befinitiv/cmd-z5-pager/hw/PXL_20261023_195703346.MP.jpg

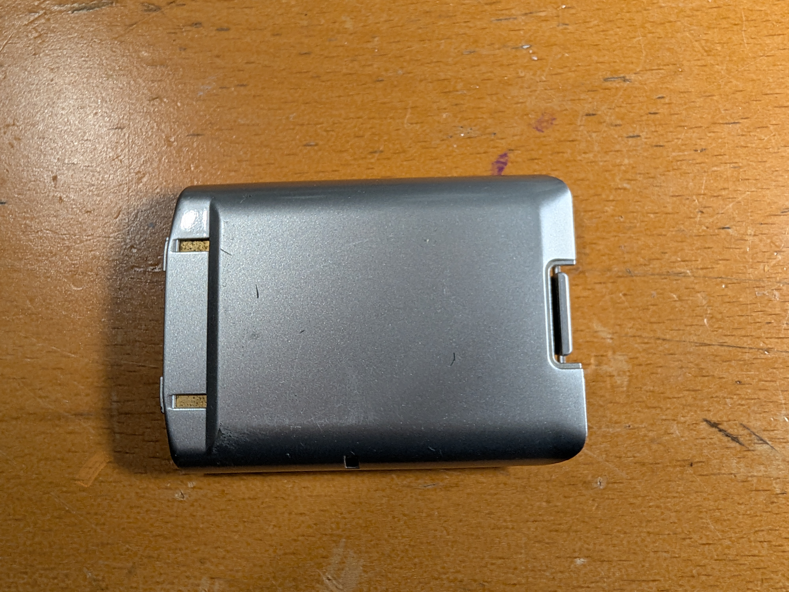
hw/PXL_20261023_195703346.MP.jpg
