befinitiv/cmd-z5-pager/board/kicad/reference/PXL_20261004_193141674.jpg

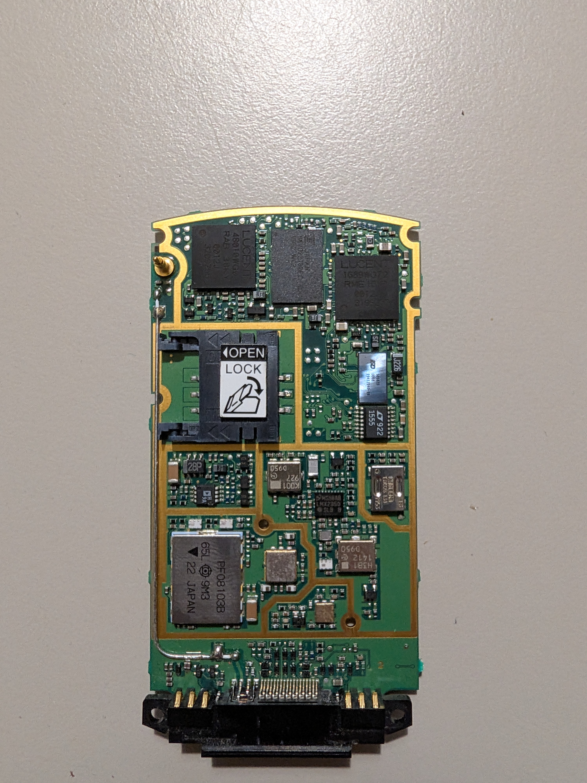
board/kicad/reference/PXL_20261004_193141674.jpg
