befinitiv/cmd-z5-pager/sw/README.md

This document proposes the software architecture for the CMD-Z5 replacement board described in `../board/README.md`. The firmware turns the phone into a standalone Meshtastic and LoRaWAN (TTN) messenger with its own UI and predictive text input. The same code also builds for the PC, where an emulator window stands in for the phone hardware.

Status: phases 1 to 3 are implemented (board definition, emulator, graphics, UI toolkit, menus, hardware test; predictive text with language models for German and English; Meshtastic messaging, tested in the emulator); MeshCore as the other protocol. See [Build and run](#build-and-run) and [Development plan](#development-plan).

# Decisions

| Topic | Decision | Reason |
|---|---|---|
| OS / SDK | Zephyr through the nRF Connect SDK (NCS) | Ready-made drivers for nRF52840, SX1262, nPM1300 (regulators, charger, fuel gauge), LIS2DH12, QDEC, u-blox M10 (GNSS), keypad matrix and USB. Also gives a LoRaWAN stack, BLE, LittleFS/settings, MCUboot and the `native_sim` PC target |
| Meshtastic | Own implementation of the over-the-air protocol, no fork of the Meshtastic firmware | The Meshtastic firmware fills most of the 1 MB flash and has no LoRaWAN. We need only the radio protocol, not the full feature set |
| Phone app (BLE PhoneAPI) | Not in the first version | The architecture leaves room for it (see [Later extensions](#later-extensions)) |
| Predictive text languages | German and English, switchable at runtime | |
| Language model storage | Internal flash, in its own partition | An external SPI NOR flash may come with board rev 2. The model reader only sees a flash area, so the model can move there without code changes |
| PC build | Zephyr `native_sim` with an SDL2 "front panel" | The same kernel, threads, timers, zbus, settings and file system run on the PC. Only the lowest driver layer is swapped |

Assumptions to confirm:

* **Region:** EU868 for both Meshtastic (`EU_868`) and LoRaWAN (TTN EU1).
* **LoRaWAN use case:** periodic uplinks of position and battery, user-triggered text uplinks, and downlinks shown as messages in the inbox.
* **Meshtastic version:** the firmware targets a pinned protobuf release (2.5 or newer, with PKI direct messages).

# Overview

```
┌──────────────────────────────────────────────────────────────────────────┐
│ App / UI   screens: home, inbox, chat, compose, nodes, map/GPS,          │
│            LoRaWAN, settings  ─  screen stack, widgets, status bar       │
├───────────────┬──────────────────────┬───────────────────────────────────┤
│ libtextinput  │ libgfx (2bpp FB,     │ Services (Zephyr threads,         │
│ multitap, T9, │ fonts, icons)        │ connected through zbus)           │
│ n-gram LM,    │                      │  mesh · lorawan · radio arbiter   │
│ user model    │                      │  gps · power · notify · msgstore  │
├───────────────┴──────────────────────┴───────────────────────────────────┤
│ libmeshtastic: protobuf (nanopb), crypto, router, nodedb, port modules   │
├──────────────────────────────────────────────────────────────────────────┤
│ Zephyr device APIs:  input · led · pwm · lora · lorawan · regulator ·    │
│ gnss · charger · fuel gauge · sensor; own: lcd, lcd_bus, audio_out       │
├────────────────────────────────┬─────────────────────────────────────────┤
│ cmdz5 board (nRF52840)         │ native_sim + emulator (SDL2)            │
│ bit-banged LCD bus, gpio-kbd-  │ LCD controller model, PC keyboard and   │
│ matrix, QDEC, PWM audio,       │ mouse wheel, green backlight, 2 audio   │
│ SX1262, nPM1300, LIS2DH12, M10 │ sinks, vibration, radio/GPS/PMIC stubs  │
└────────────────────────────────┴─────────────────────────────────────────┘
```

Rules that keep both builds identical above the driver layer:

1. Application code uses only Zephyr device APIs (`input`, `led`, `lora`, `gnss`, `regulator`, …) and three small custom APIs (`lcd`, `lcd_bus`, `audio_out`). It never touches nRF registers or SDL.
2. The board devicetree and the `native_sim` overlay declare the same node labels (`lcd`, `backlight`, `vibration`, `speaker`, `earpiece`, later `lora0`, `gnss`, `pmic`, …), so `DEVICE_DT_GET(DT_NODELABEL(lcd))` works on both.
3. `libtextinput`, `libgfx` and most of `libmeshtastic` are plain C with no Zephyr dependency. They also build as host unit tests and as a Python extension for the language model tools.

# Directory structure

Entries marked *(later)* do not exist yet.

```
sw/
├── CMakeLists.txt  Kconfig  prj.conf
├── sysbuild.conf  sysbuild/        # board build: MCUboot (single slot, USB serial recovery) + application
├── boards/
│   ├── befi/cmdz5/                  # board definition (HWMv2): dts, pinctrl, defconfig, flash partitions
│   ├── cmdz5_nrf52840.conf          # board-only Kconfig (I2C, PWM, regulators, charger)
│   └── native_sim_native_64.overlay # emulator: same node labels, emulated devices
├── dts/bindings/                    # sony,cmdz5-lcd, cmdz5,lcd-bus-gpio, cmdz5,audio-pwm, cmdz5,sx1262, cmdz5,gps-m10, emulator nodes
├── include/
│   ├── cmdz5/drivers/               # lcd.h, lcd_bus.h, audio_out.h, mesh_radio.h (custom device APIs)
│   └── dt-bindings/cmdz5/keys.h     # key codes without a Zephyr equivalent (CALL, Memo, *, #, lid)
├── drivers/
│   ├── display/cmdz5_lcd.c          # controller driver (init sequence, row writes, contrast, power)
│   ├── display/lcd_bus_gpio.c       # 8080 bus bit-bang, one masked port write per byte on P0.19–P0.26
│   ├── audio/audio_pwm.c            # PCM on PWM1/PWM2 with EasyDMA (8-bit DAC, 62.5 kHz carrier)
│   ├── radio/sx1262_mesh.c          # SX1262 as mesh radio: free sync word, continuous RX, CAD before TX
│   └── gnss/gps_m10.c               # u-blox M10 over NMEA; device PM switches the boost and the UART
├── emul/                            # native_sim only
│   ├── frontpanel.c                 # Zephyr side: input device, state, render thread
│   ├── frontpanel_bottom.c          # host side: SDL2 window, drawing, keyboard/mouse, audio
│   ├── lcd_bus_emul.c               # implements lcd_bus, feeds lcd_ctrl_model
│   ├── lcd_ctrl_model.c             # model of the display controller: registers 03/04/0B → 96×72 2bpp FB
│   ├── led_emul.c  audio_emul.c     # backlight/vibration; speaker/earpiece PCM mixed into SDL audio
│   ├── script.c                     # --script: scripted keys, wheel, lid and screenshots
│   ├── radio_emul.c                 # mesh radio over UDP multicast between emulator instances
│   ├── gps_sim.c                    # feeds Zephyr's GNSS emulator: --gps, --gps-move, --gps-ttff
│   └── battery_emul.c               # simulated battery: current from the emulated outputs, USB from the front panel
├── lib/
│   ├── gfx/                         # 2bpp framebuffer, primitives, fonts, icons, dirty-row tracking
│   ├── ui/                          # screen stack, events, menu, slider, text view
│   ├── textinput/                   # model reader, prediction engine, user model, editor
│   ├── meshtastic/                  # packet codec, crypto (AES, CCM, SHA-256, X25519), channels, router, nodedb
│   ├── meshcore/                    # MeshCore: packets, adverts, Ed25519/SHA-512, client (DMs, ACKs, routes, channels)
│   └── synth/                       # software synthesiser: voices, waveforms, envelopes, melody sequencer
├── src/
│   ├── main.c                       # UI thread and event loop
│   ├── input.c                      # Zephyr input events → UI events, long press
│   ├── hw.c                         # display, backlight, vibration, tones and melodies (lib/synth)
│   ├── power.c                      # backlight and display timeouts, lid, power key
│   ├── battery.c                    # battery sampling (1 s), current averages; backends battery_npm13xx.c / emul
│   ├── i18n.c                       # menu language (English, German)
│   ├── textin.c                     # models, engines and user models per language
│   ├── clock.c  config.c  statusbar.c
│   ├── mesh/                        # mesh service (router thread, identity, nodes), MeshCore mode (meshcore.c), message store
│   ├── services/                    # (later) radio_arbiter, lorawan_svc, gps_svc, notify_svc
│   └── screens/                     # home, menu, settings, hardware test, power off, compose, conversations, chat, nodes; (later) inbox, chat, compose, nodes
├── lm/                              # language models de.lm, en.lm (+ sources and licences)
├── modules/lm_image/                # Zephyr module: model pack for the lm partition, merged.hex
├── cmake/git_version.cmake          # git hash and git describe → app_generated/git_version.h, every build
├── tools/
│   ├── fontconv/                    # BDF → C font headers (X11 misc-misc fonts, public domain)
│   ├── qr/                          # QR code bitmap of the project address for the About screen
│   ├── lmbuild/                     # corpus → n-grams → prune/quantise → .lm; evaluation
│   ├── usb/                         # update.sh (firmware update over USB), udev rule
│   ├── game/                        # level map generator for the jump and run game (1-1, 1-2)
│   └── lcd_replay/                  # (later) replays ../display .dsl captures through lcd_ctrl_model
└── tests/                           # emul/ (smoke.txt, run_mesh.sh, run_meshcore.sh), textinput/, meshtastic/, meshcore/, synth/ and gauge/ (host tests: run.sh)
```

# Hardware abstraction

| Function | Zephyr API / driver (target) | Emulator |
|---|---|---|
| Display 96×72, 2 bpp | `lcd` API → `cmdz5_lcd` → `lcd_bus` (GPIO bit-bang), supply from nPM1300 LDSW1 | `lcd_bus_emul` → `lcd_ctrl_model` → SDL texture, scaled 5× |
| Keypad 4×5 matrix | `input` subsystem, `gpio-kbd-matrix` (supports idle wake through GPIO SENSE) | PC keys and clickable keys on the front panel → `input_report_key()` |
| Rotary wheel | `gpio-qdec` → `INPUT_REL_WHEEL` (GPIO interrupts while idle, so no QDEC current) | mouse wheel, Up/Down keys → `INPUT_REL_WHEEL` |
| Wheel push, bend up/down | keypad matrix row 4 | Space or middle click, Left/Right or PgUp/PgDn (and screen buttons) |
| Lid, power key | `gpio-keys` → `CMDZ5_KEY_LID` (Zephyr has no switch events), `INPUT_KEY_POWER` | `L` key toggles lid (keypad drawn dimmed while closed), `Esc` is the power key |
| Green LEDs (keypad and board) | `led` API on PWM (P0.08), so brightness and fade work | window and keypad area tinted green with the LED brightness |
| Loudspeaker | `audio_out` → PCM through PWM1 EasyDMA on P0.27 (low-side FET) | SDL audio (8-bit like the board), SPK indicator lit |
| Earpiece | `audio_out` → PCM through PWM2 EasyDMA on P0.06 → RC (1 kΩ/10 nF, 16 kHz) → PAM8302 (enabled by LDSW2) | SDL audio, quieter, EAR indicator lit |
| Vibration | `led` API on PWM (P0.07) | display shakes, VIB indicator lit |
| LoRa SX1262 | `mesh_radio` → `sx1262_mesh` (`cmdz5,sx1262`; Zephyr's `lora` API cannot set the Meshtastic sync word 0x2b), power via nPM1300 BUCK1, TCXO on DIO3, RF switch on DIO2 and P0.09 | UDP multicast between emulator instances (`radio_emul`) |
| GPS M10N | `gnss` API → `gps_m10` (`cmdz5,gps-m10`; Zephyr's NMEA parser, factory settings: NMEA at 38400 baud on UART0), 5 V boost EN on P1.03 switched with the UART by device PM | Zephyr's `zephyr,gnss-emul`, switched by device PM and fed by `emul/gps_sim.c` |
| PMIC nPM1300 | `regulator`, `charger` sensor (voltage, current, die temperature, charge and VBUS state); fuel gauge in `src/gauge.c` | simulated battery (`battery_emul.c`): current from the emulated outputs, USB power from the front panel |
| Accelerometer | `sensor` API (`st,lis2dh`), motion trigger | key `A` sends a motion event |
| Microphone | not used in the first version | – |

Three custom APIs are added because Zephyr has nothing suitable (Zephyr's `display` API has no 2 bpp gray format):

* **`lcd`:** `write_rows(fb, first, count)`, `set_contrast()`, `set_power()`. The framebuffer is in the controller's native format, so rows go out without conversion. The application only sends rows that changed.
* **`lcd_bus`:** `write(a0, buf, len)`, `reset()`, `enable()`. The controller driver (`cmdz5_lcd`) sits above it and is shared by target and emulator. The emulator therefore runs the real init sequence and row-addressing code against a model of the controller, which logs a warning for anything the reverse-engineered documentation does not cover. A bug in the driver shows up on the PC before the board exists. `tools/lcd_replay` (later) will feed the logic analyzer captures through the same model.
* **`audio_out`:** a PCM stream per output (`speaker`, `earpiece`): `rate()`, `start(fill, user)`, `stop()`. The output pulls blocks of signed 16-bit samples from `fill()` in its own thread and switches itself off (PWM, amplifier) after a few silent blocks. `src/hw.c` keeps `hw_tone()` and `hw_melody()` and renders them with `lib/synth`; an RTTTL sequencer for ringtones and notifications follows in `notify_svc`. Meshtastic uses RTTTL for its external notification module.

## Sound

**Synthesiser (`lib/synth`):** 4 voices with a band-limited pulse wave (PolyBLEP, any duty cycle), triangle, sine (table) and Game Boy-style noise, attack/decay/sustain/release envelopes, and a melody sequencer with sample-accurate timing on voice 0. Single notes use the other voices, so a key click or a game effect mixes with a running melody instead of cutting it off. Timbres in `src/hw.c`: beeps are short square waves; the loudspeaker plays melodies as a plucked 25 % pulse wave, the earpiece everything as a softer triangle wave. Host tests: `tests/synth/run.sh` (also writes `build-tests/synth_demo.wav`).

**PWM as a DAC (`drivers/audio/audio_pwm.c`):** PWM1 (loudspeaker) and PWM2 (earpiece) count from 16 MHz to 256: an 8-bit duty cycle at a 62.5 kHz carrier, above hearing. Each sample is held for 4 carrier periods, so the sample rate is 15625 Hz. Two EasyDMA sequences of 256 samples (16 ms) play in a loop; at the end of one, an interrupt wakes the audio thread, which renders the next block into it while the other plays. The PWM nodes are disabled for Zephyr's PWM driver; the audio driver uses nrfx and their pinctrl states.

* **Loudspeaker:** a low-side FET switches it between VSYS and ground, so it only sees duty cycles ≥ 0, and a constant mid-level would drive a large DC current through it. Its offset therefore follows the signal peak (`dc-coupled`): the duty cycle swings between 0 and twice the peak, and silence is 0.
* **Earpiece:** the PAM8302 input is AC-coupled (100 nF), so it gets a mid-level offset that ramps up and down in about 8 ms to avoid pops. The 1 kΩ/10 nF RC (16 kHz) in front of it removes most of the carrier.

The HFCLK runs while sound plays; the outputs are switched off about 50 ms after the last sound. The emulator mixes both streams into SDL audio, reduced to 8 bits. Untested on the board: the loudness compared with the earlier square-wave tones, how cleanly the FET-driven loudspeaker plays the PCM, and carrier residue in the earpiece amplifier.

## Emulator details

`native_sim` builds the firmware as a Linux executable. SDL calls must run on the host side of the native simulator, so the front panel is split into a Zephyr-side part (`frontpanel.c`) and a host-side part (`frontpanel_bottom.c`, built against SDL2). This is the same split that Zephyr's own `display_sdl` uses. The SDL event loop is Zephyr's (`boards/native/common/sdl`); the front panel hooks in with `SDL_AddEventWatch`.

Front panel layout: the display at the top (scaled 5×, with the gray levels mixed into the panel colour, which turns green with the backlight), the keypad below it as clickable buttons whose labels glow green with the keypad LEDs, and on the right the wheel, LED/VIB/SPK/EAR/USB indicators, lid switch and power key. Key mapping:

| PC | Phone |
|---|---|
| `0`–`9` (main row or numpad) | digit keys |
| `+` or numpad `*` / `#`, `\` or numpad `/` | `*` / `#` |
| `Enter` | CALL |
| `Backspace` | C |
| `M` | Memo |
| mouse wheel, `Up` / `Down`, click on the wheel | wheel rotate |
| `Space`, middle click | wheel push |
| `Left` / `PgUp` | wheel bend up (back) |
| `Right` / `PgDn` | wheel bend down |
| `L` | toggle the lid |
| `U`, click on the USB indicator | plug or unplug USB power (charges the simulated battery) |
| `Esc` | power key: short = home screen, hold 1.5 s and release = switch off (C major arpeggio, top to bottom); while off, hold 1 s = switch on (restarts the emulator) |
| `F12` | save the display as `cmdz5-screen-NNN.bmp` |

The lid covers only the keypad; the display stays visible. Closing it returns to the home screen and switches the backlight off. Keypad keys are ignored while it is closed, the side controls (wheel, push, bend, power) still work.

Settings are stored in `flash.bin` in the working directory (Zephyr's flash simulator).

After a restart (switching on again) the emulator starts with the same arguments, so a `--script` runs again.

`--script=<file>` runs front panel commands (`wait`, `key`, `press`, `release`, `wheel`, `lid`, `usb`, `shot`, `quit`, see `emul/script.c`) for UI tests and screenshots. With `SDL_VIDEODRIVER=offscreen SDL_AUDIODRIVER=dummy` it runs without a window and sound, e.g. in CI. `tests/emul/smoke.txt` walks through all current screens.

**Emulated radio** (`emul/radio_emul.c`): packets travel as UDP multicast on the loopback interface, so emulator instances on the same machine form a mesh. Each packet carries the radio settings (frequency, bandwidth, spreading factor, sync word); only instances with the same settings receive it. The channel is shared like a real one: a packet goes out when its transmission starts and is delivered at the end of its time on air, so the channel is busy in between. A sender listens before it talks (free channel, then a random backoff of 0–7 slots of 4 symbols, as channel activity detection does on the board). Packets that overlap at a receiver are lost, and the radio cannot receive while it transmits. Options: `--node-num=<hex>`, `--radio-port=<n>` (default 4403), `--radio-off`, `--no-clock` (start without the PC's time, like the board: the time then comes from GPS or the mesh). Run each instance in its own directory, because the settings (and so the node identity) are stored in `flash.bin` in the working directory:

```
mkdir -p /tmp/a /tmp/b
(cd /tmp/a && ~/repos/cmd-z5/sw/build-sim/zephyr/zephyr.exe --node-num=aaaa0001) &
(cd /tmp/b && ~/repos/cmd-z5/sw/build-sim/zephyr/zephyr.exe --node-num=bbbb0002) &
```

**Emulated GPS** (`emul/gps_sim.c`): Zephyr's GNSS emulator (`CONFIG_GNSS_EMUL_MANUAL_UPDATE`), switched on and off through device power management like the real receiver. While it is on, it searches for `--gps-ttff=<s>` seconds (default 8, plus a random 0–3 s, with a few satellites showing up) and then reports the position from `--gps=<lat>,<lon>[,<alt>]`, moving with `--gps-move=<m/s>,<heading>`. Without `--gps` it never gets a fix. Example: two instances 11 km apart, B walking north-east:

```
(cd /tmp/a && ~/repos/cmd-z5/sw/build-sim/zephyr/zephyr.exe --node-num=aaaa0001 --gps=52.52,13.405,34) &
(cd /tmp/b && ~/repos/cmd-z5/sw/build-sim/zephyr/zephyr.exe --node-num=bbbb0002 --gps=52.60,13.50 --gps-move=1.4,45) &
```

# Concurrency and services

All services are Zephyr threads or work-queue items and communicate only through **zbus** channels. The UI never blocks on the radio, and every service can be tested on its own.

| Channel | Producer → consumer | Content |
|---|---|---|
| `input_evt` | input subsystem → UI | key, wheel, lid, power |
| `msg_rx` | mesh_svc, lorawan_svc → msgstore, notify, UI | received text and data |
| `msg_tx` | UI → mesh_svc / lorawan_svc | outgoing message with a tracking ID |
| `msg_status` | mesh_svc → UI | queued, sent, acked, failed |
| `node_update` | mesh_svc → nodestore, UI | NodeInfo, position, SNR, last heard |
| `gps_fix` | gps_svc → mesh_svc, lorawan_svc, UI | position, time |
| `power_state` | power_svc → all | active, dim, screen off, deep sleep; battery level, charging |
| `radio_state` | radio_arbiter → UI | current owner, duty-cycle budget |
| `notify_req` | any → notify_svc | pattern for LEDs, vibration and sound |

## Radio arbiter (Meshtastic and LoRaWAN on one SX1262)

The SX1262 can only listen on one frequency and sync word at a time. Meshtastic needs continuous RX (sync word 0x2B, 869.525 MHz for `EU_868`). LoRaWAN class A only needs the radio for TX and the RX1/RX2 windows (sync word 0x34, 868.1–868.5 MHz, RX2 at 869.525 MHz SF9).

* **Default owner:** Meshtastic, with the radio in continuous RX.
* **LoRaWAN lease:** before an uplink, `lorawan_svc` asks the arbiter for a lease. The arbiter waits until no Meshtastic packet is being received or sent, stops RX, hands the radio to the Zephyr LoRaWAN stack for TX + RX1 + RX2 (about 3 s), then restores the Meshtastic configuration. Meshtastic packets sent during the lease are lost, but the mesh's rebroadcasts and retries usually cover that.
* **Duty cycle:** the arbiter keeps one airtime budget per EU868 sub-band for both protocols (1 % for 868.0–868.6 MHz, 10 % for 869.4–869.65 MHz).
* **Risk:** the Zephyr LoRaWAN subsystem (LoRaMac-node) assumes it owns the radio. Prototype switching between raw `lora` RX and `lorawan_send()` early, on real hardware. If it fails, the fallback is a time-sliced mode with LoRaWAN uplinks only at fixed intervals and the LoRaMac stack paused in between.

## Meshtastic (`lib/meshtastic`, `src/mesh`)

Implemented in phase 3: the over-the-air protocol of current Meshtastic firmware (2.6/2.7). The protocol details were taken from the Meshtastic sources (header layout, nonces, channel hash, frequency slot, presets, flooding rules); no Meshtastic code or generated protobuf code is used, so their GPL licence does not apply to this firmware.

| Module | Content |
|---|---|
| `packet` | 16-byte header (to, from, id, flags with hop limit, want-ack and hop start, channel hash, next hop, relay node); a hand-written protobuf codec for Data, User (NodeInfo), Position and Routing |
| `crypto` | AES-128/256, CTR, CCM, SHA-256, X25519 in plain C. Channel messages: AES-CTR with the channel key, nonce = packet id (64-bit LE) + sender. Direct messages ("PKI"): AES-256-CCM with SHA-256 of the X25519 secret, 8-byte tag + 4-byte extra nonce. Current Meshtastic firmware refuses to send direct messages to nodes without a public key, so PKI is needed to receive DMs |
| `channel` | key expansion (one-byte PSK index → default key), channel hash (XOR of name and key), frequency slot (djb2 of the channel name), presets LongFast … ShortTurbo, regions EU_868, US, EU_433, slot time, time on air |
| `router` | managed flooding: duplicate history, rebroadcast with hop_limit − 1 after an SNR-weighted delay (distant nodes first), cancelled when another node relays first; ACKs for `want_ack`, 3 retries, implicit ACK for broadcasts (hearing a relay), re-ACK of retries, NAK handling; PKI for direct text messages when the key is known, else the channel key |
| `nodedb` | 48 nodes: user info and public key, position, last heard, SNR, RSSI, hops; least recently heard replaced |

The mesh service (`src/mesh/mesh.c`) runs the router in its own thread:

* **Identity:** node number from the chip's device id (emulator: random or `--node-num`), X25519 key pair from the entropy source, default names "CMD-Z5 xxxx" / "xxxx"; all kept in the settings.
* **NodeInfo:** broadcast 5–15 s after the start and every 3 hours; answered when requested; a node that sends something without being known gets our NodeInfo with a request for its own (rate-limited), so keys are exchanged quickly.
* **Messages** (`msgstore.c`): the primary channel and one conversation per node, the newest 40 messages, delivery status queued → sent → delivered / no relay / failed. They are stored in LittleFS (`msglog.c`, `/lfs/msgs.log`): new messages, status changes and read marks are appended as small records and replayed at startup; above 24 KB the log is rewritten with the current messages only. Messages that were still queued when the device stopped are shown as failed.
* **Nodes** with user info and position are stored in the settings and survive a restart (a received position is stored again only after the node moved 100 m, the time last heard at most once a day). The table holds 48 nodes; when it is full, a node without user info is replaced first, else the one heard longest ago, and the replaced node is deleted from the settings too. Nodes with a direct-message conversation are never replaced, so their public keys stay. Direct messages to a node whose key is unknown wait up to 30 s for it: the node is asked for its NodeInfo (current Meshtastic firmware refuses DMs without PKI).
* **Position** (`POSITION_APP`): our position from the GPS service (`src/gps.c`) is broadcast after the first fix, every 15 min, when the sharing setting changes, and after moving 100 m but at most every 30 s (the Meshtastic defaults for `position_broadcast_secs` and smart broadcast). Settings → Position → Share: off, approximate (Meshtastic `precision_bits` 13: rounded to the middle of a cell of about 6 km, "within 2.9 km") or exact (with altitude and satellites). The location source is "internal" for GPS fixes and "manual" for a fixed position. A position request addressed to us (`want_response`) is answered, at most every 10 min per node. Node details show distance and compass direction to a node ("~" when it shares only an approximate position) and the age of its position.
* **Time** (`src/clock.c`): the clock is kept in UTC and ranked by source: none < mesh < GPS (< the PC's time in the emulator). The time field of received Position packets sets it while there is no better time, as stock firmware does ("time from net"): only times after 2026-01-01, not via MQTT, at most 3 hops; the mesh may correct its own time after an hour, and a GPS fix always overrides it. Local time follows Settings → Time zone (UTC, WET, CET (default), EET, US Eastern/Central/Mountain/Pacific) with the EU and US daylight saving rules; the zone is stored under `clock/zone`. The time of received Telemetry packets is used in the same way.
* **Telemetry** (`TELEMETRY_APP`): received device metrics (battery level and voltage, channel utilisation, airtime, uptime) and environment metrics (temperature, humidity, air pressure) are kept per node in RAM, merged because they arrive in separate packets, and shown in the node details. Other variants (power, air quality, ...) are skipped.
* **Relaying:** other nodes' packets are rebroadcast once (managed flooding, see the router). Settings → Mesh → Relay packets switches this off (stored under `mesh/relay`, default on), like Meshtastic's CLIENT_MUTE role: the device still receives and sends its own packets. Diagnostics shows the number of rebroadcasts sent since the start (queued ones that were cancelled because another node relayed first are not counted).
* **New messages:** sound, vibration and the display wakes up. The home screen shows a preview; on other screens a pop-up (`ui_toast()`) shows the sender and the start of the text for 8 s, unless that conversation is open. Push opens the conversation; any other key only closes the pop-up.

Tested on the host (`tests/meshtastic/run.sh`): crypto against FIPS-197 and RFC 7748 vectors and against vectors generated with Python `cryptography`; the LongFast channel hash (8) and the US LongFast frequency (906.875 MHz) as seen on real meshes; router scenarios in a simulated network (two-hop flooding, implicit ACK, encrypted DM over two hops with ACK, fallback to the channel key, retries until failed, lost ACK, relay cancelled in a triangle, foreign channel relayed but not delivered). In the emulator, `tests/emul/run_mesh.sh` lets two instances exchange a channel message, an encrypted direct message and their positions. A test against a stock Meshtastic node needs the board (phase 5).

Not yet: secondary channels, position requests from the UI, sending telemetry, traceroute, next-hop routing (packets are flooded), duty-cycle accounting, the PhoneAPI.

## MeshCore (`lib/meshcore`, `src/mesh/meshcore.c`)

The other protocol: Settings → Mesh → Protocol switches between Meshtastic and MeshCore (stored under `mesh/proto`; the device restarts). The two do not run at the same time. Each protocol has its own identity, nodes, channels and messages (MeshCore's under `mc/` in the settings and in `/lfs/mcmsgs.log`); the name is shared. The device is a MeshCore companion: it sends and receives, but never repeats. The protocol details follow the MeshCore sources (companion 1.18: `Mesh.cpp`, `BaseChatMesh.cpp`, the companion firmware); no MeshCore code is used.

| Part | Contents |
|---|---|
| `packet` | Header (route type, payload type, version), transport codes, path (1–3-byte hashes), payload; packet hash (SHA-256 of type and payload) for duplicates; region scopes: transport code = HMAC-SHA256 with SHA-256 of `#region`; channel keys: Public, hashtag channels (SHA-256 of `#name`) |
| `advert` | Public key, time, Ed25519 signature, type (companion, repeater, room server, sensor), position (1e-6 degrees) and name in 32 bytes |
| `crypto` | SHA-512 and Ed25519 (after TweetNaCl, keys in orlp/ed25519's format as MeshCore stores them), shared secret by X25519 with the Edwards key converted to Montgomery form; AES-128-ECB with a 2-byte HMAC-SHA256 ("encrypt then MAC"). AES, SHA-256 and X25519 come from `lib/meshtastic` |
| `mesh` | The client: duplicate table, transmit queue with delays, DMs with ACK (SHA-256 of time, flags, text and the sender's key), up to 3 attempts (the last by flood), paths learned from PATH packets (with the ACK in them) and returned, group messages ("name: text") and their repeat as delivery check, adverts (zero-hop or flood) |

The mesh service runs it in its own thread (`meshcore.c`):

* **Radio:** the MeshCore app's presets (Settings → Mesh → Preset): EU narrow (869.618 MHz, 62.5 kHz, SF8, CR 4/5, the default), EU long and medium (869.525 MHz, 250 kHz, SF11/SF10), US narrow (910.525 MHz, 62.5 kHz, SF7); sync word 0x12, preamble 32 symbols up to SF8 (else 16), 22 dBm.
* **Region** (Settings → Mesh → Region, e.g. `de-sh`): floods carry the region's transport code. Repeaters set up with regions forward only floods of regions they serve; without a region a flood may not get far.
* **Contacts** come from adverts (signature checked, older adverts of a node ignored) into the node database: number = the first 4 bytes of the public key, short name = the hash byte that stands for the node in paths, role = advert type. They are stored with their route (`mc/n/<num>`). Node details show the type and the route (flood, direct or the repeater hashes).
* **Adverts:** our own (name, position as set under Position → Share) is flooded 10–15 s after the start (once the clock is set, at most 2 min later), every 12 hours, and from Settings → Mesh → Send advert. Advert and message times rise even without a clock (from the last advert's time).
* **Messages:** DMs go along the known route, else by flood; "delivered" when the ACK comes. Channel messages: Public and up to three channels: hashtag channels (`#ping`: the key from the lower-case name, as in the app) or private ones with a passphrase; Settings → Mesh → Channels → Key shows the key in hex for the app. A channel message counts as delivered when a repeater is heard sending it on ("no relay" otherwise). The sender's name of channel messages is in the text; the chat shows it as the header. Texts are limited to 160 bytes (channels: minus the name).
* **Hops** in the chat header: messages by flood show the repeaters they passed ("2 hops"); messages along a route do not tell, so the header shows the length of our route back to the sender instead ("route 1 hop", "direct").
* **Time:** from messages and companions' adverts (at most 3 hops), as for Meshtastic.

Tested on the host (`tests/meshcore/run.sh`): SHA-512 (FIPS 180-4), Ed25519 (RFC 8032 and vectors from Python `cryptography`), shared secrets (Python, and MeshCore's own test key pair), AES decryption (FIPS-197), HMAC (RFC 4231); the Public channel hash (0x11), the `#ping` key and a `de-sh` transport code; advert round trip and forgery; a simulated A–repeater–B network: adverts, flooded DM with PATH/ACK and learned routes in both directions, direct DM, 160-byte limit, channel message and its repeat, retries with a broken route ending in a flood, failure, scoped and unscoped floods at a regional repeater, hashtag channels. In the emulator, `tests/emul/run_meshcore.sh` lets two instances (`--meshcore`) exchange adverts, a channel message and an acknowledged DM.

Not yet: logins to repeaters and room servers, CLI commands, telemetry requests, traces, a channel QR code for the app.

## LoRaWAN (`lorawan_svc`)

Uses the Zephyr LoRaWAN subsystem (OTAA, EU868, class A). DevEUI, JoinEUI and AppKey are entered in the settings or over the USB shell and stored with the settings subsystem. The DevNonce is kept persistently because LoRaWAN 1.0.4 requires it. Uplinks: Cayenne LPP for position and battery (so TTN decodes them without a custom formatter), and port 10 for UTF-8 text. Downlinks appear in the inbox as a "TTN" conversation.

## GPS (`src/gps.c`)

The GPS service switches the receiver (Zephyr GNSS device `gnss`) through device power management, takes its fixes from the GNSS data callback and passes new positions to the mesh. Modes (Settings → Position → GPS):

| Mode | Receiver | Position |
|---|---|---|
| off | off | none |
| fixed | off | the position entered under "Fixed position" (degrees, e.g. `52.52 13.405`, south and west negative) or taken from the last fix with "Use GPS fix" |
| 5 / 15 (default) / 30 / 60 min | on at the start and then every interval, until 3 fixes in a row with HDOP ≤ 5 or for at most 120 s | the last good fix |
| always | on | the latest fix |

While the GPS screen is open the receiver stays on. A fix sets the clock when it has no GPS time yet or is more than 2 s off. The GPS screen shows the state (searching with time and satellites, fix, off, fixed), the coordinates, altitude, HDOP and the age of the fix, or the speed when moving; push opens the position settings.

On the board the receiver is a TBS M10N (u-blox M10, firmware SPG 5.10, protocol 34.10; GPS, GLONASS, Galileo, BeiDou, SBAS, QZSS) on UART0 at its factory settings (NMEA at 38400 baud, one fix per second). `drivers/gnss/gps_m10.c` feeds GGA and RMC to Zephyr's NMEA 0183 parser; resuming the device switches on the 5 V boost (P1.03) and opens the UART, suspending closes the UART, puts its pins to their sleep state (so they cannot back-power the receiver) and switches the boost off. Zephyr's `gnss-nmea-generic` driver cannot be suspended, and its u-blox driver is for the M8. MCUboot leaves UART0 disabled. Tested indoors: switching on and off, NMEA arriving and parsed (no fix yet); a fix outdoors is still to be tested. Every fix from power-on is a cold start (~30 s) unless the TBS M10N keeps its almanac with a backup supply, which still needs checking.

## Power (`power_svc`)

| State | Display | Backlight | LoRa | GPS | Typical entry |
|---|---|---|---|---|---|
| Active | on | on | RX | per setting | key press, lid opened |
| Dim | on | off | RX | per setting | light timeout (default 10 s, can be "never"), lid closed (also returns to the home screen) |
| Screen off | off (LDSW1 off) | off | RX | per setting | screen timeout (default never) |
| Low power | off | off | off (BUCK1 off) | off | user choice, or low battery |
| Off (ship mode) | – | – | – | – | power key held 1.5 s and released; battery empty (below 3.3 V for 10 s without USB, `BATTERY_EMPTY_MV`: the cell is at 0 % there, its protection would only cut off at 2.75 V). Hold the power key about 1 s to switch on again (`ship-to-active-time-ms`). With USB connected the PMIC cannot stay in ship mode: the firmware restarts into an off state instead (`hw_boot_off()`, marked in GPREGRET2): display, mesh and GPS off, the battery charges; holding the power key 1.5 s switches on, unplugging USB enters ship mode |

`power_svc` enforces the rules from the board README: drive or float the signal lines of switched-off parts, rows on SENSE, columns low. Waking in low-power mode comes from keys, lid, power key, accelerometer or RTC (for scheduled LoRaWAN uplinks). Zephyr device runtime PM switches off the drivers; the nPM1300 regulators are switched through the `regulator` API. Charger setup (current, termination voltage, NTC disabled) happens early in boot, because the nPM1300 starts with charging disabled.

### Battery and current measurement (`src/battery.c`)

A thread samples the battery once a second. On the board the nPM1300 charger driver measures battery voltage, current and die temperature (the battery has no NTC, so the die temperature stands in for it), plus the charge and VBUS state. The fuel gauge (`src/gauge.c`) turns these into the state of charge and the times to empty and full; its state of charge is stored in the settings (`batt/g`) every 6 hours and before switching off. The emulator simulates the battery instead: a cell as the gauge assumes it, charged like on the board, whose current follows the emulated outputs with the estimates below (radio RX 4.5 mA, TX 110 mA, backlight 15 mA, vibration 80 mA, speaker 60 mA, earpiece 15 mA; the display is not counted), quantised like the nPM1300 ADC and fed through the same gauge.

The current resolution follows the discharge limit in the devicetree: full scale is 1.12 × the limit, 10 bits. With the 1 A limit one step is 1.1 mA, so single readings of the 4.5 mA receive current are coarse; the averages over a minute and an hour smooth this out. The 200 mA limit would give 0.22 mA steps, but the battery could then not supply transmit, loudspeaker, vibration and backlight at the same time. Currents in the µA range (low-power mode) are below the resolution and need an external meter such as the PPK2.

**Diagnostics** (main menu) shows charge, voltage, supply (battery, USB charging, charged, charger error), the latest current, the averages over the last minute and hour, the charge drawn since the start, the time to empty or to full, the temperature and the uptime. The status bar shows the charge and a lightning bolt while USB power is present.

**Cell and fuel gauge:** the cell is a 603450 LiPo (3.7 V, 4.2 V charge voltage, 1250 mAh nominal, 1100 mAh typical, protection circuit) with a JST PH 2.0 plug, connected to J8. It is charged at 400 mA (about 0.33 C) until the current falls to 10 % (40 mA). nRF Fuel Gauge would need a model made by profiling the cell with the nPM1300 EK and nPM PowerUP, so `src/gauge.c` is a simple gauge built on assumptions instead: 1100 mAh usable, about 200 mΩ internal resistance with the protection circuit and wires (to be measured: the voltage drop when the GPS adds 160 mA) and a typical LiPo open-circuit voltage curve. It counts the measured current, sets 100 % when the charger reports complete, and pulls the count towards the voltage estimate when the battery has been nearly at rest (< 30 mA) for 5 min: slowly (1 h) and only beyond 5 %, because the curve is flat in the middle, faster near empty. While the charger is in its constant-current phase it shows at most 95 %. The host test (`tests/gauge/run.sh`) runs it against a worse cell (950 mAh, 240 mΩ, a current offset) over a day with GPS bursts: it overestimates by at most 5 % and is at 0 % when the cell is empty. A discharge cycle on the board, logged to LittleFS, would replace the assumptions with measured values.

## Storage

| Data | Mechanism | Location |
|---|---|---|
| Settings, node identity and keys, known nodes, learned words | Zephyr settings on NVS | `storage` partition (32 KB) |
| Messages | LittleFS, append-only log | `lfs` partition (96 KB) |
| Language models | read-only pack, memory-mapped | `lm` partition (352 KB; later on external flash) |

# User interface

## Display and graphics (`lib/gfx`)

The framebuffer is 96 × 72 pixels at 2 bpp = 1728 bytes, in the native format of the display (24 bytes per row, MSB = leftmost pixel). `gfx` keeps a dirty bit per row, and `cmdz5_lcd` only sends changed rows (29 bytes each). Fonts: a proportional 5×7 font (about 18 characters per line) for text, a 3×5 font for the status bar, a large digit font for the clock, all with German characters. The 4 gray levels are used for anti-aliasing, selection bars and disabled items.

LVGL was considered and rejected: it costs 100+ KB of flash and does not fit this display.

## Layout

The status bar (battery, mesh/LoRaWAN state, GPS, unread messages, time; 7 px) is shown only on the home screen. All other screens use the whole display, so menus show 7 rows and the compose screen 7 lines of text.

```
┌────────────────────────────┐  compose screen
│T9 Abc DE             17/200│  y 0–6    input mode, language, length
│Ich gut bin Mate|           │  y 7–62   text (7 lines at 8 px), word being typed
│                            │           underlined, completion part in gray
│                            │
├────────────────────────────┤
│[gut] Hut gute guten        │  y 63–71  candidate bar (wheel selects, push accepts)
└────────────────────────────┘
```

## Toolkit (`lib/ui`)

A small retained-mode toolkit: a screen stack with `on_enter`, `on_event`, `render` and `on_exit`, and widgets for list/menu, text view with wheel scrolling, text field, candidate bar, number/hex entry, toggle and progress bar. Screens subscribe to zbus channels and redraw only when data changes.

## Key roles

| Key | Navigation | Text entry |
|---|---|---|
| Wheel rotate | move selection, scroll | move through the candidates (also into the next-word predictions); in cursor mode: move the cursor (up = back) |
| Wheel push | select / open | accept the selected candidate, with a space |
| Wheel bend up | back (long: home screen), same as C | back; the draft is kept |
| Wheel bend down | page down; on the home screen: the games menu (Z5 Jump, Hexenflug); in Messages: a menu for the selected conversation: silence it (no sound, vibration, pop-up or wake-up; marked with a crossed speaker; stored per protocol, up to 8) or delete its messages (asks first) | still open |
| CALL | send / confirm | send message (phase 3) |
| C | back (long: home screen) | delete a key or the character before the cursor (long: the word before it, and while held one more word every 350 ms); back when the text is empty |
| Memo | context menu | symbol and smiley picker |
| `2`–`9` | select menu entry | add a key to the word (long: the digit) |
| `#` | – | input mode: T9 → multitap → 123 (long: input language) |
| `*` | – | cursor mode on/off: the cursor blinks and the wheel moves it (typing or push ends it); long: case Abc / abc / ABC |
| `0` | – | accept the word and add a space (long: `0`) |
| `1` | – | punctuation `. , ? ! ' - : ; ( ) @ /`, press again for the next one; `. ! ?` replace the space after an accepted word, the others keep it (`hallo :)`) |

In text entry the keys act when released, so that a long press can do something else.

## Z5 Jump (`src/screens/game.c`)

A small jump and run in the style of the Game Boy platformers, opened from the games menu (the wheel bent down on the home screen). Levels of 8×8 tiles scroll to the right; each starts with a short "WORLD 1-x" screen, and after the last one the game continues with the first.

* **1-1, overground:** ground with pits, pipes, bricks, ? blocks with coins, M blocks with a grow item (absorbs one hit, breaks bricks), walkers (jump on them, or bump the block they stand on), staircases and a flag at the end. Holding the jump key jumps higher.
* **1-2, under water:** each jump key press is a swim stroke; the hero sinks slowly and cannot leave the water. Coral passages and walls, seaweed, rising bubbles. Fish swim straight ahead and jellies sink while the hero is below them, then push up towards the hero; neither can be stomped. The level ends in an exit pipe.

Score, coins (100 = extra life), lives, a timer, and the best score in the settings (`game/hi`). `START_LEVEL` in `game.c` selects the level the game starts with (for testing).

Keys: `4`/`7` left, `6`/`9` right, `2`/`5`/`8`/`0` or wheel push jump, `1`/`3` jump to the left/right, CALL pause, C or wheel bent up leaves. In the emulator, several keys can be held at once (e.g. `6` and `5`).

The game runs at 30 steps per second; while it is open, the main loop wakes every 33 ms instead of 200 ms (`app_set_frame_ms`). It pauses while the display is off and keeps the backlight on while playing. The level maps are generated by `tools/game/level.py` into `src/screens/game_level.h`. The frame rate and the STN response on the real display (smearing while scrolling) are untested.

## Menu language

The menus are in English or German (default German; Settings → Language, stored with the other settings). Strings stay English in the code and are translated when drawn: `tr("Settings")` in the application, and the UI library passes titles, menu labels and its own texts through the same hook (`ui_set_translator()`). The German table is in `src/i18n.c`; a missing entry falls back to English. Texts must stay short: a menu row holds about 18 characters.

## Screens

Home (clock, battery; with unread messages a preview: sender, count and the start of the newest text) · Inbox (channels, DMs, TTN; wheel bent down deletes a conversation after asking) · Chat (scrollback with delivery state: queued / sent / acked; received messages alternate the time with RSSI and SNR, or the hop count if relayed) · Compose · Nodes (list sorted by last heard, detail with distance and bearing from GPS, SNR, hops; start a DM or traceroute) · GPS (state, satellites, position, age; the receiver stays on while it is open) · LoRaWAN (join state, last uplink, send now) · Diagnostics (battery, current consumption) · Games (wheel bent down on the home screen: Z5 Jump, Hexenflug) · Settings (Factory reset: erases all settings and messages and restarts · Mesh: name, region, preset, channels and PSK · Position: GPS mode, sharing, fixed position · LoRaWAN: keys, interval · Display: contrast, backlight timeout · Sound: ringtone, vibration, earpiece/speaker · Input: languages, learn words on/off, reset dictionary · Language · Time zone · Power) · About (git commit and version, Zephyr version, build date; push shows a QR code with the project address https://github.com/befinitiv/cmd-z5-pager).

# Predictive text (`lib/textinput`)

Implemented in phase 2. `lib/textinput` is plain C without Zephyr or dynamic memory; the same code runs on the board, in the emulator, in the host tests and, through ctypes, in the Python evaluation.

## Input methods

* **Predictive (T9):** one key press per letter. The candidate bar shows the exact matches and completions (longer words) ranked by context; the word being typed shows the first candidate, with the not yet typed part of a completion in gray. German letters map to their base key (ä→2, ö→6, ü→8, ß→7).
* **Next-word prediction:** after a space the bar shows the likely next words. Turning the wheel selects one, push accepts it.
* **Multitap (abc):** classic letter cycling with a 1 s timeout, including ä ö ü ß on the German keys. Words spelled this way are learned and offered in predictive mode from then on.
* **Words not in the lexicon:** a key after which no word fits is ignored, with a short low tone; such words are typed in multitap (`#`) and learned, so predictive mode offers them next time. Switching to multitap for the rest of the word, compound splitting and a letter n-gram guess were tried and did not work out in use.
* **Numeric (123)**, **punctuation** on key 1 and a **symbol picker** (Memo) with accented letters and smileys. While a key 1 character is pending, the bar at the bottom lists all its choices with the current one highlighted, like the word suggestions; pressing 1 again or turning the wheel moves through them, push accepts.
* **Case:** Abc (capital at the start of a sentence), abc (as typed or as in the lexicon, so German nouns keep their capital), ABC.
* **Cursor:** `*` switches the wheel from the candidates to moving the cursor through the text (the cursor blinks). Text is inserted and deleted at the cursor; predictions use the words before it.

## Engine

For each key press `ti_predict()` collects candidates and ranks them:

1. **Lexicon lookup:** the key sequence gives an id range: exact matches first, then all completions.
2. **Context:** cost `-log2 P(w | w-2, w-1)` from the trigram model with backoff to bigrams and unigrams (absolute discounting with backoff weights). This is where the previous words come in: after "Mir geht es" the keys `488` give "gut", after "Ich trage einen" they give "Hut".
3. **Candidates for completions:** the successors of the context that fall into the key range, plus the 24 most frequent words of the range.
4. **User model:** counts of the words and word pairs the user typed (64 words, 128 pairs, about 3.6 KB per language, stored in the settings when the compose screen is left). Unknown words are stored with their spelling.
5. **Conversation cache:** the last 48 words of the conversation get a boost.
6. **Mixture:** `P = 0.82 P_lm + 0.08 P_user(w | w-1) + 0.05 P_user(w) + 0.05 P_cache(w)`. Completions get a penalty of 5 bits against exact matches (tuned so that the first shown word is almost as often right as with exact matches only).

## Model format and size

Built offline per language by `tools/lmbuild` (`build_models.sh` downloads the corpora and rebuilds both models; `build.py` and `evaluate.py` can also be run on their own):

1. Corpus: Tatoeba (short conversational sentences) and the Leipzig web corpus, see `lm/README.md` for sources and licences. Tatoeba's example names Tom, Mary and Maria appear in up to 23 % of its sentences and are downsampled.
2. Tokenise; numbers and unusable tokens break the context, commas are transparent. Sentence-initial words are truecased; case variants are separate words if each is common (German "Sie" and "sie").
3. Vocabulary: the 20 000 most frequent words (web junk and single letters other than "a"/"I" removed).
4. Count unigrams, bigrams and trigrams (numpy), estimate with absolute discounting, prune by count-weighted change of log probability until the byte budget is reached (30 % of the n-gram budget for trigrams).
5. Encode (format in `tools/lmbuild/lmformat.py`, reader in `lib/textinput/src/model.c`):
   * lexicon sorted by key sequence, front-coded in blocks of 32 words with canonical Huffman codes for the shared prefix length, the letters and the case: 24–26 bits per word;
   * unigrams as 6-bit costs;
   * bigram and trigram tables with Rice-coded id gaps, 4-bit quantised costs and backoff weights (Lloyd codebooks), anchors every 16 contexts; a trigram context is the index of its bigram: 20 and 25 bits per entry.

| Part (per language) | German | English |
|---|---|---|
| Lexicon (20 000 words) | 64 KB | 60 KB |
| Unigrams | 15 KB | 15 KB |
| Bigrams | 70 KB (28 483) | 73 KB (29 838) |
| Trigrams | 30 KB (9 763) | 31 KB (10 086) |
| **Total** | **176 KB** | **176 KB** |

## Evaluation

`evaluate.py` simulates typing 2 000 held-out sentences with the C engine. Keystrokes per character (KSPC; each word's space counts as a character and a key):

| Method | German | English |
|---|---|---|
| Multitap | 1.97 | 1.93 |
| Classic T9 (frequency only) | 1.02 | 1.01 |
| T9 with context | 1.01 | 1.01 |
| **Full: context + completions + next-word prediction** | **0.68** | **0.69** |
| First exact match correct, frequency only | 90.5 % | 94.8 % |
| First exact match correct, with context | 93.6 % | 97.0 % |
| Words picked before pressing a key | 21.7 % | 25.9 % |
| Words not in the lexicon (OOV) | 5.0 % | 1.1 % |

"Full" assumes the user picks a word from the first three candidates as soon as it appears there. Context removes about a third (German) to 40 % (English) of the wrong first guesses of classic T9. The user model cannot be measured this way (the held-out text is not one person's writing); it helps with names and the user's own phrases.

## Flash budget (1 MB internal)

| Partition / part | Size |
|---|---|
| MCUboot (single slot, USB serial recovery) | 64 KB (55 KB used) |
| Application: Zephyr, drivers, LoRaWAN, Meshtastic + crypto, UI, fonts, text engine | 380–450 KB |
| Settings + LittleFS | 128 KB |
| Language models, German + English | 352 KB (2 × 176 KB) |
| Reserve (BLE stack for the PhoneAPI needs about 120 KB) | rest |

On the board the models live in the `lm` partition as a pack (`tools/lmbuild/pack.py`: a small directory of language, offset and size, then the models), read in place from the memory-mapped flash; the application itself is 143 KB after phase 3. The two models fill the 352 KB partition up to 868 bytes. The emulator links the models into the program. The budget is tight. `lmbuild` takes the partition size as a target and prunes until the model fits. The `lm` partition can be updated separately from the application over USB (mcumgr). With an external SPI NOR flash in rev 2, the models move there and can be 5–10 times larger (bigger vocabulary, full trigrams, optionally a small neural re-ranker).

# Build and run

The firmware is a freestanding Zephyr application built against nRF Connect SDK **v3.4.1** (Zephyr 4.4.2) with Zephyr SDK **1.0.1**. One-time setup, in a workspace outside this repository:

```
sudo apt install libsdl2-dev                 # emulator only
mkdir -p ~/ncs && cd ~/ncs
python3 -m venv .venv && . .venv/bin/activate && pip install west
west init -m https://github.com/nrfconnect/sdk-nrf --mr v3.4.1 v3.4.1
cd v3.4.1 && west update --narrow -o=--depth=1
pip install -r zephyr/scripts/requirements-base.txt -r nrf/scripts/requirements-build.txt
# Zephyr SDK 1.0.1: minimal bundle plus the arm-zephyr-eabi toolchain, unpacked to
# ~/ncs/zephyr-sdk-1.0.1 (toolchain in gnu/), then: ./setup.sh -c
```

Each shell:

```
. ~/ncs/.venv/bin/activate
export ZEPHYR_BASE=~/ncs/v3.4.1/zephyr ZEPHYR_SDK_INSTALL_DIR=~/ncs/zephyr-sdk-1.0.1
```

Build, in `sw/`:

```
west build -b native_sim/native/64 --no-sysbuild -d build-sim .     # emulator
./build-sim/zephyr/zephyr.exe

west build -b cmdz5/nrf52840 --sysbuild -d build-board .           # board: MCUboot + application
tools/usb/update.sh                                                 # USB: application
west flash -d build-board                                           # SWD (J-Link): MCUboot, application + language models
```

The board build uses sysbuild (`sysbuild.conf`, `sysbuild/`): MCUboot and the application, signed for MCUboot. `west flash` writes MCUboot and `merged.hex`: the signed application and the language model pack for the `lm` partition (built by `modules/lm_image`, a small Zephyr module, because the flash runner is configured before the application's own CMake code runs). Without the models the device still works; text input then offers multitap and 123 only.

**Updates over USB.** Flash layout: MCUboot 0x00000–0x10000, one application slot 0x10000–0x88000 (480 KB), then `lm`, `storage` and `lfs`, which an update does not touch. With a single slot there is no rollback: the new application overwrites the old one, and MCUboot stays reachable if it does not start. Ways into MCUboot's USB serial recovery (`CMD-Z5 bootloader` on USB, SMP protocol):

* the 1200-baud touch: open the application's port at 1200 baud (`stty -F /dev/ttyACM0 1200`), as for Arduino and Meshtastic nRF52 boards; `src/update.c` sets the boot mode (GPREGRET1) and restarts,
* Settings → Firmware update on the device,
* the power key still held 10 s after switching on (MCUboot reads P1.06; the long delay keeps the ~1 s wake-up press from ship mode out of recovery, and MCUboot only waits while the key is held),
* no valid application in the slot.

`tools/usb/update.sh [image]` does the touch, uploads `build-board/sw/zephyr/zephyr.signed.bin` with `smpmgr` (`pipx install smpmgr`) and restarts, about 25 s in all; its `ENOTSUP` messages (a parameter query MCUboot does not answer) are harmless. MCUboot leaves recovery only with an SMP reset (`smpmgr --port … os reset`) or a power cycle. Images are signed with MCUboot's default development key (the build warns about it): MCUboot rejects images that are not signed, but anyone can sign with that key. On Linux, ModemManager probes new serial ports and can swallow the first boot messages; `tools/usb/99-cmdz5.rules` keeps it away.

On the board the log and console go to USB CDC ACM (`/dev/ttyACM0`, e.g. `picocom /dev/ttyACM0`; any baud rate), because the only UART belongs to the GPS. The port keeps up to 8 KB of output until the host opens it, so the boot messages are not lost; open the port only once (a separate `stty` drains them). SEGGER RTT stays a second log backend for the J-Link.

Fonts are generated with `tools/fontconv/gen_fonts.sh`; the generated headers are committed. The same holds for the About screen's QR code (`tools/qr/gen_qr.py`, needs the Python `qrcode` module). The git hash and version (`git describe --tags --always --dirty`, e.g. `R0-15-g783be4a`) are read on every build by `cmake/git_version.cmake`; the About screen marks a build with uncommitted changes with a `+` after the hash.

The language models are rebuilt with `tools/lmbuild/build_models.sh` (needs numpy; downloads about 170 MB of corpora once); the built `lm/*.lm` files are committed. Host tests of the text input library: `tests/textinput/run.sh`.

# Development plan

| Phase | Content | Needs hardware |
|---|---|---|
| 1 ✅ | Board definition, `native_sim` front panel (display model, keys, wheel, LEDs, audio), `gfx` + `ui`, home, menu, settings and hardware test screens | no |
| 2 ✅ | Multitap, `lmbuild` pipeline, T9 with n-gram ranking and next-word prediction, user model, evaluation, compose screen | no |
| 3 ✅ | Meshtastic codec, crypto with test vectors, router, nodedb, conversations/chat/nodes screens, mesh settings, UDP radio between emulators | no |
| 4 | Board bring-up: nPM1300 charger and rails, LCD bit-bang driver, keypad, QDEC, LEDs, vibration, PWM audio. Battery measurement, fuel gauge and diagnostics screen are written and run in the emulator | yes |
| 5 | SX1262 on the board, over-the-air test against a stock Meshtastic node | yes |
| 6 | LoRaWAN on TTN, radio arbiter, duty-cycle accounting | yes |
| 7 | GPS on the board (driver and power switching done; a fix outdoors still to be tested), power states, measuring the <20 µA low-power current | yes |

Phases 1–3 can run before the boards arrive.

# Later extensions

* **Meshtastic PhoneAPI** over BLE and USB serial (ToRadio/FromRadio), so the official app can configure the device.
* **External SPI NOR flash** (rev 2, CS on P0.04, shared bus with the SX1262): larger language models, more message history.
* **Neural re-ranker** for predictive text (small int8 GRU or transformer over the top-k n-gram candidates).
* **Microphone:** voice notes are not practical over LoRa, but the microphone could serve as a clap or noise detector.
* **Firmware update** over BLE (needs MCUboot dual slot and so the external flash; over USB it works already, see [Build and run](#build-and-run)).

# Open points

* Update the language models separately from the application (mcumgr image upload to the `lm` partition).

* The display controller is unknown, and its init sequence has not been tested on real hardware. The emulator models only the behaviour documented in `../display/DOCUMENTATION.md`.
* Meshtastic protocol changes between releases: the implementation follows firmware 2.7; check new releases (e.g. next-hop routing, signed packets).
* SX1262 on the board (`drivers/radio/sx1262_mesh.c`): sends on EU_868 LongFast (869.525 MHz, 22 dBm, the chip's maximum); reception from a stock Meshtastic node and the RF switch polarity (P0.09 high while receiving) are still to be tested over the air. BUCK1 stays on while the mesh runs (about 5 mA in RX); switching it off in low-power mode is still to do.
* The fuel gauge rests on assumptions about the cell (capacity, voltage curve, internal resistance); see [Battery and current measurement](#battery-and-current-measurement-srcbatteryc). Not yet checked over a full cycle on the board.
* Radio sharing between Meshtastic and the Zephyr LoRaWAN stack (see [Radio arbiter](#radio-arbiter-meshtastic-and-lorawan-on-one-sx1262)).
* Licences: no Meshtastic code is used (protocol re-implemented). The language models are CC BY derived works of their corpora (see `lm/README.md`).
