befinitiv/cmd-z5-pager/hw/202610232158.pdf

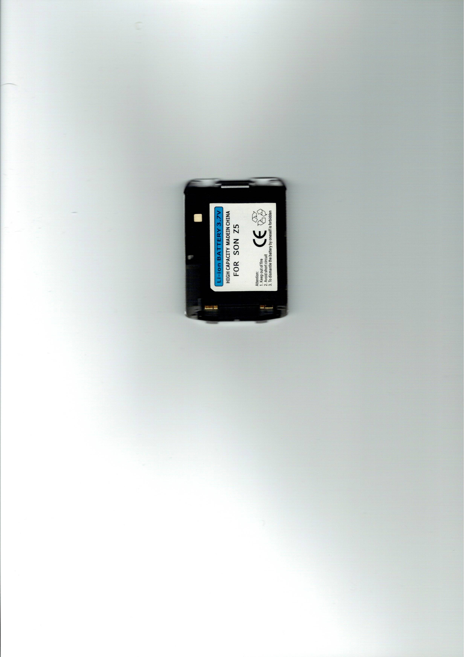
[picture p3: page 1]
