befinitiv/cmd-z5-pager/board/kicad/202610022107.pdf

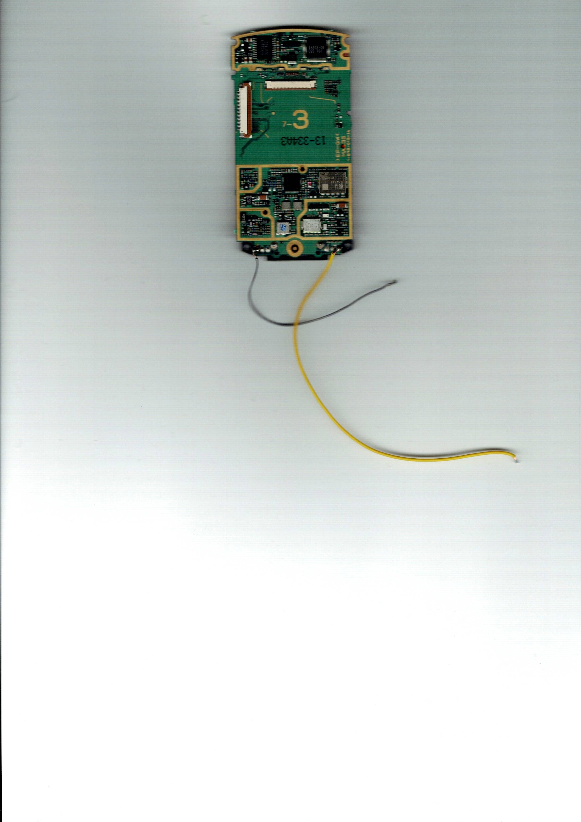
[picture p4: page 1]
