befinitiv/cmd-z5-pager/board/kicad/reference/original_board_back_aligned.png

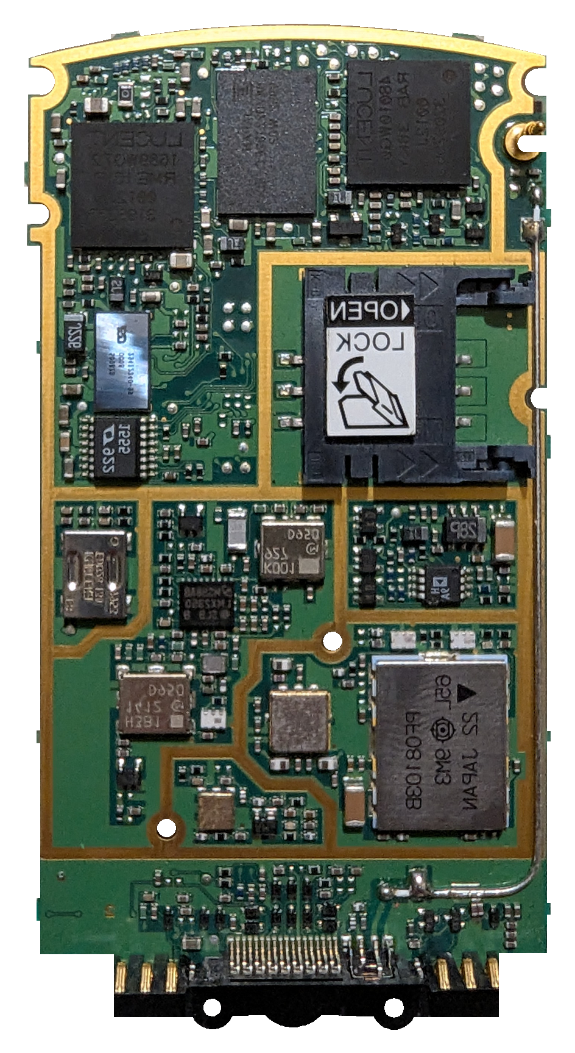
board/kicad/reference/original_board_back_aligned.png
