befinitiv/cmd-z5-pager/board/kicad/reference/original_board_scan_300dpi.png

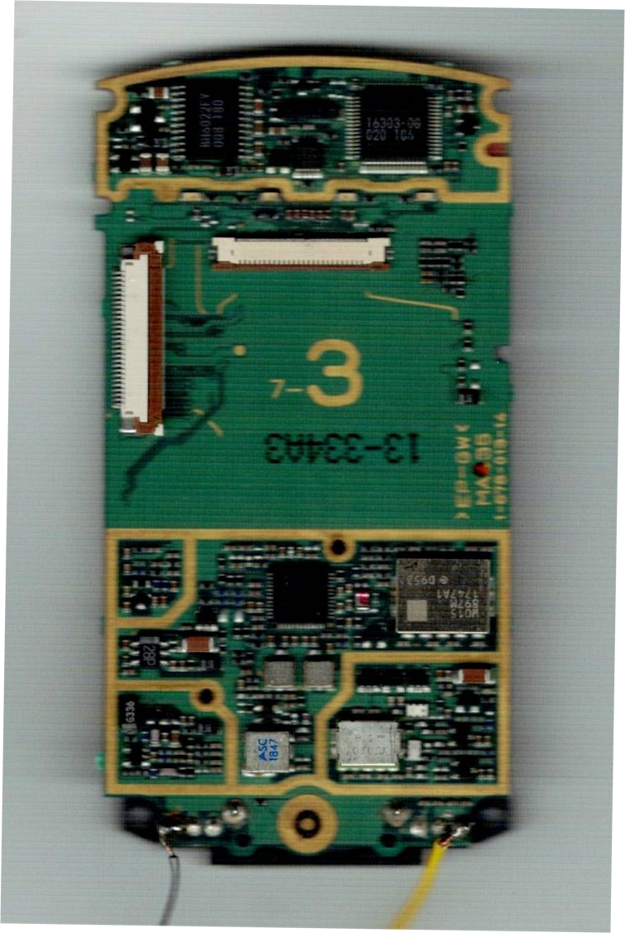
board/kicad/reference/original_board_scan_300dpi.png
