befinitiv/cmd-z5-pager/board/kicad/reference/PXL_20261003_192435034.jpg

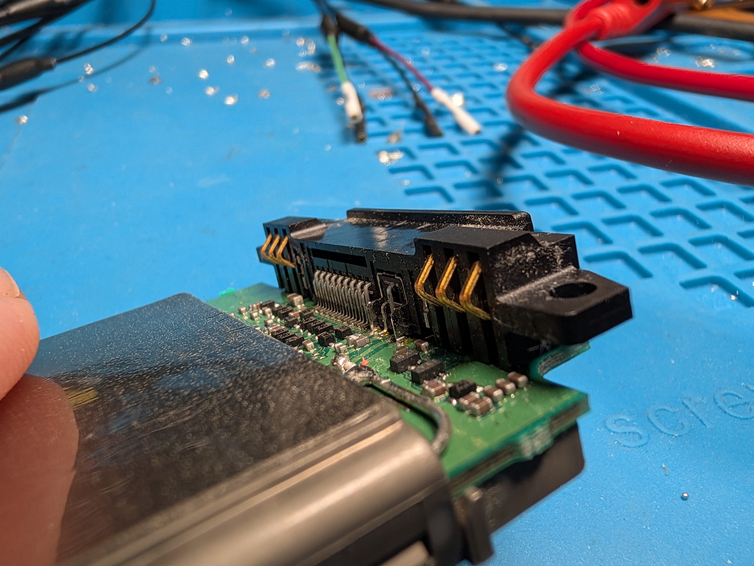
board/kicad/reference/PXL_20261003_192435034.jpg
