befinitiv/cmd-z5-pager/display/frames/002_001.122s.png

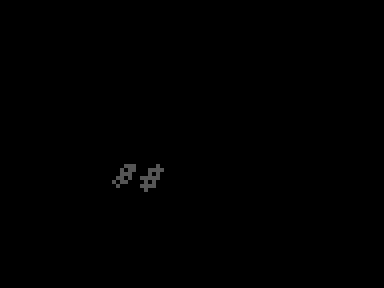
display/frames/002_001.122s.png
