befinitiv/cmd-z5-pager/display/frames/007_001.676s.png

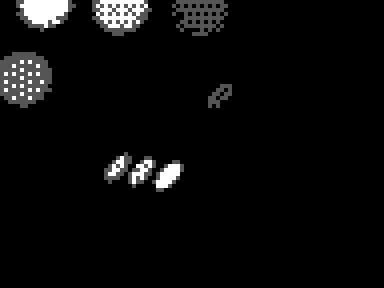
display/frames/007_001.676s.png
