befinitiv/cmd-z5-pager/display/frames/008_001.787s.png

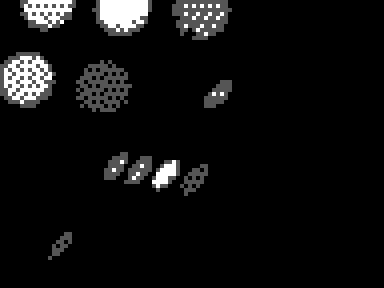
display/frames/008_001.787s.png
