befinitiv/cmd-z5-pager/display/frames/009_001.898s.png

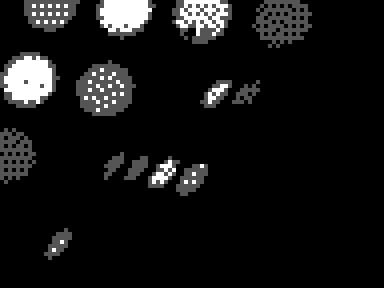
display/frames/009_001.898s.png
