befinitiv/cmd-z5-pager/display/frames/010_002.009s.png

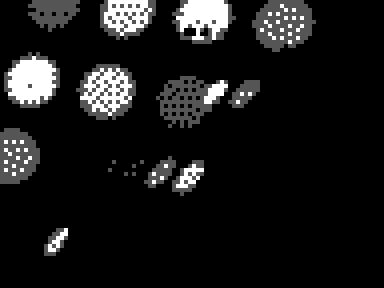
display/frames/010_002.009s.png
