befinitiv/cmd-z5-pager/display/frames/011_002.130s.png

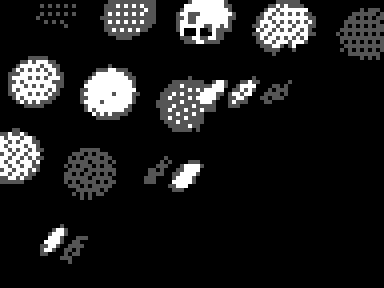
display/frames/011_002.130s.png
