befinitiv/cmd-z5-pager/display/frames/013_002.352s.png

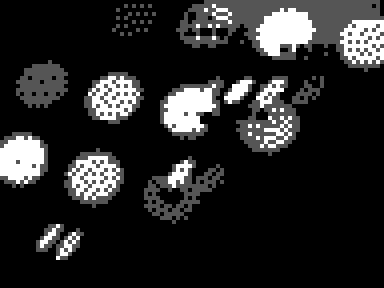
display/frames/013_002.352s.png
