befinitiv/cmd-z5-pager/display/frames/014_002.463s.png

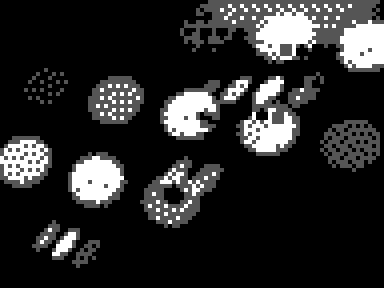
display/frames/014_002.463s.png
