befinitiv/cmd-z5-pager/display/frames/016_002.684s.png

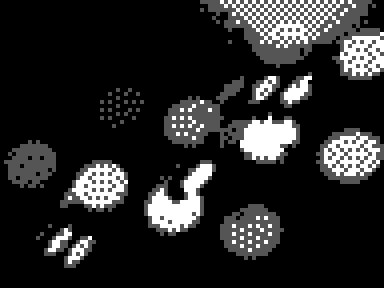
display/frames/016_002.684s.png
