befinitiv/cmd-z5-pager/display/frames/017_002.795s.png

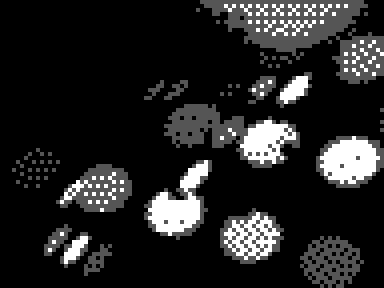
display/frames/017_002.795s.png
