befinitiv/cmd-z5-pager/display/frames/018_002.906s.png

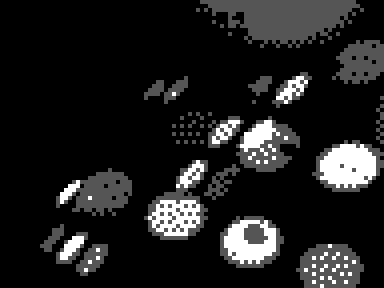
display/frames/018_002.906s.png
