befinitiv/cmd-z5-pager/display/frames/019_003.017s.png

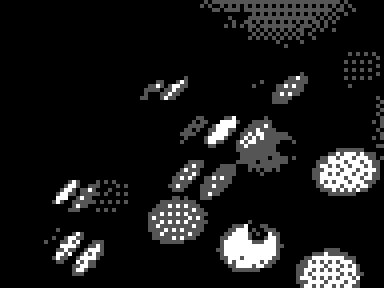
display/frames/019_003.017s.png
