befinitiv/cmd-z5-pager/display/frames/020_003.128s.png

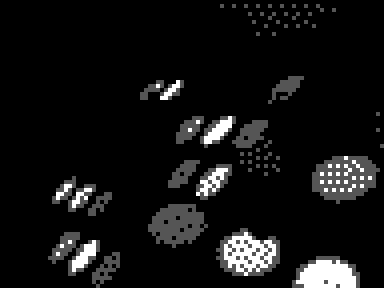
display/frames/020_003.128s.png
