befinitiv/cmd-z5-pager/display/frames/021_003.239s.png

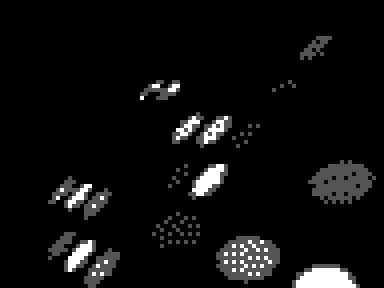
display/frames/021_003.239s.png
