befinitiv/cmd-z5-pager/display/frames/022_003.349s.png

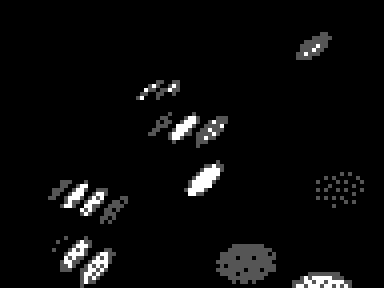
display/frames/022_003.349s.png
