befinitiv/cmd-z5-pager/display/frames/023_003.460s.png

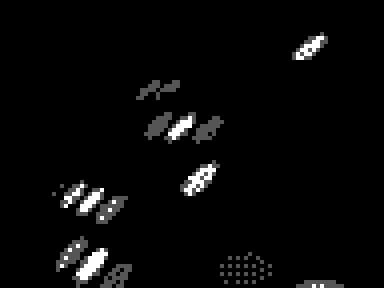
display/frames/023_003.460s.png
