befinitiv/cmd-z5-pager/display/frames/024_003.571s.png

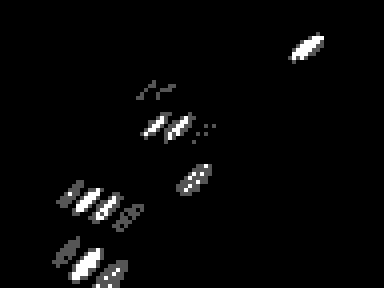
display/frames/024_003.571s.png
