befinitiv/cmd-z5-pager/display/frames/025_003.682s.png

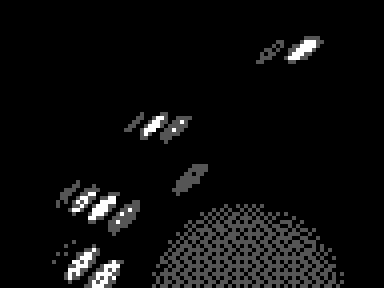
display/frames/025_003.682s.png
