befinitiv/cmd-z5-pager/display/frames/026_003.793s.png

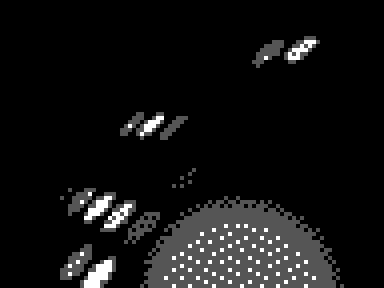
display/frames/026_003.793s.png
