befinitiv/cmd-z5-pager/display/frames/027_003.904s.png

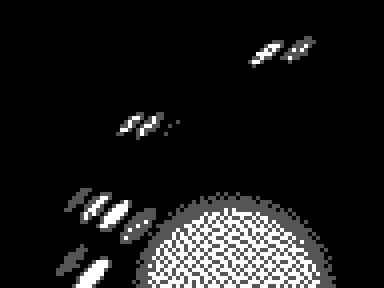
display/frames/027_003.904s.png
