befinitiv/cmd-z5-pager/display/frames/028_004.015s.png

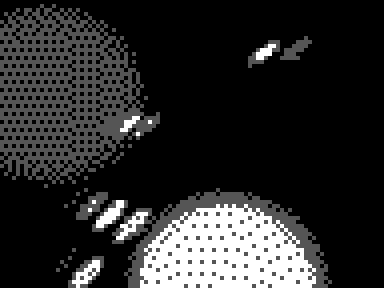
display/frames/028_004.015s.png
