befinitiv/cmd-z5-pager/display/frames/029_004.125s.png

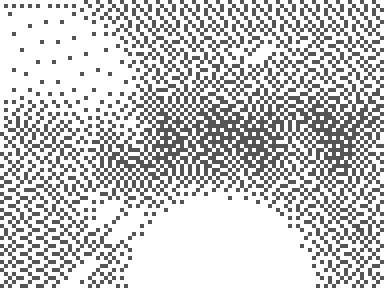
display/frames/029_004.125s.png
