befinitiv/cmd-z5-pager/display/frames/030_004.236s.png

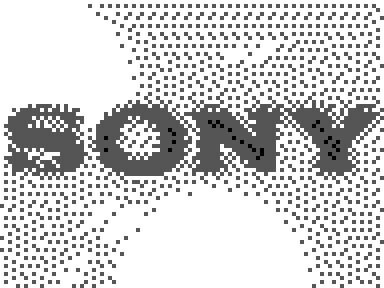
display/frames/030_004.236s.png
