befinitiv/cmd-z5-pager/display/frames/031_004.347s.png

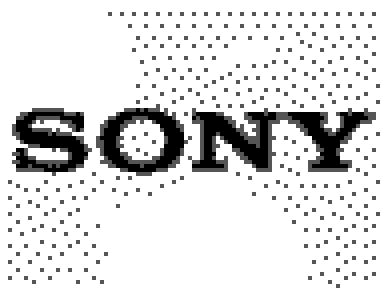
display/frames/031_004.347s.png
