befinitiv/cmd-z5-pager/display/frames/032_004.458s.png

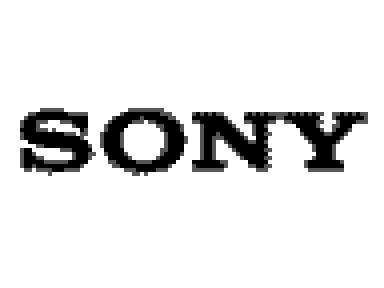
display/frames/032_004.458s.png
