befinitiv/cmd-z5-pager/display/frames/034_004.722s.png

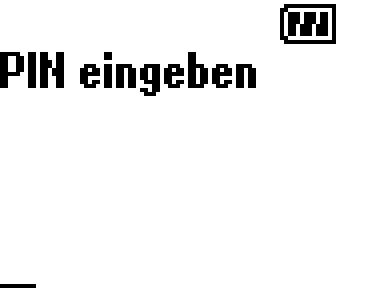
display/frames/034_004.722s.png
