befinitiv/cmd-z5-pager/hw/PXL_20261023_195638734.jpg

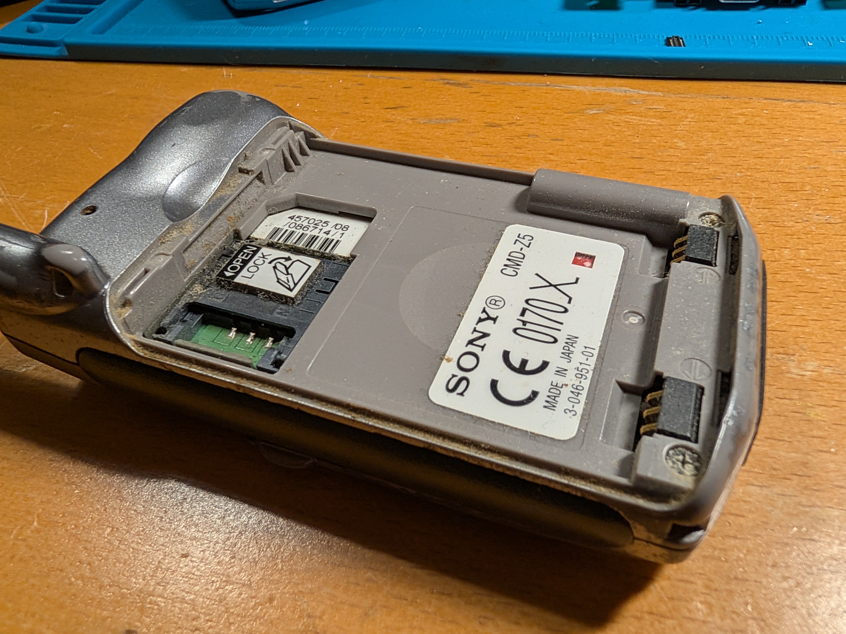
hw/PXL_20261023_195638734.jpg
