befinitiv/cmd-z5-pager/hw/PXL_20261023_195642746.jpg

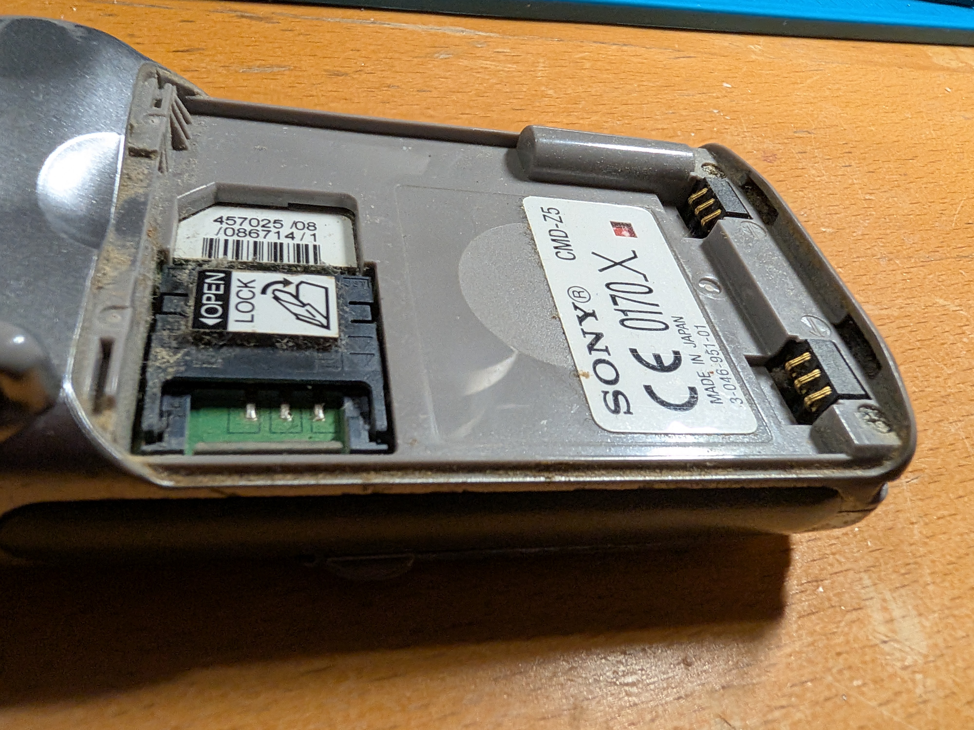
hw/PXL_20261023_195642746.jpg
