befinitiv/cmd-z5-pager/hw/PXL_20261023_195649916.jpg

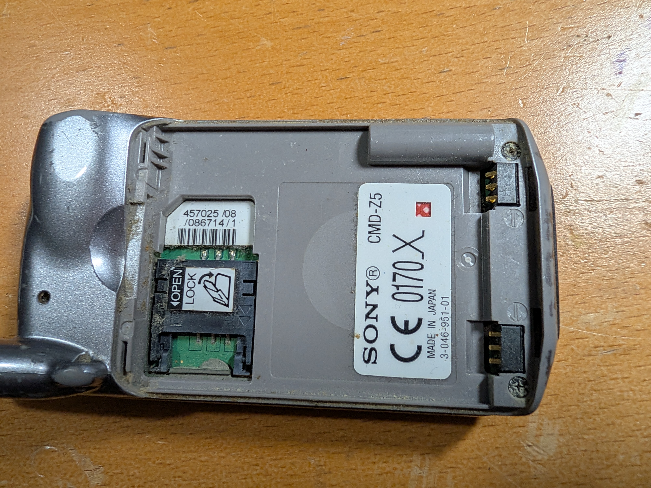
hw/PXL_20261023_195649916.jpg
