befinitiv/cmd-z5-pager/hw/PXL_20261023_195708236.jpg

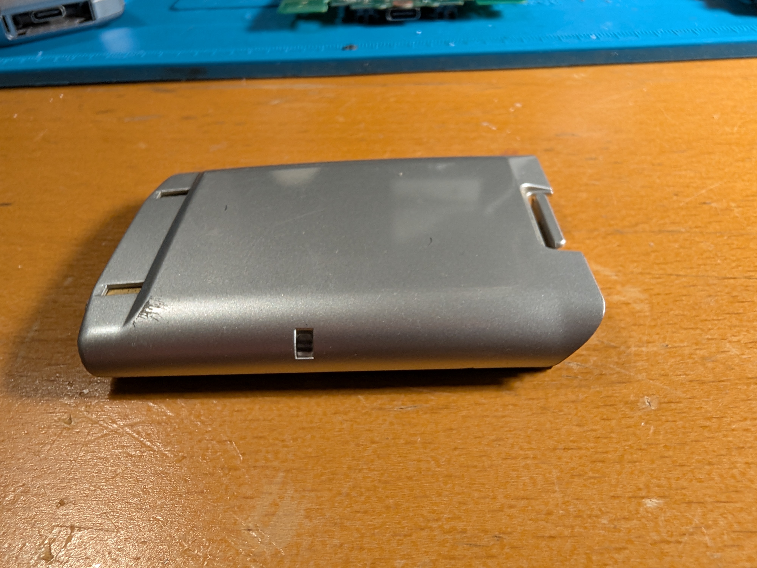
hw/PXL_20261023_195708236.jpg
