befinitiv/cmd-z5-pager/hw/PXL_20261023_195717240.jpg

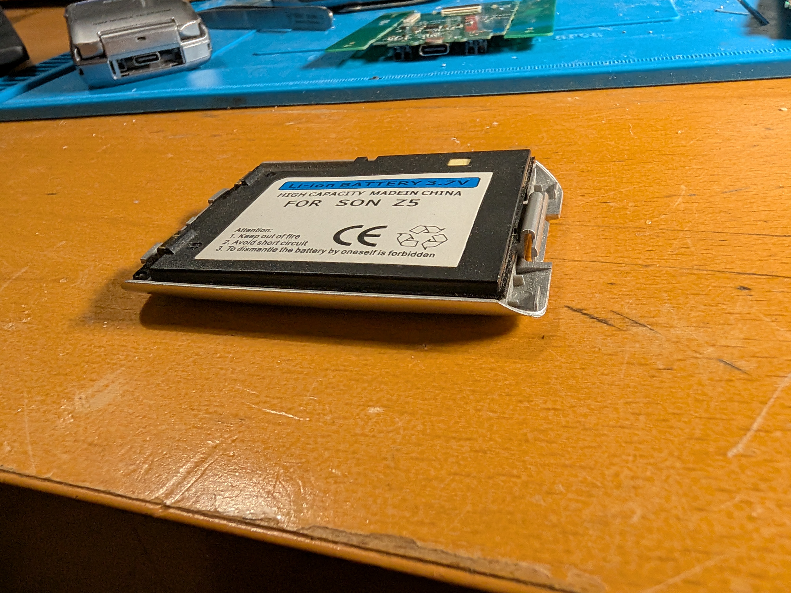
hw/PXL_20261023_195717240.jpg
