befinitiv/cmd-z5-pager/hw/PXL_20261023_195724053.jpg

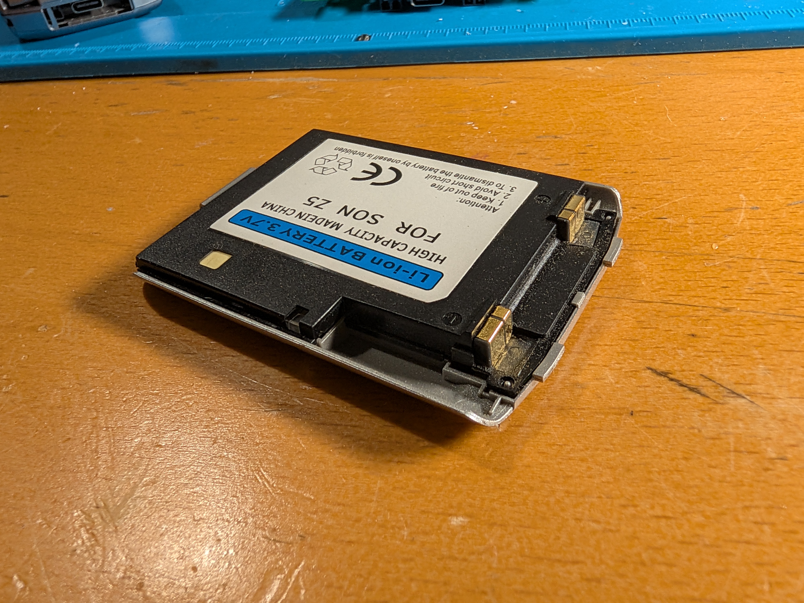
hw/PXL_20261023_195724053.jpg
