befinitiv/cmd-z5-pager/hw/PXL_20261023_210455343.jpg

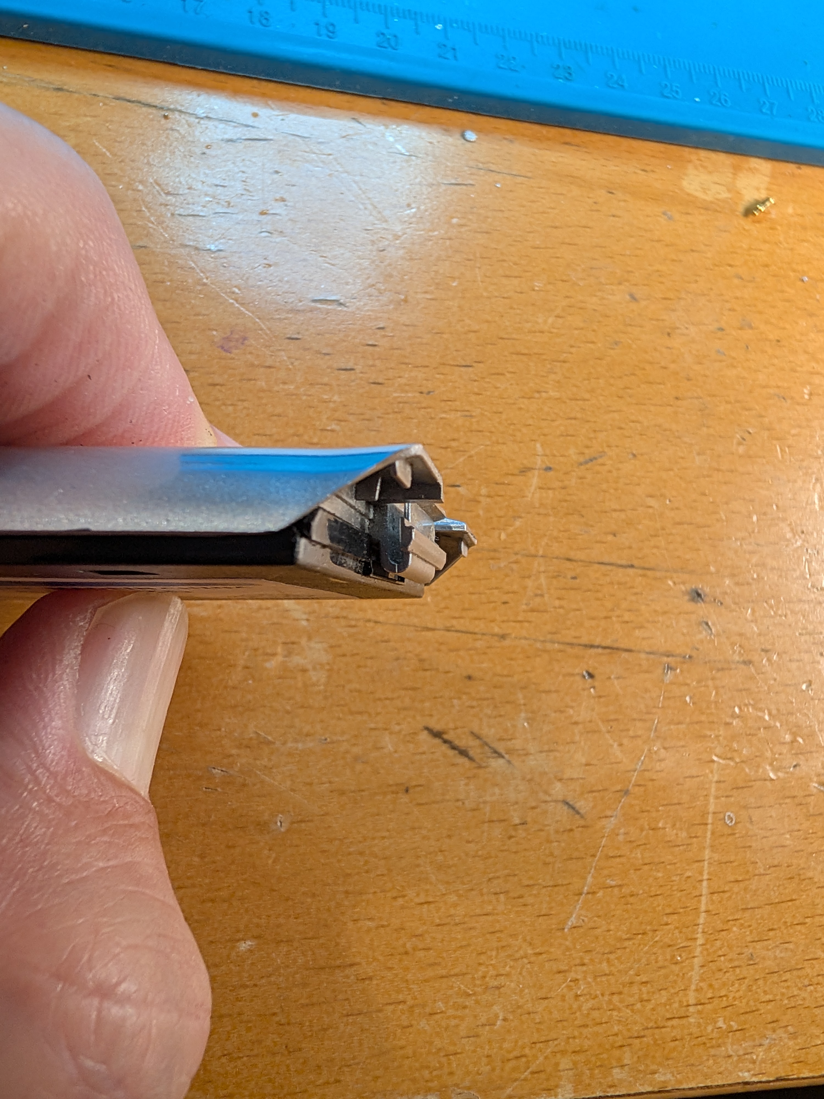
hw/PXL_20261023_210455343.jpg
