befinitiv/cmd-z5-pager/board/kicad/production/bom.csv

Designator | Footprint | Quantity | Value | LCSC Part #
AE1 | Johanson_2450AT18x100 | 1 | 2450AT18A100E | C89334
AE2 | Texas_SWRA416_868MHz_915MHz_Mirrored | 1 | PCB antenna 868/915 MHz
C1 | 0603 | 1 | 1u
C10, C11, C13, C19, C2, C32, C40, C47, C50, C52 | 0402 | 10 | 1u
C12, C21, C51 | 0402 | 3 | 4.7u
C14, C15, C16, C17, C31, C34, C4, C41, C43, C44, C46, C53 | 0402 | 12 | 100n
C18 | 0402 | 1 | 100p
C20 | 0402 | 1 | 47n
C22 | 0603 | 1 | 4.7u
C23, C24 | 0402 | 2 | 15p
C25, C26 | 0402 | 2 | 8.2p
C27 | 0402 | 1 | 0.8p
C28 | 0402 | 1 | 0.5p
C3 | 0603 | 1 | 2.2u
C33, C37, C38, C39, C45, C49, C5, C6, C7, C8, C9, L3 | 0603 | 12 | 10u
C42, C54 | 0402 | 2 | 10n
C48 | 0402 | 1 | 330p
D1 | SOT-23 | 1 | BAT54C | C916424
D2, D3 | D_SOD-323 | 2 | 1N5819WS | C191023
D4, D5, D6, D7 | 0603 | 4 | green | C72043
J1 | USB_C_Receptacle_GCT_USB4105-xx-A_16P_TopMnt_Horizontal | 1 | USB4105-GF-A | C3020560
J2, J7 | BAT-SMD_2P-P3.00_G-Switch_GT-BTP30002-0500B-015A | 2 | GT-BTP30002-0500B-015A | C41378718
J4 | SolderPads_1x04_P2.00mm_SMD | 1 | TBS M10N
J5 | FPC-SMD_26P-P0.50_KH-FPC0.5-H1.0SMT-26P-QCHF | 1 | KH-FPC0.5-H1.0SMT-26P-QCHF | C3250122
J6 | FPC-SMD_28P-P0.50_KH-FPC0.5-H1.0SMT-28P-QCHF | 1 | KH-FPC0.5-H1.0SMT-28P-QCHF | C3250123
L1, L2, L6 | 0805 | 3 | 2.2u
L4 | 0402 | 1 | 15n
L5 | 0402 | 1 | 4.7n
Q1 | SOT-563 | 1 | DMG1024UV | C2759893
Q2 | SOT-363_SC-70-6 | 1 | DMG1016UDW | C211433
R1 | 0402 | 1 | 150k 1%
R10, R11, R9 | 0402 | 3 | 10M
R12, R2, R3, R6 | 0402 | 4 | 0
R13 | 0603 | 1 | 10
R14, R15, R16, R17, R21, R22, R23, R26 | 0402 | 8 | 100k
R18, R19, R25, R8 | 0402 | 4 | 1k
R20, R24 | 0402 | 2 | 2.2k
R27, R28, R29, R30 | 0402 | 4 | 330
R4, R5 | 0402 | 2 | 4.7k
R7 | 0402 | 1 | 1M
U1 | SOT-23-6 | 1 | USBLC6-2SC6 | C7519
U2 | QFN-32-1EP_5x5mm_P0.5mm_EP3.45x3.45mm | 1 | nPM1300-QEAA-R7 | C7501206
U3 | Nordic_AQFN-73-1EP_7x7mm_P0.5mm | 1 | nRF52840-QIAA-R | C190794
U4 | LGA-12_2x2mm_P0.5mm | 1 | LIS2DH12TR | C110926
U5 | Seeed_Wio-SX1262 | 1 | Wio-SX1262
U6 | Texas_DSBGA-6_0.855x1.255mm_Layout2x3_P0.4mm_LevelB | 1 | TPS610997YFFR | C2072359
U7 | MSOP-8_3x3mm_P0.65mm | 1 | PAM8302AASCR | C113367
U8 | SOT-353_SC-70-5 | 1 | TLV9001IDCKR | C398362
Y1 | Crystal_SMD_3225-4Pin_3.2x2.5mm | 1 | 32 MHz CL=10pF | C91742
Y2 | Crystal_SMD_2012-2Pin_2.0x1.2mm | 1 | 32.768 kHz CL=7pF | C99009
