befinitiv/cmd-z5-pager/board/kicad/cmd-z5.step

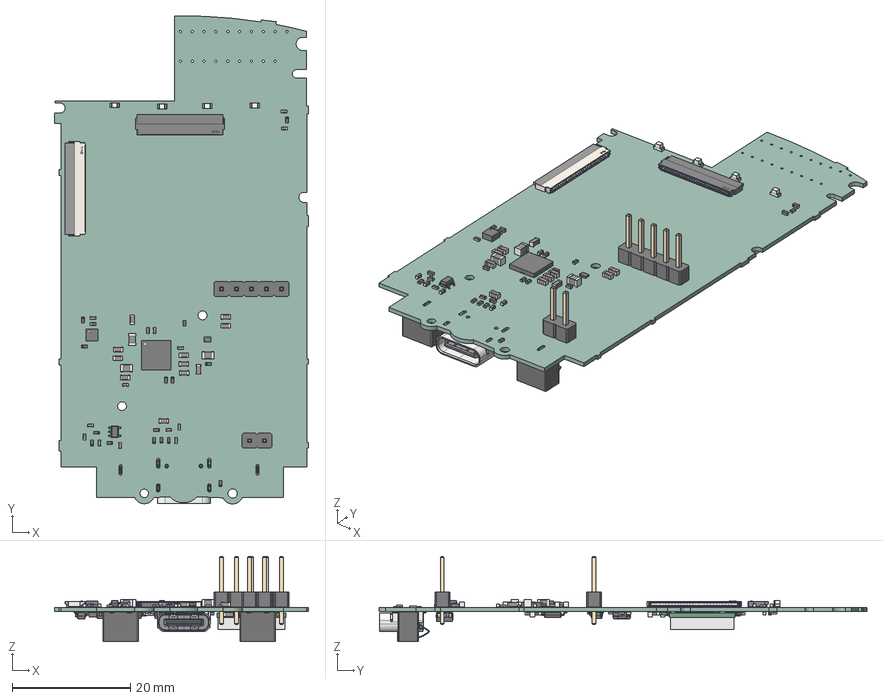
[picture p41: CAD file, 2026-11-02]
board/kicad/cmd-z5.step
43.0 x 82.4 x 14.4 mm
R_0402_1005Metric x 29
C_0402_1005Metric x 40
C_0603_1608Metric x 14
L_0805_2012Metric x 3
die
pin1
balls
LED_0603_1608Metric x 4
connector
CONN-SMD_28P-P0.50_KH-FPC0.5-H1.0SMT-28P-QCHF
QFN-32-1EP_5x5mm_Pitch0.5mm
PinHeader_1x02_P254mm_Vertical
SOT-353_SC-70-5
PinHeader_1x05_P254mm_Vertical
LGA_12_2x2mm_P05mm
USB_C_Receptacle_16P_TopMnt_Horizontal_GCT_USB4105-xx-A
SOT-23-6
pcb
shield
ipex
ipex_post
leads
D_SOD-323 x 2
SOT-363_SC-70-6
Crystal_SMD_3225-4Pin_3.2x2.5mm
housing x 2
contacts x 2
foot x 2
L_0603_1608Metric
MSOP-8_3x3mm_P0.65mm
Johanson_2450AT18x100
Nordic_AQFN-73-1EP_7x7mm_P0.5mm
SOT_563
base
lid
terminals
R_0603_1608Metric
L_0402_1005Metric x 2
SOT-23
cmd-z5_PCB
