befinitiv/cmd-z5-pager/mech/battery_cover/out/battery_cover_fit_test.stl

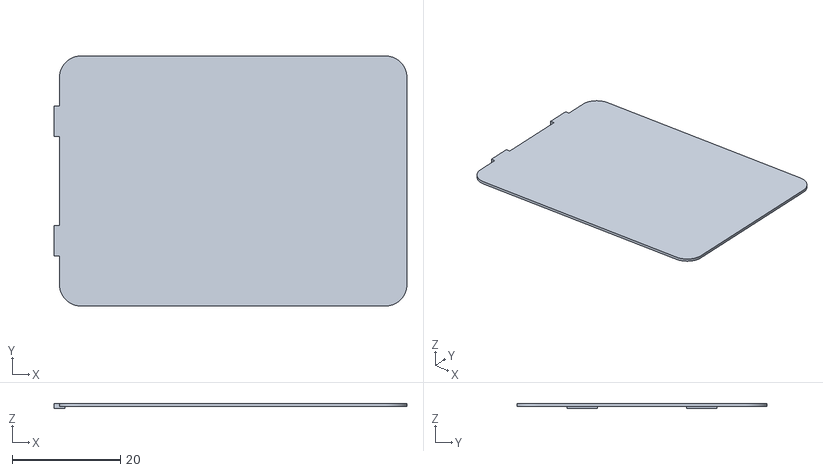
[picture p42: CAD file, 2026-10-29]
mech/battery_cover/out/battery_cover_fit_test.stl
65.2 x 46.2 x 1.00
