befinitiv/cmd-z5-pager/mech/battery_cover/out/battery_cover.step

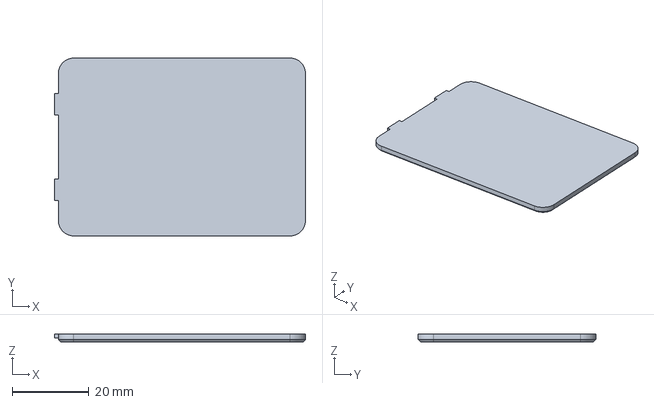
[picture p43: CAD file, 2026-10-29]
mech/battery_cover/out/battery_cover.step
65.2 x 46.2 x 2.00 mm
