befinitiv/cmd-z5-pager/(list of files, cad)

Other CAD files:
board/kicad/cmd-z5.stl
mech/battery_cover/out/battery_cover.stl
