befinitiv/cmd-z5-pager/board/kicad/cmd-z5.kicad_pcb

## KiCad design board/kicad/cmd-z5.kicad_pcb (2026-10-07)

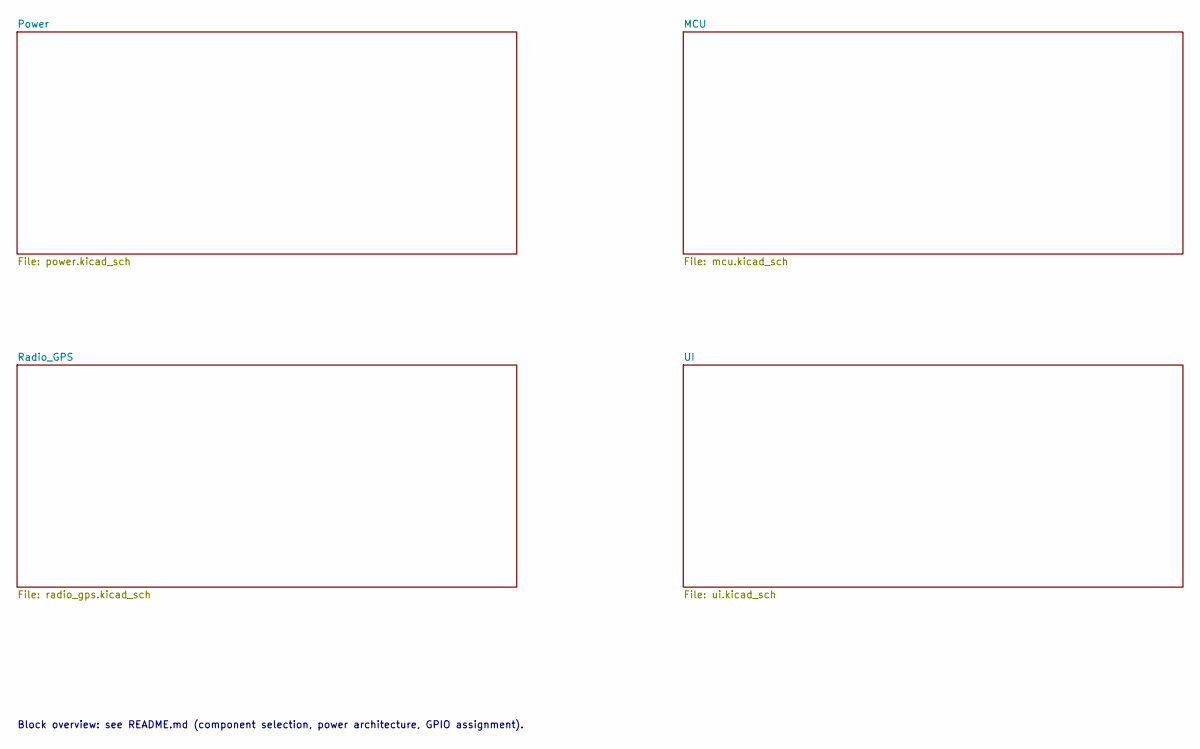
[picture p44: schematic cmd-z5.kicad_sch, Sony CMD-Z5 Meshtastic replacement board]

Notes on the sheet:
Block overview: see README.md (component selection, power architecture, GPIO assignment).

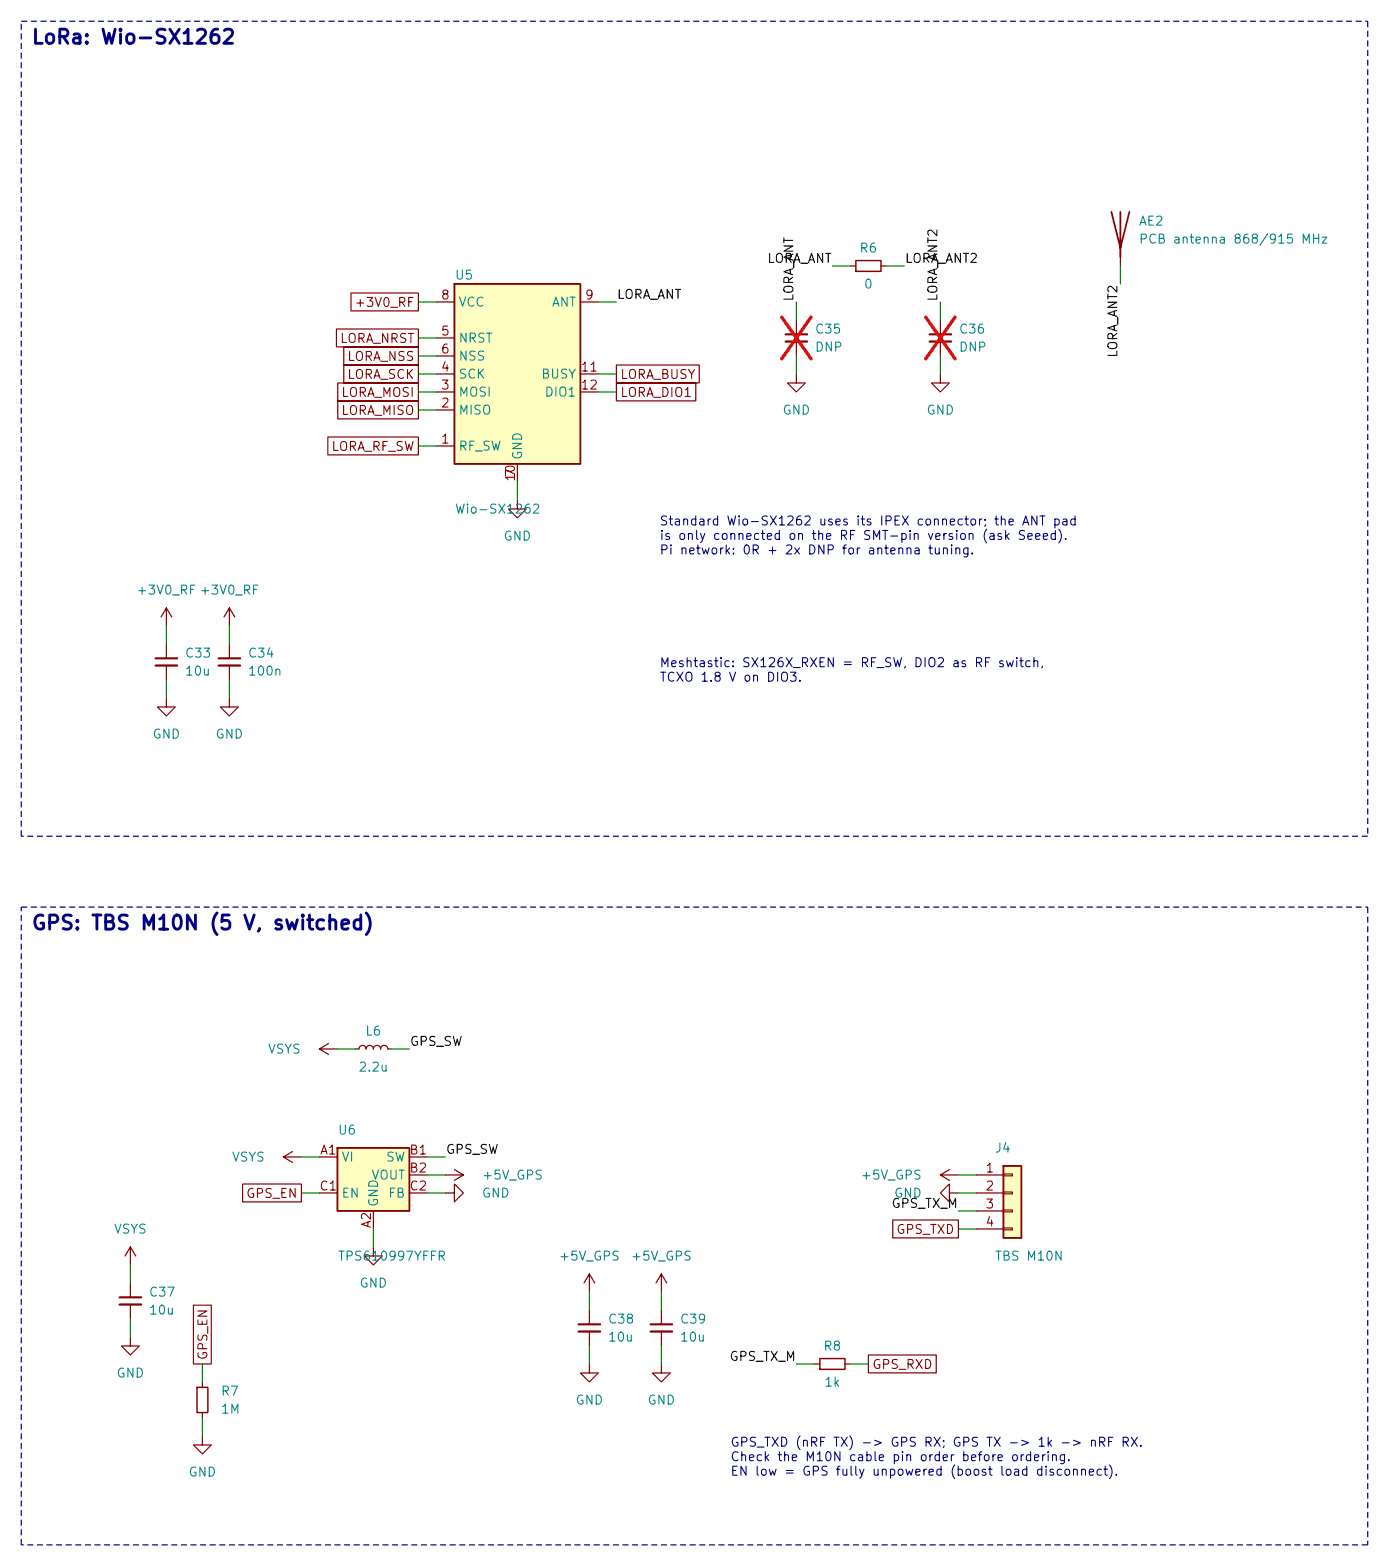
[picture p45: schematic radio_gps.kicad_sch, LoRa (Wio-SX1262) and GPS (TBS M10N)]

Parts:
AE2: PCB antenna 868/915 MHz; Texas_SWRA416_868MHz_915MHz_Mirrored
C33, C37, C38, C39: 10u; C_0603_1608Metric
C34: 100n; C_0402_1005Metric
C35, C36: DNP; C_0402_1005Metric; not fitted
J4: TBS M10N; SolderPads_1x04_P2.00mm_SMD
L6: 2.2u; L_0805_2012Metric
R6: 0; R_0402_1005Metric
R7: 1M; R_0402_1005Metric
R8: 1k; R_0402_1005Metric
U5: Wio-SX1262; Seeed_Wio-SX1262
U6: TPS610997YFFR; Texas_DSBGA-6_0.855x1.255mm_Layout2x3_P0.4mm_LevelB; LCSC C2072359

Connections:
+3V0_RF: C33.1, C34.1, U5.8 (VCC); also elsewhere on the board
+5V_GPS: C38.1, C39.1, J4.1, U6.B2 (VOUT)
/Radio_GPS/GPS_SW: L6.2, U6.B1 (SW)
/Radio_GPS/GPS_TX_M: J4.3, R8.1
/Radio_GPS/LORA_ANT: C35.1, R6.1, U5.9 (ANT)
/Radio_GPS/LORA_ANT2: AE2.1, C36.1, R6.2
GND: C33.2, C34.2, C35.2, C36.2, C37.2, C38.2, C39.2, J4.2, R7.2, U5.7 (GND), U5.10 (GND), U6.A2 (GND), U6.C2 (FB); also elsewhere on the board
GPS_EN: R7.1, U6.C1 (EN); also elsewhere on the board
GPS_RXD: R8.2; also elsewhere on the board
GPS_TXD: J4.4; also elsewhere on the board
LORA_BUSY: U5.11 (BUSY); also elsewhere on the board
LORA_DIO1: U5.12 (DIO1); also elsewhere on the board
LORA_MISO: U5.2 (MISO); also elsewhere on the board
LORA_MOSI: U5.3 (MOSI); also elsewhere on the board
LORA_NRST: U5.5 (NRST); also elsewhere on the board
LORA_NSS: U5.6 (NSS); also elsewhere on the board
LORA_RF_SW: U5.1 (RF_SW); also elsewhere on the board
LORA_SCK: U5.4 (SCK); also elsewhere on the board
VSYS: C37.1, L6.1, U6.A1 (VI); also elsewhere on the board

Notes on the sheet:
Standard Wio-SX1262 uses its IPEX connector; the ANT pad is only connected on the RF SMT-pin version (ask Seeed). Pi network: 0R + 2x DNP for antenna tuning.
GPS_TXD (nRF TX) -> GPS RX; GPS TX -> 1k -> nRF RX. Check the M10N cable pin order before ordering. EN low = GPS fully unpowered (boost load disconnect).
Meshtastic: SX126X_RXEN = RF_SW, DIO2 as RF switch, TCXO 1.8 V on DIO3.
LoRa: Wio-SX1262
GPS: TBS M10N (5 V, switched)

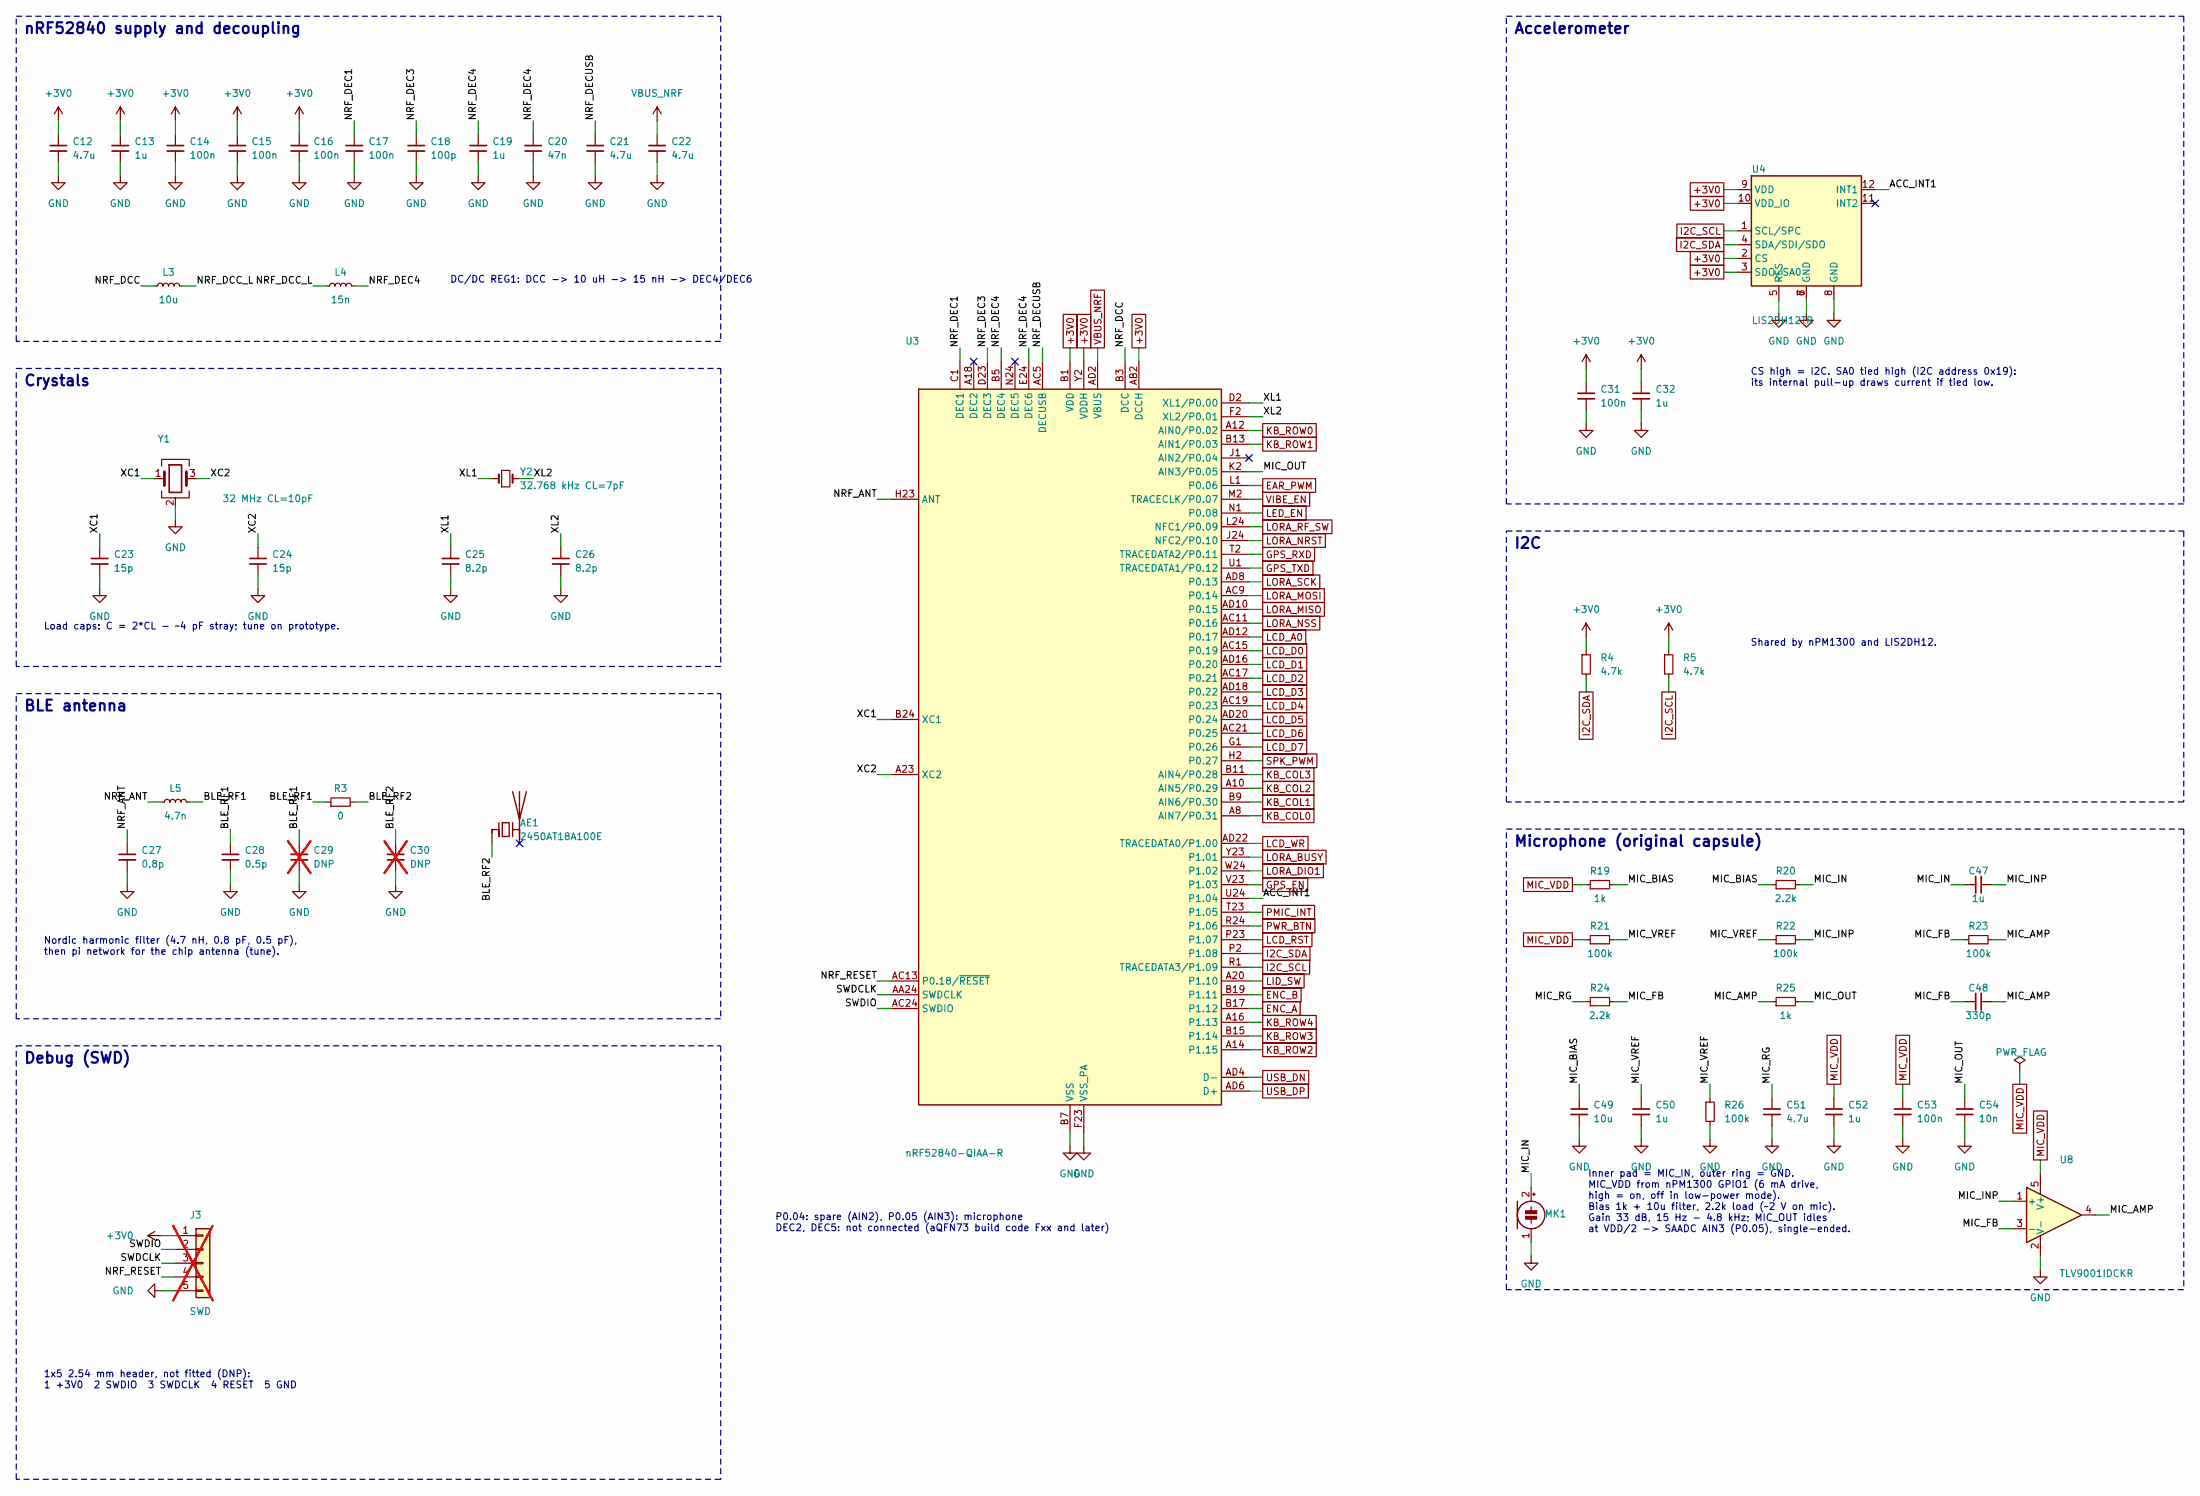
[picture p46: schematic mcu.kicad_sch, MCU: nRF52840, crystals, BLE antenna, SWD, accelerometer]

Parts:
AE1: 2450AT18A100E; Johanson_2450AT18x100; LCSC C89334
C12, C21, C51: 4.7u; C_0402_1005Metric
C13, C19, C32, C47, C50, C52: 1u; C_0402_1005Metric
C14, C15, C16, C17, C31, C53: 100n; C_0402_1005Metric
C18: 100p; C_0402_1005Metric
C20: 47n; C_0402_1005Metric
C22: 4.7u; C_0603_1608Metric
C23, C24: 15p; C_0402_1005Metric
C25, C26: 8.2p; C_0402_1005Metric
C27: 0.8p; C_0402_1005Metric
C28: 0.5p; C_0402_1005Metric
C29, C30: DNP; C_0402_1005Metric; not fitted
C48: 330p; C_0402_1005Metric
C49: 10u; C_0603_1608Metric
C54: 10n; C_0402_1005Metric
J3: SWD; PinHeader_1x05_P2.54mm_Vertical; not fitted
L3: 10u; L_0603_1608Metric
L4: 15n; L_0402_1005Metric
L5: 4.7n; L_0402_1005Metric
MK1: Capsule mic (original); MIC_Contact_Concentric_D6.2mm
R3: 0; R_0402_1005Metric
R4, R5: 4.7k; R_0402_1005Metric
R19, R25: 1k; R_0402_1005Metric
R20, R24: 2.2k; R_0402_1005Metric
R21, R22, R23, R26: 100k; R_0402_1005Metric
U3: nRF52840-QIAA-R; Nordic_AQFN-73-1EP_7x7mm_P0.5mm; LCSC C190794
U4: LIS2DH12TR; LGA-12_2x2mm_P0.5mm; LCSC C110926
U8: TLV9001IDCKR; SOT-353_SC-70-5; LCSC C398362
Y1: 32 MHz CL=10pF; Crystal_SMD_3225-4Pin_3.2x2.5mm; MPN X1E0000210163; LCSC C91742
Y2: 32.768 kHz CL=7pF; Crystal_SMD_2012-2Pin_2.0x1.2mm; MPN X1A0000610006; LCSC C99009

Connections:
+3V0: C12.1, C13.1, C14.1, C15.1, C16.1, C31.1, C32.1, J3.1, R4.1, R5.1, U3.A22 (VDD), U3.AB2 (DCCH), U3.AD14 (VDD), U3.AD23 (VDD), U3.B1 (VDD), U3.W1 (VDD), U3.Y2 (VDDH), U4.2 (CS), U4.3 (SDO/SA0), U4.9 (VDD), U4.10 (VDD_IO); also elsewhere on the board
/MCU/ACC_INT1: U3.U24 (P1.04), U4.12 (INT1)
/MCU/BLE_RF1: C28.1, C29.1, L5.2, R3.1
/MCU/BLE_RF2: AE1.1 (FEED_1), C30.1, R3.2
/MCU/MIC_AMP: C48.2, R23.2, R25.1, U8.4
/MCU/MIC_BIAS: C49.1, R19.2, R20.1
/MCU/MIC_FB: C48.1, R23.1, R24.2, U8.3 (-)
/MCU/MIC_IN: C47.1, MK1.2 (+), R20.2
/MCU/MIC_INP: C47.2, R22.2, U8.1 (+)
/MCU/MIC_OUT: C54.1, R25.2, U3.K2 (AIN3/P0.05)
/MCU/MIC_RG: C51.1, R24.1
/MCU/MIC_VREF: C50.1, R21.2, R22.1, R26.1
/MCU/NRF_ANT: C27.1, L5.1, U3.H23 (ANT)
/MCU/NRF_DCC: L3.1, U3.B3 (DCC)
/MCU/NRF_DCC_L: L3.2, L4.1
/MCU/NRF_DEC1: C17.1, U3.C1 (DEC1)
/MCU/NRF_DEC3: C18.1, U3.D23 (DEC3)
/MCU/NRF_DEC4: C19.1, C20.1, L4.2, U3.B5 (DEC4), U3.E24 (DEC6)
/MCU/NRF_DECUSB: C21.1, U3.AC5 (DECUSB)
/MCU/NRF_RESET: J3.4, U3.AC13 (P0.18/~RESET)
/MCU/SWDCLK: J3.3, U3.AA24 (SWDCLK)
/MCU/SWDIO: J3.2, U3.AC24 (SWDIO)
/MCU/XC1: C23.1, U3.B24 (XC1), Y1.1
/MCU/XC2: C24.1, U3.A23 (XC2), Y1.3
/MCU/XL1: C25.1, U3.D2 (XL1/P0.00), Y2.1
/MCU/XL2: C26.1, U3.F2 (XL2/P0.01), Y2.2
EAR_PWM: U3.L1 (P0.06); also elsewhere on the board
ENC_A: U3.B17 (P1.12); also elsewhere on the board
ENC_B: U3.B19 (P1.11); also elsewhere on the board
GND: C12.2, C13.2, C14.2, C15.2, C16.2, C17.2, C18.2, C19.2, C20.2, C21.2, C22.2, C23.2, C24.2, C25.2, C26.2, C27.2, C28.2, C29.2, C30.2, C31.2, C32.2, C49.2, C50.2, C51.2, C52.2, C53.2, C54.2, J3.5, MK1.1 (-), R26.2, U3.B7 (VSS), U3.EP (VSS), U3.F23 (VSS_PA), U4.5 (RES), U4.6 (GND), U4.7 (GND), U4.8 (GND), U8.2 (V-), Y1.2 (G), Y1.4 (G); also elsewhere on the board
GPS_EN: U3.V23 (P1.03); also elsewhere on the board
GPS_RXD: U3.T2 (TRACEDATA2/P0.11); also elsewhere on the board
GPS_TXD: U3.U1 (TRACEDATA1/P0.12); also elsewhere on the board
I2C_SCL: R5.2, U3.R1 (TRACEDATA3/P1.09), U4.1 (SCL/SPC); also elsewhere on the board
I2C_SDA: R4.2, U3.P2 (P1.08), U4.4 (SDA/SDI/SDO); also elsewhere on the board
KB_COL0: U3.A8 (AIN7/P0.31); also elsewhere on the board
KB_COL1: U3.B9 (AIN6/P0.30); also elsewhere on the board
KB_COL2: U3.A10 (AIN5/P0.29); also elsewhere on the board
KB_COL3: U3.B11 (AIN4/P0.28); also elsewhere on the board
KB_ROW0: U3.A12 (AIN0/P0.02); also elsewhere on the board
KB_ROW1: U3.B13 (AIN1/P0.03); also elsewhere on the board
KB_ROW2: U3.A14 (P1.15); also elsewhere on the board
KB_ROW3: U3.B15 (P1.14); also elsewhere on the board
KB_ROW4: U3.A16 (P1.13); also elsewhere on the board
LCD_A0: U3.AD12 (P0.17); also elsewhere on the board
LCD_D0: U3.AC15 (P0.19); also elsewhere on the board
LCD_D1: U3.AD16 (P0.20); also elsewhere on the board
LCD_D2: U3.AC17 (P0.21); also elsewhere on the board
LCD_D3: U3.AD18 (P0.22); also elsewhere on the board
LCD_D4: U3.AC19 (P0.23); also elsewhere on the board
LCD_D5: U3.AD20 (P0.24); also elsewhere on the board
LCD_D6: U3.AC21 (P0.25); also elsewhere on the board
LCD_D7: U3.G1 (P0.26); also elsewhere on the board
LCD_RST: U3.P23 (P1.07); also elsewhere on the board
LCD_WR: U3.AD22 (TRACEDATA0/P1.00); also elsewhere on the board
LED_EN: U3.N1 (P0.08); also elsewhere on the board
LID_SW: U3.A20 (P1.10); also elsewhere on the board
LORA_BUSY: U3.Y23 (P1.01); also elsewhere on the board
LORA_DIO1: U3.W24 (P1.02); also elsewhere on the board
LORA_MISO: U3.AD10 (P0.15); also elsewhere on the board
LORA_MOSI: U3.AC9 (P0.14); also elsewhere on the board
LORA_NRST: U3.J24 (NFC2/P0.10); also elsewhere on the board
LORA_NSS: U3.AC11 (P0.16); also elsewhere on the board
LORA_RF_SW: U3.L24 (NFC1/P0.09); also elsewhere on the board
LORA_SCK: U3.AD8 (P0.13); also elsewhere on the board
MIC_VDD: C52.1, C53.1, R19.1, R21.1, U8.5 (V+); also elsewhere on the board
PMIC_INT: U3.T23 (P1.05); also elsewhere on the board
PWR_BTN: U3.R24 (P1.06); also elsewhere on the board
SPK_PWM: U3.H2 (P0.27); also elsewhere on the board
USB_DN: U3.AD4 (D-); also elsewhere on the board
USB_DP: U3.AD6 (D+); also elsewhere on the board
VBUS_NRF: C22.1, U3.AD2 (VBUS); also elsewhere on the board
VIBE_EN: U3.M2 (TRACECLK/P0.07); also elsewhere on the board

Notes on the sheet:
Nordic harmonic filter (4.7 nH, 0.8 pF, 0.5 pF), then pi network for the chip antenna (tune).
Accelerometer
Debug (SWD)
I2C
nRF52840 supply and decoupling
Microphone (original capsule)
Inner pad = MIC_IN, outer ring = GND. MIC_VDD from nPM1300 GPIO1 (6 mA drive, high = on, off in low-power mode). Bias 1k + 10u filter, 2.2k load (~2 V on mic). Gain 33 dB, 15 Hz - 4.8 kHz; MIC_OUT idles at VDD/2 -> SAADC AIN3 (P0.05), single-ended.
1x5 2.54 mm header, not fitted (DNP): 1 +3V0 2 SWDIO 3 SWDCLK 4 RESET 5 GND
CS high = I2C. SA0 tied high (I2C address 0x19): its internal pull-up draws current if tied low.
BLE antenna
Load caps: C = 2*CL - ~4 pF stray; tune on prototype.
DC/DC REG1: DCC -> 10 uH -> 15 nH -> DEC4/DEC6
Shared by nPM1300 and LIS2DH12.
Crystals
P0.04: spare (AIN2), P0.05 (AIN3): microphone DEC2, DEC5: not connected (aQFN73 build code Fxx and later)

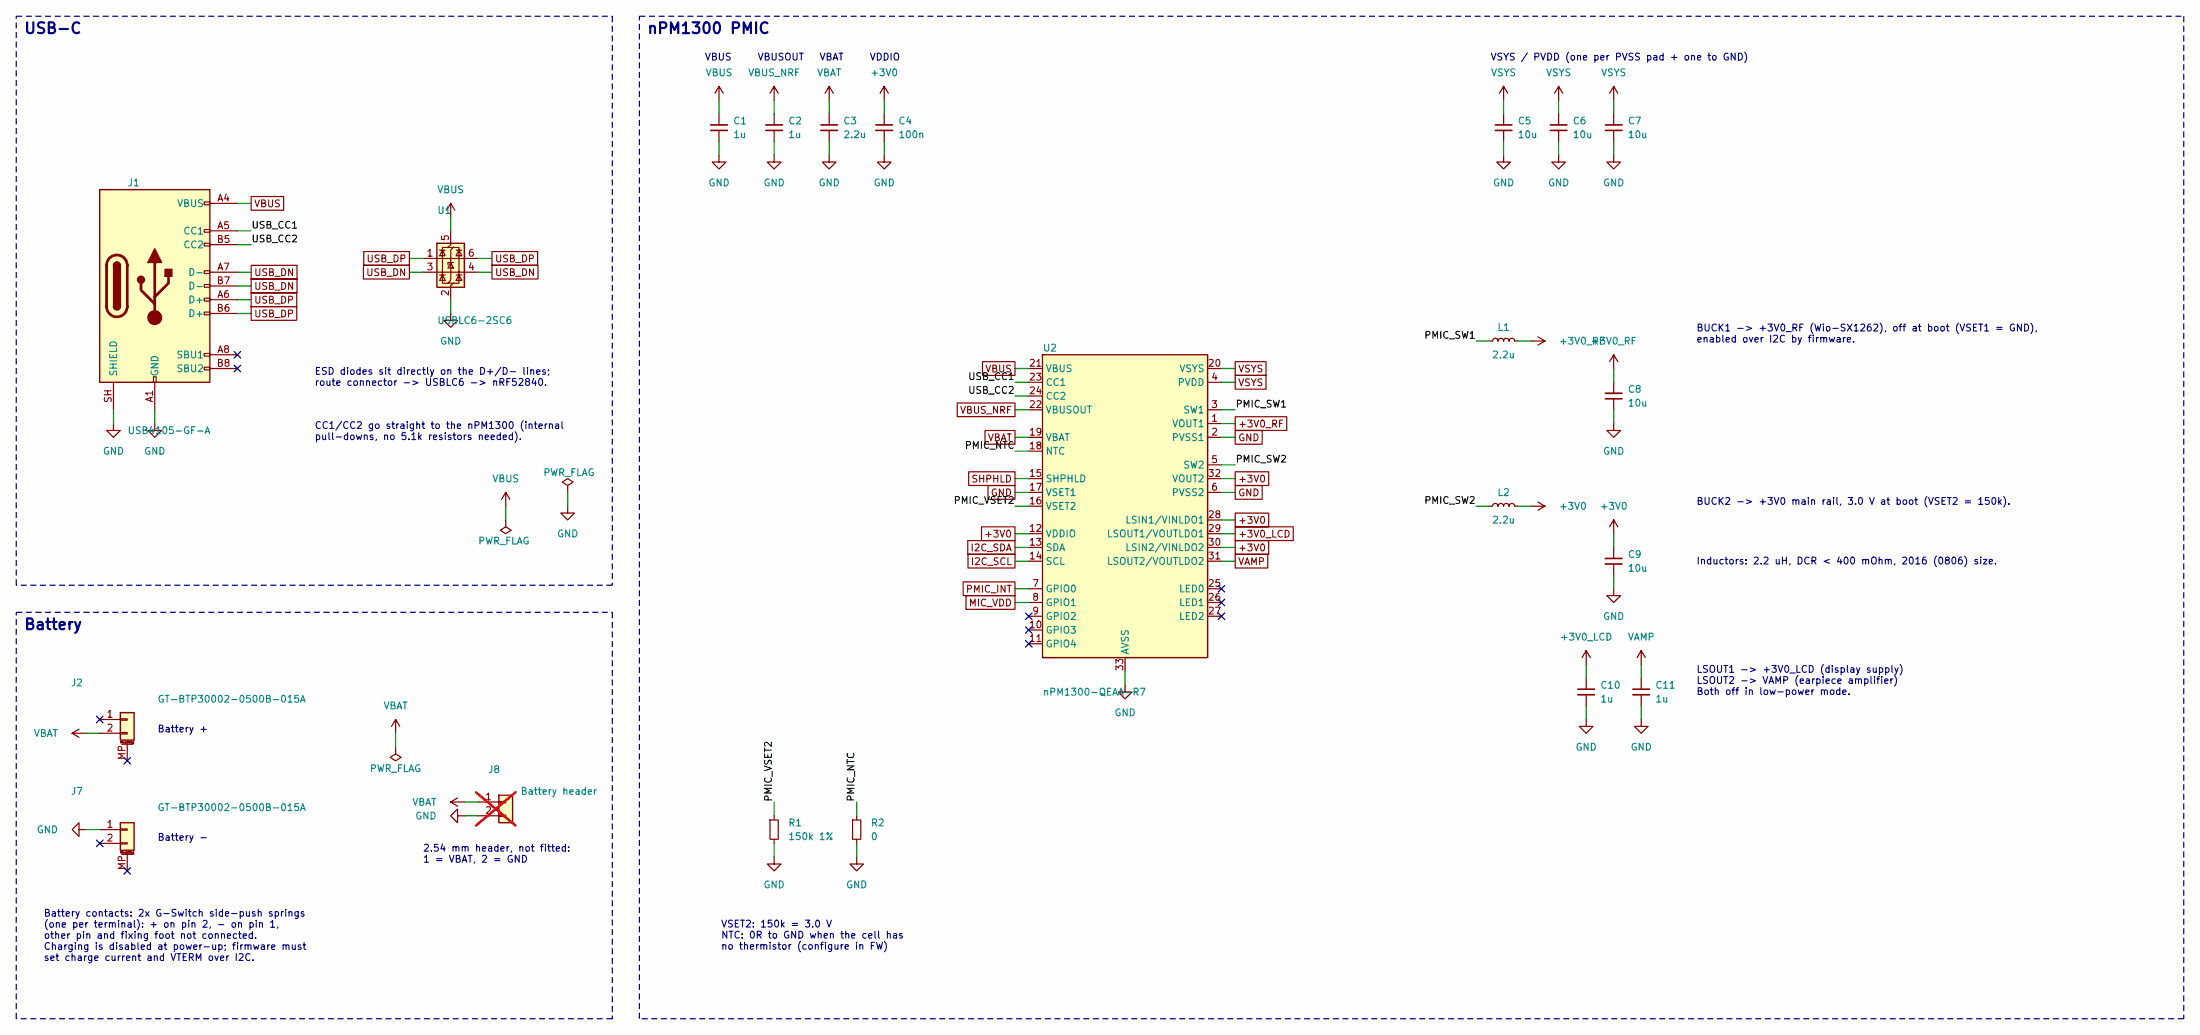
[picture p47: schematic power.kicad_sch, Power: USB-C, nPM1300 PMIC, battery]

Parts:
C1: 1u; C_0603_1608Metric
C2, C10, C11: 1u; C_0402_1005Metric
C3: 2.2u; C_0603_1608Metric
C4: 100n; C_0402_1005Metric
C5, C6, C7, C8, C9: 10u; C_0603_1608Metric
J1: USB4105-GF-A; USB_C_Receptacle_GCT_USB4105-xx-A_16P_TopMnt_Horizontal; LCSC C3020560
J2, J7: GT-BTP30002-0500B-015A; BAT-SMD_2P-P3.00_G-Switch_GT-BTP30002-0500B-015A; LCSC C41378718
J8: Battery header; PinHeader_1x02_P2.54mm_Vertical; not fitted
L1, L2: 2.2u; L_0805_2012Metric
R1: 150k 1%; R_0402_1005Metric
R2: 0; R_0402_1005Metric
U1: USBLC6-2SC6; SOT-23-6; LCSC C7519
U2: nPM1300-QEAA-R7; QFN-32-1EP_5x5mm_P0.5mm_EP3.45x3.45mm; LCSC C7501206

Connections:
+3V0: C4.1, C9.1, L2.2, U2.12 (VDDIO), U2.28 (LSIN1/VINLDO1), U2.30 (LSIN2/VINLDO2), U2.32 (VOUT2); also elsewhere on the board
+3V0_LCD: C10.1, U2.29 (LSOUT1/VOUTLDO1); also elsewhere on the board
+3V0_RF: C8.1, L1.2, U2.1 (VOUT1); also elsewhere on the board
/Power/PMIC_NTC: R2.1, U2.18 (NTC)
/Power/PMIC_SW1: L1.1, U2.3 (SW1)
/Power/PMIC_SW2: L2.1, U2.5 (SW2)
/Power/PMIC_VSET2: R1.1, U2.16 (VSET2)
/Power/USB_CC1: J1.A5 (CC1), U2.23 (CC1)
/Power/USB_CC2: J1.B5 (CC2), U2.24 (CC2)
GND: C1.2, C2.2, C3.2, C4.2, C5.2, C6.2, C7.2, C8.2, C9.2, C10.2, C11.2, J1.A1 (GND), J1.A12 (GND), J1.B1 (GND), J1.B12 (GND), J1.SH (SHIELD), J7.1 (Pin_1_1), J8.2, R1.2, R2.2, U1.2 (GND), U2.2 (PVSS1), U2.6 (PVSS2), U2.17 (VSET1), U2.33 (AVSS); also elsewhere on the board
I2C_SCL: U2.14 (SCL); also elsewhere on the board
I2C_SDA: U2.13 (SDA); also elsewhere on the board
MIC_VDD: U2.8 (GPIO1); also elsewhere on the board
PMIC_INT: U2.7 (GPIO0); also elsewhere on the board
SHPHLD: U2.15 (SHPHLD); also elsewhere on the board
USB_DN: J1.A7 (D-), J1.B7 (D-), U1.3 (I/O2), U1.4 (I/O2); also elsewhere on the board
USB_DP: J1.A6 (D+), J1.B6 (D+), U1.1 (I/O1), U1.6 (I/O1); also elsewhere on the board
VAMP: C11.1, U2.31 (LSOUT2/VOUTLDO2); also elsewhere on the board
VBAT: C3.1, J2.2 (Pin_2_2), J8.1, U2.19 (VBAT)
VBUS: C1.1, J1.A4 (VBUS), J1.A9 (VBUS), J1.B4 (VBUS), J1.B9 (VBUS), U1.5 (VBUS), U2.21 (VBUS)
VBUS_NRF: C2.1, U2.22 (VBUSOUT); also elsewhere on the board
VSYS: C5.1, C6.1, C7.1, U2.4 (PVDD), U2.20 (VSYS); also elsewhere on the board

Notes on the sheet:
VSET2: 150k = 3.0 V NTC: 0R to GND when the cell has no thermistor (configure in FW)
nPM1300 PMIC
Inductors: 2.2 uH, DCR < 400 mOhm, 2016 (0806) size.
BUCK1 -> +3V0_RF (Wio-SX1262), off at boot (VSET1 = GND), enabled over I2C by firmware.
CC1/CC2 go straight to the nPM1300 (internal pull-downs, no 5.1k resistors needed).
Battery -
ESD diodes sit directly on the D+/D- lines; route connector -> USBLC6 -> nRF52840.
VBUS VBUSOUT VBAT VDDIO
VSYS / PVDD (one per PVSS pad + one to GND)
2.54 mm header, not fitted: 1 = VBAT, 2 = GND
Battery +
BUCK2 -> +3V0 main rail, 3.0 V at boot (VSET2 = 150k).
Battery contacts: 2x G-Switch side-push springs (one per terminal): + on pin 2, - on pin 1, other pin and fixing foot not connected. Charging is disabled at power-up; firmware must set charge current and VTERM over I2C.
LSOUT1 -> +3V0_LCD (display supply) LSOUT2 -> VAMP (earpiece amplifier) Both off in low-power mode.
Battery
USB-C

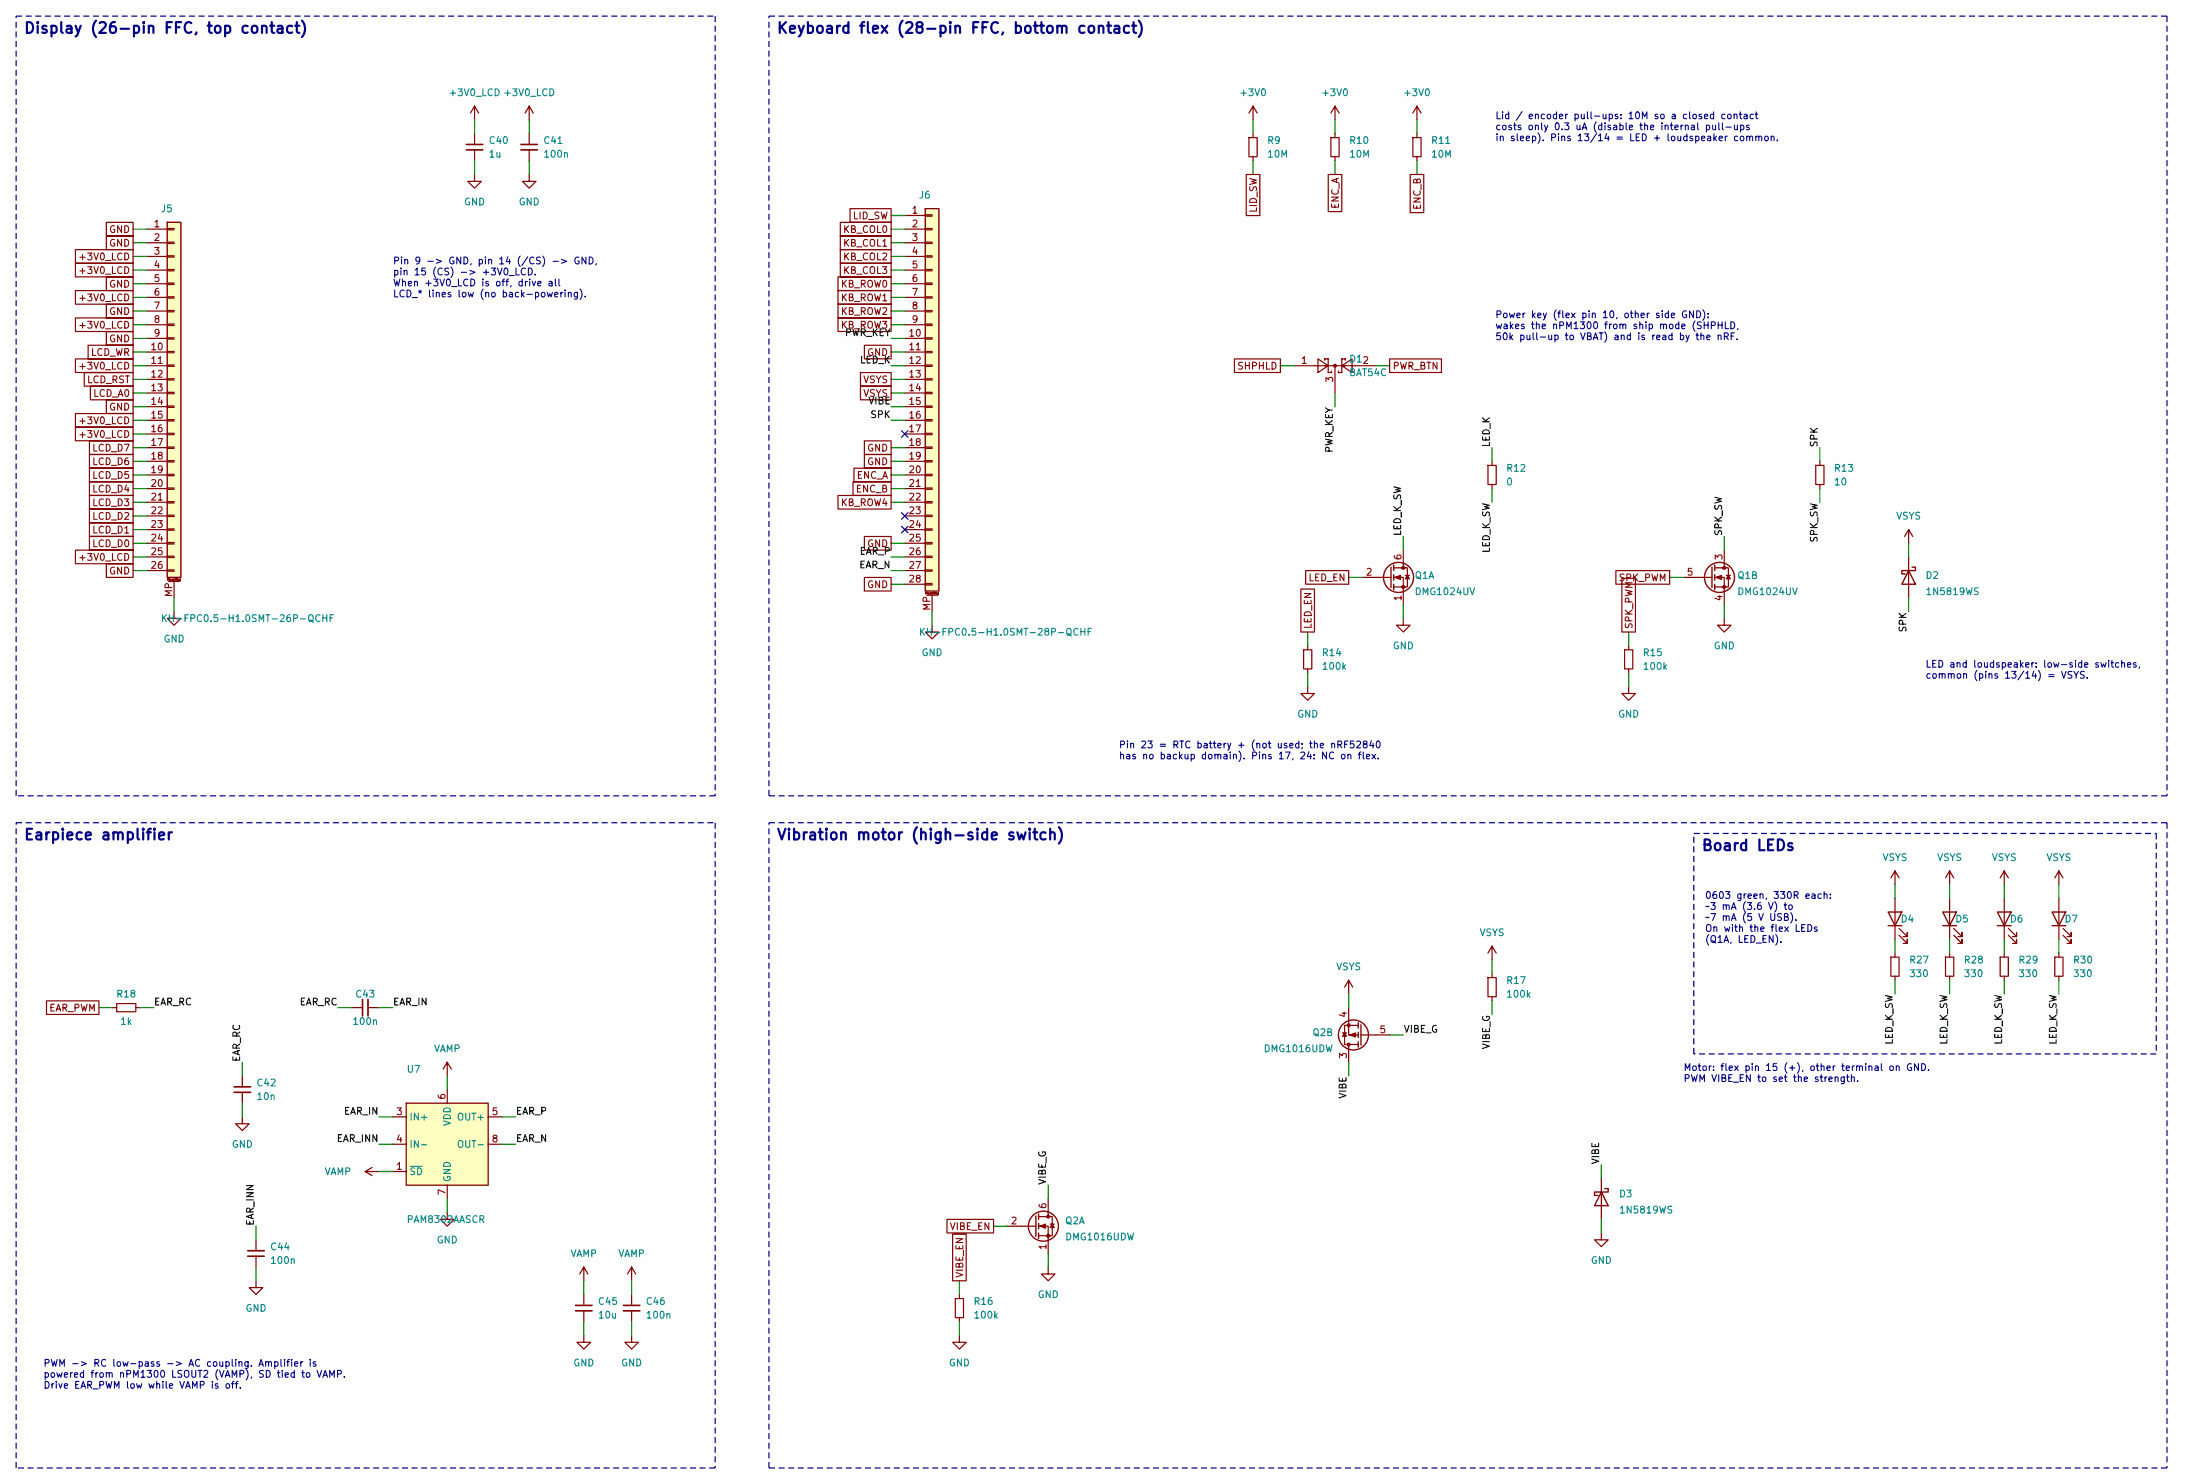
[picture p48: schematic ui.kicad_sch, User interface: display, keyboard flex, audio, vibration, L…]

Parts:
C40: 1u; C_0402_1005Metric
C41, C43, C44, C46: 100n; C_0402_1005Metric
C42: 10n; C_0402_1005Metric
C45: 10u; C_0603_1608Metric
D1: BAT54C; SOT-23; LCSC C916424
D2, D3: 1N5819WS; D_SOD-323; LCSC C191023
D4, D5, D6, D7: green; LED_0603_1608Metric; MPN 19-217/GHC-YR1S2/3T; LCSC C72043
J5: KH-FPC0.5-H1.0SMT-26P-QCHF; FPC-SMD_26P-P0.50_KH-FPC0.5-H1.0SMT-26P-QCHF; LCSC C3250122
J6: KH-FPC0.5-H1.0SMT-28P-QCHF; FPC-SMD_28P-P0.50_KH-FPC0.5-H1.0SMT-28P-QCHF; LCSC C3250123
Q1: DMG1024UV; SOT-563; LCSC C2759893
Q2: DMG1016UDW; SOT-363_SC-70-6; LCSC C211433
R9, R10, R11: 10M; R_0402_1005Metric
R12: 0; R_0402_1005Metric
R13: 10; R_0603_1608Metric
R14, R15, R16, R17: 100k; R_0402_1005Metric
R18: 1k; R_0402_1005Metric
R27, R28, R29, R30: 330; R_0402_1005Metric
U7: PAM8302AASCR; MSOP-8_3x3mm_P0.65mm; LCSC C113367

Connections:
+3V0: R9.1, R10.1, R11.1; also elsewhere on the board
+3V0_LCD: C40.1, C41.1, J5.3, J5.4, J5.6, J5.8, J5.11, J5.15, J5.16, J5.25; also elsewhere on the board
/UI/EAR_IN: C43.2, U7.3 (IN+)
/UI/EAR_INN: C44.1, U7.4 (IN-)
/UI/EAR_N: J6.27, U7.8 (OUT-)
/UI/EAR_P: J6.26, U7.5 (OUT+)
/UI/EAR_RC: C42.1, C43.1, R18.2
/UI/LED_K: J6.12, R12.1
/UI/LED_K_SW: Q1.6 (D), R12.2, R27.2, R28.2, R29.2, R30.2
/UI/PWR_KEY: D1.3, J6.10
/UI/SPK: D2.2 (A), J6.16, R13.1
/UI/SPK_SW: Q1.3 (D), R13.2
/UI/VIBE: D3.1 (K), J6.15, Q2.3 (D)
/UI/VIBE_G: Q2.5 (G), Q2.6 (D), R17.2
EAR_PWM: R18.1; also elsewhere on the board
ENC_A: J6.20, R10.2; also elsewhere on the board
ENC_B: J6.21, R11.2; also elsewhere on the board
GND: C40.2, C41.2, C42.2, C44.2, C45.2, C46.2, D3.2 (A), J5.1, J5.2, J5.5, J5.7, J5.9, J5.14, J5.26, J5.MP (MountPin), J6.11, J6.18, J6.19, J6.25, J6.28, J6.MP (MountPin), Q1.1 (S), Q1.4 (S), Q2.1 (S), R14.2, R15.2, R16.2, U7.7 (GND); also elsewhere on the board
KB_COL0: J6.2; also elsewhere on the board
KB_COL1: J6.3; also elsewhere on the board
KB_COL2: J6.4; also elsewhere on the board
KB_COL3: J6.5; also elsewhere on the board
KB_ROW0: J6.6; also elsewhere on the board
KB_ROW1: J6.7; also elsewhere on the board
KB_ROW2: J6.8; also elsewhere on the board
KB_ROW3: J6.9; also elsewhere on the board
KB_ROW4: J6.22; also elsewhere on the board
LCD_A0: J5.13; also elsewhere on the board
LCD_D0: J5.24; also elsewhere on the board
LCD_D1: J5.23; also elsewhere on the board
LCD_D2: J5.22; also elsewhere on the board
LCD_D3: J5.21; also elsewhere on the board
LCD_D4: J5.20; also elsewhere on the board
LCD_D5: J5.19; also elsewhere on the board
LCD_D6: J5.18; also elsewhere on the board
LCD_D7: J5.17; also elsewhere on the board
LCD_RST: J5.12; also elsewhere on the board
LCD_WR: J5.10; also elsewhere on the board
LED_EN: Q1.2 (G), R14.1; also elsewhere on the board
LID_SW: J6.1, R9.2; also elsewhere on the board
unnamed: D4.1 (K), R27.1
unnamed: D5.1 (K), R28.1
unnamed: D6.1 (K), R29.1
unnamed: D7.1 (K), R30.1
PWR_BTN: D1.2; also elsewhere on the board
SHPHLD: D1.1; also elsewhere on the board
SPK_PWM: Q1.5 (G), R15.1; also elsewhere on the board
VAMP: C45.1, C46.1, U7.1 (~SD), U7.6 (VDD); also elsewhere on the board
VIBE_EN: Q2.2 (G), R16.1; also elsewhere on the board
VSYS: D2.1 (K), D4.2 (A), D5.2 (A), D6.2 (A), D7.2 (A), J6.13, J6.14, Q2.4 (S), R17.1; also elsewhere on the board

Notes on the sheet:
0603 green, 330R each: ~3 mA (3.6 V) to ~7 mA (5 V USB). On with the flex LEDs (Q1A, LED_EN).
Earpiece amplifier
Motor: flex pin 15 (+), other terminal on GND. PWM VIBE_EN to set the strength.
Lid / encoder pull-ups: 10M so a closed contact costs only 0.3 uA (disable the internal pull-ups in sleep). Pins 13/14 = LED + loudspeaker common.
Power key (flex pin 10, other side GND): wakes the nPM1300 from ship mode (SHPHLD, 50k pull-up to VBAT) and is read by the nRF.
Pin 9 -> GND, pin 14 (/CS) -> GND, pin 15 (CS) -> +3V0_LCD. When +3V0_LCD is off, drive all LCD_* lines low (no back-powering).
PWM -> RC low-pass -> AC coupling. Amplifier is powered from nPM1300 LSOUT2 (VAMP), SD tied to VAMP. Drive EAR_PWM low while VAMP is off.
Board LEDs
Vibration motor (high-side switch)
Keyboard flex (28-pin FFC, bottom contact)
LED and loudspeaker: low-side switches, common (pins 13/14) = VSYS.
Pin 23 = RTC battery + (not used; the nRF52840 has no backup domain). Pins 17, 24: NC on flex.
Display (26-pin FFC, top contact)

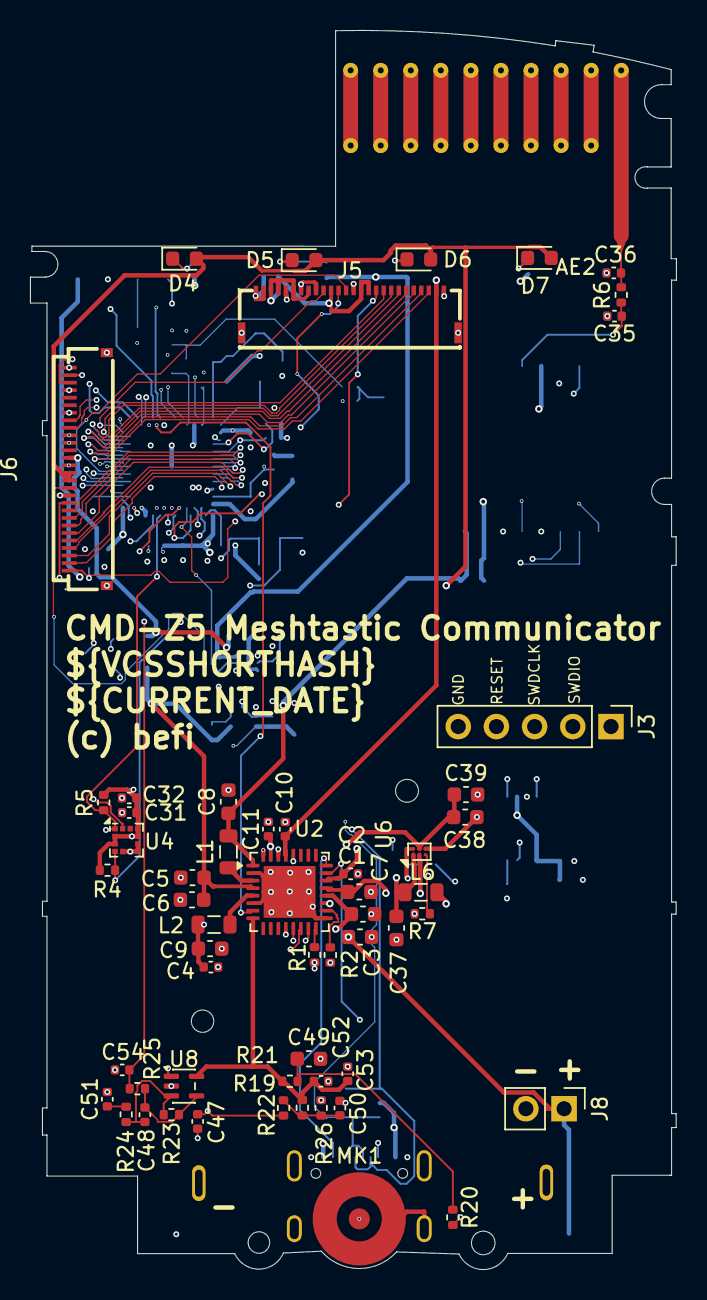
[picture p49: board cmd-z5.kicad_pcb from above]

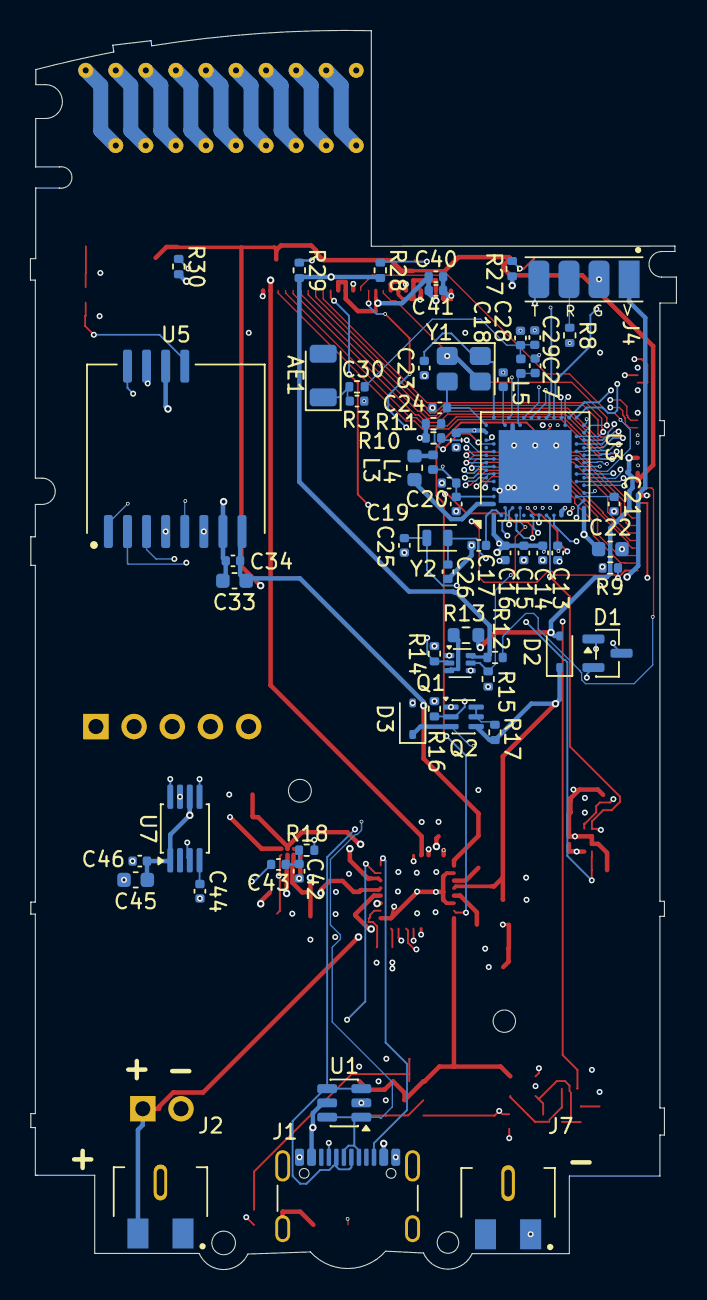
[picture p50: board cmd-z5.kicad_pcb from below]

Board: 6 copper layers, 43.0 x 82.4 mm, 120 parts (63 on the bottom side), 107 nets.
