befinitiv/cmd-z5-pager/sw/src/i18n.c

#include <string.h>

#include <zephyr/sys/util.h>

#include "i18n.h"

struct translation {
	const char *en;
	const char *text;
};

/*
 * German translations. Keep the texts short: a menu row holds about 18
 * characters, the small font on the status and hint lines 24.
 */
static const struct translation de[] = {
	/* Main menu */
	{"Menu", "Menü"},
	{"Messages", "Nachrichten"},
	{"Nodes", "Knoten"},
	{"Settings", "Einstellungen"},
	{"Hardware test", "Hardware-Test"},
	{"Games", "Spiele"},
	/* Channels */
	{"Channels", "Kanäle"},
	{"Channel", "Kanal"},
	{"Channel 1", "Kanal 1"},
	{"Channel 2", "Kanal 2"},
	{"Channel 3", "Kanal 3"},
	{"Channel name", "Kanalname"},
	{"Number", "Nummer"},
	{"Passphrase", "Passphrase"},
	{"QR code", "QR-Code"},
	{"No QR code", "Kein QR-Code"},
	{"Delete", "Löschen"},
	{"Delete channel", "Kanal löschen"},
	{"Delete the channel and its messages?", "Kanal und seine Nachrichten löschen?"},
	{"Delete all messages of this conversation?", "Alle Nachrichten dieser Unterhaltung löschen?"},
	{"Too short: at least 8 characters.", "Zu kurz: mindestens 8 Zeichen."},
	{"new", "neu"},
	{"Diagnostics", "Diagnose"},
	{"About", "Info"},
	{"%s is not implemented yet. It follows in a later phase.",
	 "%s ist noch nicht implementiert. Folgt in einer späteren Phase."},

	/* Home */
	{"time not set", "Zeit nicht gesetzt"},
	{"Mesh off", "Mesh aus"},
	{"push: Menu", "Drücken: Menü"},

	/* Settings */
	{"Display", "Display"},
	{"Sound", "Töne"},
	{"Text input", "Texteingabe"},
	{"Language", "Sprache"},
	{"Contrast", "Kontrast"},
	{"Backlight", "Beleuchtung"},
	{"Light off", "Licht aus"},
	{"Screen off", "Display aus"},
	{"Volume", "Lautstärke"},
	{"Key clicks", "Tastentöne"},
	{"Vibration", "Vibration"},
	{"on", "an"},
	{"off", "aus"},
	{"never", "nie"},
	{"Learn words", "Wörter lernen"},
	{"Delete learned", "Gelerntes löschen"},
	{"Learned words deleted.", "Gelernte Wörter gelöscht."},

	/* Messages */
	{"New message", "Neue Nachricht"},
	{"Inbox", "Posteingang"},
	{"CALL = send", "CALL = senden"},
	{"wheel: move  *: done", "Rad: bewegen *: fertig"},
	{"Sending messages follows in phase 3.", "Das Senden folgt in Phase 3."},

	/* Widgets */
	{"push = ok   C = cancel", "Drücken = OK  C = Abbr."},

	/* GPS and position */
	{"Fixed position", "Feste Position"},
	{"No GPS receiver", "Kein GPS-Empfänger"},
	{"Off", "Aus"},
	{"Fix", "Fix"},
	{"sat.", "Sat."},
	{"Searching", "Suche"},
	{"in view", "sichtbar"},
	{"heard", "empf."},
	{"ago", "her"},
	{"No position yet", "Noch keine Position"},
	{"push: settings", "Drücken: Einstellungen"},
	{"Position", "Position"},
	{"Share position", "Position teilen"},
	{"Use GPS fix", "GPS-Fix übernehmen"},
	{"fixed", "fest"},
	{"always", "immer"},
	{"approx.", "ungefähr"},
	{"exact", "genau"},
	{"set", "gesetzt"},
	{"No GPS fix yet.", "Noch kein GPS-Fix."},
	{"Enter latitude and longitude in degrees, e.g. 52.52 13.405 (south and west negative).",
	 "Breite und Länge in Grad eingeben, z. B. 52.52 13.405 (Süd und West negativ)."},

	/* Diagnostics */
	{"No battery data", "Keine Akkudaten"},
	{"Charge", "Ladung"},
	{"Voltage", "Spannung"},
	{"Power", "Versorgung"},
	{"Battery", "Akku"},
	{"Charging", "lädt"},
	{"Charged", "geladen"},
	{"Charger error", "Ladefehler"},
	{"Current", "Strom"},
	{"Drawn", "Entnommen"},
	{"Runtime", "Laufzeit"},
	{"Full in", "Voll in"},
	{"Temperature", "Temperatur"},
	{"Uptime", "Betriebszeit"},

	/* Hardware test */
	{"Blink LEDs", "LEDs blinken"},
	{"Vibrate", "Vibrieren"},
	{"Speaker 1 kHz", "Lautsprecher 1 kHz"},
	{"Earpiece 1 kHz", "Hörer 1 kHz"},
	{"Melody speaker", "Melodie Lautspr."},
	{"Melody earpiece", "Melodie Hörer"},
	{"Key test", "Tastentest"},
	{"Display test", "Displaytest"},
	{"Radio noise", "Funkrauschen"},
	{"Now", "Jetzt"},
	{"Average", "Mittel"},
	{"Last packet", "Letztes Paket"},
	{"No radio", "Kein Funkmodul"},
	{"Light", "Licht"},
	{"LCD off", "LCD aus"},
	{"Event: %s", "Ereignis: %s"},
	{"Key: %s", "Taste: %s"},
	{"Value: %+d", "Wert: %+d"},
	{"Wheel: %d", "Rad: %d"},
	{"Events: %d", "Ereignisse: %d"},
	{"Press a key", "Taste drücken"},
	{"hold C/bend up: exit", "C/zurück halten: Ende"},
	{"press", "gedrückt"},
	{"long", "lang"},
	{"release", "los"},
	{"wheel", "Rad"},

	/* About */
	{"Commit", "Commit"},
	{"Built", "Erstellt"},
	{"push: QR code", "Drücken: QR-Code"},

	/* Mesh */
	{"Mesh", "Mesh"},
	{"Name", "Name"},
	{"Short name", "Kurzname"},
	{"Region", "Region"},
	{"Preset", "Profil"},
	{"Node", "Knoten"},
	{"sending", "sendet"},
	{"sent", "gesendet"},
	{"delivered", "zugestellt"},
	{"no relay", "kein Relais"},
	{"failed", "fehlgeschl."},
	{"No messages", "Keine Nachrichten"},
	{"push: write", "Drücken: schreiben"},
	{"No nodes heard yet", "Noch keine Knoten"},
	{"Radio not available", "Funk nicht verfügbar"},
	{"Heard", "Gehört"},
	{"Hops", "Sprünge"},
	{"Encrypted DMs", "Verschlüsselte DMs"},
	{"No key (channel DMs)", "Kein Schlüssel"},
	{"push: message", "Drücken: Nachricht"},
	{"CALL = save", "CALL = speichern"},
	{"%d new message", "%d neue Nachricht"},
	{"%d new messages", "%d neue Nachrichten"},
	{"%d node", "%d Knoten"},
	{"%d new", "%d neu"},
	{"%d nodes", "%d Knoten"},
	{"The radio is not available.", "Der Funk ist nicht verfügbar."},

	/* Factory reset */
	{"Factory reset", "Werkseinstellungen"},
	{"All settings, messages, known nodes and learned words are deleted, "
	 "and the device gets a new key. CALL = reset, C = cancel.",
	 "Alle Einstellungen, Nachrichten, bekannten Knoten und gelernten Wörter werden "
	 "gelöscht, und das Gerät erhält einen neuen Schlüssel. CALL = zurücksetzen, "
	 "C = abbrechen."},

	/* Conversation menu */
	{"Silence", "Stumm"},
	{"Delete messages", "Nachrichten löschen"},
	{"Too many silenced conversations.", "Zu viele stumme Unterhaltungen."},

	/* Protocol, MeshCore */
	{"Protocol", "Protokoll"},
	{"Switch to MeshCore? The device restarts. CALL = switch, C = cancel.",
	 "Zu MeshCore wechseln? Das Gerät startet neu. CALL = wechseln, C = abbrechen."},
	{"Switch to Meshtastic? The device restarts. CALL = switch, C = cancel.",
	 "Zu Meshtastic wechseln? Das Gerät startet neu. CALL = wechseln, C = abbrechen."},
	{"Send advert", "Advert senden"},
	{"Advert", "Advert"},
	{"Sent to the mesh.", "Ins Mesh gesendet."},
	{"Key", "Schlüssel"},
	{"#name", "#Name"},
	{"Repeater", "Repeater"},
	{"Room server", "Raum-Server"},
	{"Sensor", "Sensor"},
	{"Route", "Route"},
	{"flood", "Flutung"},
	{"direct", "direkt"},
	{"route", "Route"},

	/* Relaying (Settings -> Mesh, diagnostics) */
	{"Relay packets", "Weiterleiten"},
	{"Relayed", "Weitergeleitet"},

	/* Node telemetry */
	{"Channel", "Kanal"},

	/* Time zone (UTC and the US zones stay as they are) */
	{"Time zone", "Zeitzone"},
	{"WET", "WEZ"},
	{"CET", "MEZ"},
	{"EET", "OEZ"},

	/* Firmware update */
	{"Firmware update", "Firmware-Update"},
	{"No bootloader in this build.", "Kein Bootloader in diesem Build."},
	{"Restarts into the bootloader, which waits for new firmware over USB. "
	 "CALL = restart, C = cancel.",
	 "Startet in den Bootloader, der auf neue Firmware über USB wartet. "
	 "CALL = neu starten, C = abbrechen."},

	/* Power */
	{"Power off", "Ausschalten"},
	{"Release the key to switch off.", "Taste loslassen zum Ausschalten."},
	{"Goodbye", "Auf Wiedersehen"},
	{"Battery empty, switching off.", "Akku leer, schalte aus."},
};

static const struct translation *const tables[LANG_COUNT] = {
	[LANG_EN] = NULL,
	[LANG_DE] = de,
};

static const size_t table_sizes[LANG_COUNT] = {
	[LANG_DE] = ARRAY_SIZE(de),
};

static enum lang current = LANG_EN;

void i18n_set(enum lang lang)
{
	current = lang < LANG_COUNT ? lang : LANG_EN;
}

enum lang i18n_get(void)
{
	return current;
}

const char *tr(const char *en)
{
	const struct translation *t = tables[current];

	for (size_t i = 0; t && i < table_sizes[current]; i++) {
		if (strcmp(t[i].en, en) == 0) {
			return t[i].text;
		}
	}
	return en;
}

const char *i18n_name(enum lang lang)
{
	return lang == LANG_DE ? "Deutsch" : "English";
}
