befinitiv/cmd-z5-pager/sw/src/screens/chat.c

/*
 * One conversation: the newest messages at the bottom, each with a small
 * header (sender and time, for own messages the delivery status). For
 * received messages the time alternates every second with how the message
 * arrived: RSSI and SNR if it came directly, else the hop count (RSSI and SNR
 * would be the last relay's). The wheel scrolls; push or CALL writes a reply.
 */

#include <stdio.h>

#include <zephyr/kernel.h>
#include <zephyr/sys/util.h>
#include <string.h>

#include "../clock.h"
#include "../i18n.h"
#include "../mesh/mesh.h"
#include "../mesh/msgstore.h"
#include "meshtastic/packet.h"
#include "screens.h"

/* Messages shown (copied from the store on each redraw). */
#define SHOWN     12
#define LINE_H    8
#define HEAD_H    7
#define MAX_ROWS  96

static uint32_t conv;
static int scroll; /* rows scrolled up from the bottom */
static bool show_radio; /* received messages: radio data instead of the time */

struct ui_screen chat_screen;

static struct msg shown[SHOWN];
static int nshown;

/* A row is a message header or one wrapped line of a message. */
struct row {
	uint8_t msg;
	uint8_t head;     /* 1 = header row */
	uint16_t offset;  /* start of the line in the text */
	uint8_t len;
};

static struct row rows[MAX_ROWS];
static int nrows;

void chat_open(uint32_t c)
{
	conv = c;
	scroll = 0;
	ui_push(&chat_screen);
}

bool chat_showing(uint32_t c)
{
	return ui_top() == &chat_screen && conv == c;
}

static void load(void)
{
	int idx[SHOWN];
	int n = 0;

	msgstore_lock();
	for (int i = msgstore_count() - 1; i >= 0 && n < SHOWN; i--) {
		if (msgstore_get(i)->conv == conv) {
			idx[n++] = i;
		}
	}
	nshown = n;
	for (int i = 0; i < n; i++) {
		shown[n - 1 - i] = *msgstore_get(idx[i]); /* oldest first */
	}
	msgstore_mark_read(conv);
	msgstore_unlock();

	nrows = 0;
	for (int m = 0; m < nshown && nrows < MAX_ROWS; m++) {
		const char *t = shown[m].text;
		char who[2];
		/* Without the sender's name where MeshCore puts it into the text. */
		const char *p = mesh_msg_text(&shown[m], who, sizeof(who));
		int width = GFX_WIDTH - 3 - (shown[m].outgoing ? 8 : 0);

		rows[nrows++] = (struct row){.msg = m, .head = 1};
		while (*p && nrows < MAX_ROWS) {
			const char *next;
			int len = gfx_wrap(gfx_font_text, p, width, &next);

			rows[nrows++] = (struct row){.msg = m, .offset = p - t, .len = len};
			p = next;
		}
	}
}

static int row_h(const struct row *r)
{
	return r->head ? HEAD_H : LINE_H;
}

static const char *status_text(const struct msg *m)
{
	switch (m->status) {
	case MSG_QUEUED:
		return tr("sending");
	case MSG_SENT:
		return tr("sent");
	case MSG_DELIVERED:
		return tr("delivered");
	case MSG_NO_ACK:
		return tr("no relay");
	case MSG_FAILED:
		return tr("failed");
	default:
		return "";
	}
}

/* How a received message arrived; "" if unknown. */
static void radio_text(const struct msg *m, char *buf, size_t size)
{
	if (!m->has_radio) {
		buf[0] = '\0';
	} else if (m->route_hops) {
		if (m->hops == 0) {
			snprintf(buf, size, "%s", tr("direct"));
		} else {
			snprintf(buf, size, "%s %u %s", tr("route"), m->hops,
				 tr(m->hops == 1 ? "hop" : "hops"));
		}
	} else if (m->hops == 0) {
		snprintf(buf, size, "%ddBm %ddB", m->rssi, m->snr);
	} else if (m->hops != MSG_HOPS_UNKNOWN) {
		snprintf(buf, size, "%u %s", m->hops, tr(m->hops == 1 ? "hop" : "hops"));
	} else {
		snprintf(buf, size, "? %s", tr("hops"));
	}
}

static void draw_header(struct gfx *g, int y, const struct msg *m)
{
	char who[20], line[40], when[24] = "";

	if (!m->outgoing && (show_radio || !m->time)) {
		radio_text(m, when, sizeof(when));
	}
	if (!when[0] && m->time) {
		struct clock_tm tm;

		clock_local(m->time, &tm);
		snprintf(when, sizeof(when), "%02d:%02d", tm.hour, tm.min);
	}
	if (m->outgoing) {
		snprintf(line, sizeof(line), "%s %s", when, status_text(m));
		gfx_text_aligned(g, gfx_font_small, 0, y, GFX_WIDTH - 2, GFX_ALIGN_RIGHT, line,
				 m->status == MSG_FAILED ? GFX_BLACK : GFX_DARK);
	} else {
		/* The time or radio data on the right, the sender's name before it. */
		int w = when[0] ? gfx_text_width(gfx_font_small, when, -1) + 4 : 0;

		mesh_msg_text(m, who, sizeof(who));
		gfx_text_fit(g, gfx_font_small, 1, y, GFX_WIDTH - 3 - w, who, GFX_DARK);
		gfx_text_aligned(g, gfx_font_small, 0, y, GFX_WIDTH - 2, GFX_ALIGN_RIGHT, when,
				 GFX_DARK);
	}
}

static void chat_draw(struct ui_screen *s, struct gfx *g)
{
	char title[24];
	char buf[MSG_TEXT_MAX + 1];

	ARG_UNUSED(s);
	mesh_conv_name(conv, title, sizeof(title));
	int y0 = ui_draw_title(g, title);
	int area = GFX_HEIGHT - y0;

	load();
	if (nrows == 0) {
		gfx_text_aligned(g, gfx_font_text, 0, y0 + 20, GFX_WIDTH, GFX_ALIGN_CENTER,
				 tr("No messages"), GFX_DARK);
		gfx_text_aligned(g, gfx_font_small, 0, y0 + 32, GFX_WIDTH, GFX_ALIGN_CENTER,
				 tr("push: write"), GFX_DARK);
		return;
	}
	if (scroll > nrows - 1) {
		scroll = nrows - 1;
	}
	/* Fill from the bottom upwards, starting `scroll` rows above the last. */
	int y = GFX_HEIGHT;
	int first = nrows - 1 - scroll;

	gfx_set_clip(g, 0, y0, GFX_WIDTH, area);
	for (int i = first; i >= 0 && y > y0; i--) {
		const struct row *r = &rows[i];
		const struct msg *m = &shown[r->msg];

		y -= row_h(r);
		if (r->head) {
			draw_header(g, y, m);
		} else {
			int x = m->outgoing ? 9 : 1;

			memcpy(buf, m->text + r->offset, r->len);
			buf[r->len] = '\0';
			gfx_text(g, gfx_font_text, x, y, buf, GFX_BLACK);
			if (m->outgoing) {
				gfx_vline(g, 6, y, LINE_H, GFX_LIGHT);
			}
		}
	}
	gfx_reset_clip(g);
	/* The scrollbar counts from the top: the oldest row is 0. */
	int visible = area / LINE_H;

	ui_draw_scrollbar(g, y0, area, MAX(nrows - visible - scroll, 0), visible, nrows);
}

static bool chat_event(struct ui_screen *s, const struct ui_event *ev)
{
	ARG_UNUSED(s);
	if (ev->type == UI_EV_WHEEL) {
		scroll += ev->value; /* up = older */
		if (scroll < 0) {
			scroll = 0;
		}
		ui_invalidate();
		return true;
	}
	if (ui_ev_press(ev, UI_KEY_SELECT) || ui_ev_press(ev, UI_KEY_CALL)) {
		compose_open_message(conv);
		return true;
	}
	if (ui_ev_press(ev, UI_KEY_MEMO) && conv_channel(conv) < 0) {
		node_detail_open(conv);
		return true;
	}
	return false;
}

static void chat_poll(struct ui_screen *s)
{
	bool radio = (k_uptime_get() / 1000) & 1;

	ARG_UNUSED(s);
	if (radio != show_radio) {
		show_radio = radio;
		ui_invalidate();
	}
}

static void chat_enter(struct ui_screen *s)
{
	ARG_UNUSED(s);
	scroll = 0;
}

struct ui_screen chat_screen = {
	.event = chat_event,
	.draw = chat_draw,
	.enter = chat_enter,
	.poll = chat_poll,
};
