befinitiv/cmd-z5-pager/sw/src/hw.c

#include <stddef.h>
#include <string.h>

#include <zephyr/device.h>
#include <zephyr/drivers/led.h>
#include <zephyr/drivers/mfd/npm13xx.h>
#include <zephyr/kernel.h>
#include <zephyr/logging/log.h>
#include <zephyr/logging/log_ctrl.h>
#include <zephyr/sys/reboot.h>

#include <cmdz5/drivers/audio_out.h>
#include <cmdz5/drivers/lcd.h>

#include "hw.h"
#include "synth/synth.h"

#ifdef CONFIG_CMDZ5_EMUL
#include "../emul/frontpanel.h"
#endif

#if DT_NODE_HAS_STATUS_OKAY(DT_NODELABEL(pmic)) && defined(CONFIG_MFD_NPM13XX)
#define HAVE_PMIC 1
static const struct device *const pmic = DEVICE_DT_GET(DT_NODELABEL(pmic));
/* nPM1300 SHIP block: TASKENTERSHIPMODE (datasheet register map, verify on the board). */
#define NPM1300_SHIP_BASE            0x0B
#define NPM1300_TASK_ENTER_SHIP_MODE 0x02
#include <hal/nrf_power.h>
#include <zephyr/drivers/regulator.h>
#include <zephyr/dt-bindings/regulator/npm13xx.h>
/*
 * GPREGRET2 (kept over a reset): switched off while on USB power, see
 * hw_boot_off(). GPREGRET1 holds MCUboot's boot mode.
 */
#define OFF_MARK 0x5a
#endif

LOG_MODULE_REGISTER(hw, CONFIG_CMDZ5_APP_LOG_LEVEL);

static const struct device *const lcd = DEVICE_DT_GET(DT_NODELABEL(lcd));
static const struct device *const speaker = DEVICE_DT_GET(DT_NODELABEL(speaker));
static const struct device *const earpiece = DEVICE_DT_GET(DT_NODELABEL(earpiece));
static const struct led_dt_spec backlight = LED_DT_SPEC_GET(DT_NODELABEL(backlight));
static const struct led_dt_spec vibration = LED_DT_SPEC_GET(DT_NODELABEL(vibration));

BUILD_ASSERT(GFX_FB_SIZE == LCD_STRIDE * LCD_HEIGHT, "framebuffer format mismatch");

/* What the display currently shows, to skip unchanged rows. */
static uint8_t shadow[GFX_FB_SIZE];
static bool display_on;

static uint8_t backlight_level;
static struct k_work_delayable blink_work;
static int blink_steps;

static struct k_work_delayable vibrate_work;

/*
 * Sound: one synthesiser per output, rendered by the output's audio thread
 * through fill(). Beeps (key clicks, test tones) are short square waves; the
 * loudspeaker plays melodies as a plucked pulse wave, the earpiece softer as
 * a triangle wave.
 */
struct audio {
	const struct device *dev;
	const struct synth_timbre *beep;
	const struct synth_timbre *melody;
	struct synth synth;
	struct k_mutex lock;
};

static const struct synth_timbre beep_square = {SYNTH_PULSE, 50, 1, 0, 100, 6};
static const struct synth_timbre melody_pulse = {SYNTH_PULSE, 25, 2, 150, 65, 25};
static const struct synth_timbre soft_triangle = {SYNTH_TRIANGLE, 0, 3, 150, 70, 30};

static struct audio audio[] = {
	[HW_SPEAKER] = {.beep = &beep_square, .melody = &melody_pulse},
	[HW_EARPIECE] = {.beep = &soft_triangle, .melody = &soft_triangle},
};

BUILD_ASSERT(sizeof(struct hw_note) == sizeof(struct synth_note) &&
		     offsetof(struct hw_note, freq) == offsetof(struct synth_note, freq) &&
		     offsetof(struct hw_note, ms) == offsetof(struct synth_note, ms),
	     "hw_note and synth_note must match");

int hw_display_power(bool on)
{
	int ret = lcd_set_power(lcd, on);

	if (ret == 0) {
		display_on = on;
		/* The controller is cleared on power-up; resend everything. */
		memset(shadow, 0, sizeof(shadow));
	}
	return ret;
}

bool hw_display_is_on(void)
{
	return display_on;
}

void hw_display_contrast(uint8_t value)
{
	lcd_set_contrast(lcd, value);
}

void hw_display_flush(struct gfx *g)
{
	int first, count;

	if (!gfx_take_dirty(g, &first, &count) || !display_on) {
		return;
	}
	/* Send runs of changed rows. */
	for (int y = first; y < first + count;) {
		if (memcmp(&shadow[y * LCD_STRIDE], &g->fb[y * LCD_STRIDE], LCD_STRIDE) == 0) {
			y++;
			continue;
		}
		int run = y;

		while (run < first + count &&
		       memcmp(&shadow[run * LCD_STRIDE], &g->fb[run * LCD_STRIDE], LCD_STRIDE)) {
			run++;
		}
		lcd_write_rows(lcd, g->fb, y, run - y);
		memcpy(&shadow[y * LCD_STRIDE], &g->fb[y * LCD_STRIDE], (run - y) * LCD_STRIDE);
		y = run;
	}
}

void hw_backlight(uint8_t percent)
{
	k_work_cancel_delayable(&blink_work);
	backlight_level = MIN(percent, 100);
	led_set_brightness_dt(&backlight, backlight_level);
}

static void blink_handler(struct k_work *work)
{
	ARG_UNUSED(work);

	if (blink_steps-- > 0) {
		led_set_brightness_dt(&backlight, (blink_steps & 1) ? 100 : 0);
		k_work_schedule(&blink_work, K_MSEC(250));
	} else {
		led_set_brightness_dt(&backlight, backlight_level);
	}
}

void hw_backlight_blink(int n)
{
	blink_steps = 2 * n;
	k_work_reschedule(&blink_work, K_NO_WAIT);
}

static void vibrate_off(struct k_work *work)
{
	ARG_UNUSED(work);
	led_off_dt(&vibration);
}

void hw_vibrate(uint32_t ms)
{
	led_on_dt(&vibration);
	k_work_reschedule(&vibrate_work, K_MSEC(ms));
}

static bool audio_fill(int16_t *buf, size_t n, void *user)
{
	struct audio *a = user;
	bool more;

	k_mutex_lock(&a->lock, K_FOREVER);
	more = synth_render(&a->synth, buf, n);
	k_mutex_unlock(&a->lock);
	return more;
}

void hw_tone(enum hw_sink sink, uint32_t freq_hz, uint32_t ms, uint8_t volume)
{
	struct audio *a = &audio[sink];

	k_mutex_lock(&a->lock, K_FOREVER);
	synth_note(&a->synth, a->beep, freq_hz, ms, volume);
	k_mutex_unlock(&a->lock);
	audio_out_start(a->dev, audio_fill, a);
}

void hw_melody(enum hw_sink sink, const struct hw_note *notes, size_t count, uint8_t volume)
{
	struct audio *a = &audio[sink];

	k_mutex_lock(&a->lock, K_FOREVER);
	synth_melody(&a->synth, a->melody, (const struct synth_note *)notes, count, volume);
	k_mutex_unlock(&a->lock);
	audio_out_start(a->dev, audio_fill, a);
}

void hw_audio_stop(void)
{
	for (size_t i = 0; i < ARRAY_SIZE(audio); i++) {
		k_mutex_lock(&audio[i].lock, K_FOREVER);
		synth_stop(&audio[i].synth);
		k_mutex_unlock(&audio[i].lock);
		audio_out_stop(audio[i].dev);
	}
}

/* Supply noise test ----------------------------------------------------------- */

static bool supply_pwm[2];
#ifndef HAVE_PMIC
static bool supply_dcdc = true;
#endif

void hw_supply_dcdc(bool on)
{
#ifdef HAVE_PMIC
	/* REG1 may switch between DC/DC and LDO at any time. */
	nrf_power_dcdcen_set(NRF_POWER, on);
#else
	supply_dcdc = on;
#endif
}

bool hw_supply_dcdc_on(void)
{
#ifdef HAVE_PMIC
	return nrf_power_dcdcen_get(NRF_POWER);
#else
	return supply_dcdc;
#endif
}

int hw_supply_pwm(int buck, bool forced)
{
	int ret = 0;

	if (buck < 1 || buck > ARRAY_SIZE(supply_pwm)) {
		return -EINVAL;
	}
#ifdef HAVE_PMIC
	static const struct device *const bucks[] = {
		DEVICE_DT_GET(DT_NODELABEL(radio_supply)),
		DEVICE_DT_GET(DT_NODELABEL(main_supply)),
	};

	ret = regulator_set_mode(bucks[buck - 1],
				 forced ? NPM13XX_BUCK_MODE_PWM : NPM13XX_BUCK_MODE_AUTO);
	if (ret != 0) {
		LOG_WRN("buck %d mode: %d", buck, ret);
	}
#endif
	if (ret == 0) {
		supply_pwm[buck - 1] = forced;
	}
	return ret;
}

bool hw_supply_pwm_on(int buck)
{
	return buck >= 1 && buck <= ARRAY_SIZE(supply_pwm) && supply_pwm[buck - 1];
}

bool hw_usb_power(void)
{
#ifdef HAVE_PMIC
	return nrf_power_usbregstatus_vbusdet_get(NRF_POWER);
#else
	return false;
#endif
}

bool hw_boot_off(void)
{
#ifdef HAVE_PMIC
	bool off = NRF_POWER->GPREGRET2 == OFF_MARK;

	NRF_POWER->GPREGRET2 = 0;
	return off;
#else
	return false;
#endif
}

FUNC_NORETURN void hw_power_off(void)
{
	hw_audio_stop();
	led_off_dt(&vibration);
	hw_backlight(0);
	hw_display_power(false);

#if defined(CONFIG_CMDZ5_EMUL)
	frontpanel_power_off();
#elif defined(HAVE_PMIC)
	if (hw_usb_power()) {
		/* USB power would wake the PMIC from ship mode at once. */
		LOG_INF("USB power: restarting into the off state");
		NRF_POWER->GPREGRET2 = OFF_MARK;
		log_flush();
		sys_reboot(SYS_REBOOT_WARM);
	}
	LOG_INF("entering ship mode");
	log_flush();
	int ret = mfd_npm13xx_reg_write(pmic, NPM1300_SHIP_BASE, NPM1300_TASK_ENTER_SHIP_MODE, 1);

	/* Still running: the write failed, or USB power keeps the PMIC awake. */
	k_msleep(2000);
	LOG_WRN("ship mode not entered (%d), restarting", ret);
	log_flush();
	sys_reboot(SYS_REBOOT_COLD);
#endif
	for (;;) {
		k_sleep(K_FOREVER);
	}
}

int hw_init(void)
{
	const struct device *devs[] = {lcd, speaker, earpiece, backlight.dev, vibration.dev};

	for (size_t i = 0; i < ARRAY_SIZE(devs); i++) {
		if (!device_is_ready(devs[i])) {
			LOG_ERR("device %s not ready", devs[i]->name);
			return -ENODEV;
		}
	}
	k_work_init_delayable(&blink_work, blink_handler);
	k_work_init_delayable(&vibrate_work, vibrate_off);
	audio[HW_SPEAKER].dev = speaker;
	audio[HW_EARPIECE].dev = earpiece;
	for (size_t i = 0; i < ARRAY_SIZE(audio); i++) {
		k_mutex_init(&audio[i].lock);
		synth_init(&audio[i].synth, audio_out_rate(audio[i].dev));
	}
	return 0;
}
