befinitiv/cmd-z5-pager/sw/src/hw.h

/*
 * Access to the phone hardware through the devicetree node labels that the
 * board and the emulator both define (lcd, backlight, vibration, speaker,
 * earpiece).
 */

#pragma once

#include <stdbool.h>
#include <stddef.h>
#include <stdint.h>

#include <zephyr/toolchain.h>

#include "gfx/gfx.h"

enum hw_sink {
	HW_SPEAKER,
	HW_EARPIECE,
};

struct hw_note {
	uint16_t freq; /* Hz, 0 = rest */
	uint16_t ms;
};

int hw_init(void);

int hw_display_power(bool on);
bool hw_display_is_on(void);
void hw_display_contrast(uint8_t value);
/* Send the changed rows of the framebuffer to the display. */
void hw_display_flush(struct gfx *g);

/* Backlight brightness 0..100 (keypad and display LEDs share one switch). */
void hw_backlight(uint8_t percent);
/* Blink the backlight n times, then restore the last brightness. */
void hw_backlight_blink(int n);

void hw_vibrate(uint32_t ms);

/*
 * Sound is synthesised (lib/synth) and played as PCM. A tone plays alongside
 * a running melody; up to three tones sound at once.
 */
void hw_tone(enum hw_sink sink, uint32_t freq_hz, uint32_t ms, uint8_t volume);
/* Play a note sequence in the background. Replaces a running melody. */
void hw_melody(enum hw_sink sink, const struct hw_note *notes, size_t count, uint8_t volume);
void hw_audio_stop(void);

/*
 * Switch the device completely off: nPM1300 ship mode on the board (holding
 * the power key for about 1 s switches it on again), on the emulator a
 * blank panel until Esc is held. With USB power the PMIC cannot stay in ship
 * mode; the board then restarts into the off state (hw_boot_off()). Does not
 * return.
 */
FUNC_NORETURN void hw_power_off(void);
/*
 * Supply noise test (radio noise screen): the nRF52840's DC/DC regulator
 * (off: its LDO) and forced PWM on one of the nPM1300's bucks (1: radio,
 * 2: main rail; off: automatic PWM/PFM). Not stored; the defaults are the
 * LDO (devicetree) and automatic.
 */
void hw_supply_dcdc(bool on);
bool hw_supply_dcdc_on(void);
int hw_supply_pwm(int buck, bool forced);
bool hw_supply_pwm_on(int buck);
/* USB power present (board: VBUS seen by the nRF52840). */
bool hw_usb_power(void);
/*
 * True once after hw_power_off() restarted into the off state because of
 * USB power: the device must look switched off until the power key is held
 * or USB is removed.
 */
bool hw_boot_off(void);
