befinitiv/cmd-z5-pager/sw/tests/meshcore/main.c

#include <stdio.h>

int failures;

void test_crypto(void);
void test_packet(void);
void test_mesh(void);

int main(void)
{
	test_crypto();
	test_packet();
	test_mesh();
	printf("%s (%d failure%s)\n", failures ? "FAILED" : "OK", failures,
	       failures == 1 ? "" : "s");
	return failures ? 1 : 0;
}
