befinitiv/cmd-z5-pager/(commit log)

2026-10-02 HW documentation, first draft of schematic
    [cmd-z5.kicad_sch, mcu.kicad_sch, power.kicad_sch, radio_gps.kicad_sch, ui.kicad_sch]
2026-10-02 Added board outline and did initial component placement
    [cmd-z5.kicad_pcb, radio_gps.kicad_sch]
2026-10-02 Replaced FFC connectors with low profile ones
    [cmd-z5.kicad_pcb, ui.kicad_sch]
2026-10-03 Added microphone and battery contacts
    [cmd-z5.kicad_pcb, cmd-z5.kicad_sch, mcu.kicad_sch, power.kicad_sch, radio_gps.kicad_sch, ui.kicad_sch]
2026-10-03 Added extra battery contacts header
    [power.kicad_sch]
2026-10-04 Fixed component positions
    [cmd-z5.kicad_pcb, ui.kicad_sch]
2026-10-04 Few physical modifications
    [cmd-z5.kicad_pcb, power.kicad_sch, radio_gps.kicad_sch, ui.kicad_sch]
2026-10-05 Optimized placement
    [cmd-z5.kicad_pcb, mcu.kicad_sch, radio_gps.kicad_sch]
2026-10-05 Started some manual routing
    [cmd-z5.kicad_pcb]
2026-10-06 Board fully routed
    [cmd-z5.kicad_pcb]
2026-10-06 Placed silkscreen
    [cmd-z5.kicad_pcb]
2026-10-07 Some DRC fixes
    [cmd-z5.kicad_pcb]
2026-10-08 Software phase 1: board support, emulator and UI framework
    Zephyr (nRF Connect SDK v3.4.1) application for the CMD-Z5 board that also
    builds for native_sim with an SDL2 front panel emulator.
    - Board definition cmdz5/nrf52840 with keypad matrix, wheel, lid, power
    key, PWM backlight/vibration/audio, nPM1300 rails and charger, SX1262,
    flash partitions for code, language models, settings and LittleFS
    - Drivers for the reverse-engineered display controller (GPIO bus) and
    PWM tone output
    - Emulator: display controller model, clickable keypad, mouse wheel,
    green backlight, vibration, speaker/earpiece audio, lid and power key,
    --script for automated UI tests and screenshots
    - 2 bpp graphi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
    [app.h, audio_pwm.c, clock.c, clock.h]
2026-10-08 Software phase 2: predictive text for German and English
    - tools/lmbuild: corpus processing (Tatoeba, Leipzig web corpus),
    truecasing, n-gram counting, absolute discounting with backoff,
    budget-driven pruning, Huffman-coded lexicon sorted by key sequence,
    Rice-coded bigram/trigram tables with quantised costs; evaluation by
    simulated typing through the C engine (ctypes)
    - lm/de.lm, lm/en.lm: 20000 words, ~29k bigrams, ~10k trigrams, 176 KB each
    - lib/textinput: model reader, T9 with completions and next-word
    prediction, trigram context, user model and conversation cache, editor
    with T9/multitap/123 modes, punctuation, symbol picker, case modes and
    learning of unknown words
    - Com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
2026-10-09 Status bar only on the home screen, cursor placement in text entry
    - UI: screens request the status bar (only the home screen does); all
    other screens use the whole display (menus show 7 rows)
    - Editor: text is inserted and deleted at a cursor; '*' toggles cursor
    mode, in which the wheel moves the blinking cursor instead of
    selecting suggestions; typing or push ends it, C deletes before the
    cursor and stays in cursor mode
    - Compose screen draws the composing word at the cursor and scrolls to
    keep the cursor visible
    - Host tests for cursor editing
2026-10-09 Software phase 3: Meshtastic messaging
    - lib/meshtastic: over-the-air protocol of Meshtastic firmware 2.7,
    re-implemented (no Meshtastic code): 16-byte header, hand-written
    protobuf codec (Data, User, Position, Routing), AES-128/256 CTR and
    CCM, SHA-256, X25519, channel key expansion and hash, frequency slots,
    presets and regions, managed flooding router with SNR-weighted relay
    delay, relay cancelling, ACKs, retries, implicit ACKs and re-ACKs, PKI
    direct messages, node database
    - Mesh service: router thread, node number and key pair, NodeInfo
    exchange, node persistence, message store with delivery status
    - Emulated LoRa radio: UDP multicast on loopback between emulator
    instan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
2026-10-09 Language models in the lm flash partition
    - tools/lmbuild/pack.py packs the models (directory + data) for the lm
    partition; lib/textinput reads them in place (ti_pack_find)
    - modules/lm_image: Zephyr module that builds the pack and merged.hex
    (application + models) and makes `west flash` write it
    - The emulator keeps the models linked into the program
    - Without models the editor offers multitap and 123 only
    - Board application: 143 KB instead of 502 KB
2026-10-09 Store messages persistently in LittleFS
    - LittleFS on the lfs partition (board and emulator)
    - Append-only message log (/lfs/msgs.log): new messages, status
    changes and read marks as small records, replayed at startup, compacted
    above 24 KB; messages still queued at shutdown are shown as failed
2026-10-09 Factory reset in the settings
    - Settings > Factory reset with a confirmation dialog: erases the
    settings partition (configuration, mesh identity and keys, known nodes,
    learned words), deletes the stored messages and restarts
    - ui_confirm(): reusable confirmation dialog
    - README: storage overview corrected, message storage described
    [factory.c, i18n.c, settings.c]
2026-10-09 Light and screen timeouts can be switched off
    - Settings > Display: "Light off" now also offers "never"
    - Defaults: light off after 10 s, screen off never
2026-10-09 Subtle click on wheel steps when key clicks are on
2026-10-10 Battery measurement, fuel gauge and diagnostics screen
    - src/battery.c: samples the battery once a second, keeps averages of the
    current over the last minute and hour and the charge drawn
    - Board: nPM1300 charger sensor (voltage, current, die temperature, charge
    and VBUS state) and nRF Fuel Gauge (state of charge, time to empty and
    full); fuel gauge state stored every 6 h and before switching off.
    Battery model: Nordic's example model until the real cell is profiled
    - Emulator: simulated 1000 mAh battery whose current follows the emulated
    outputs, quantised like the nPM1300 ADC; USB power with the U key, the
    new USB indicator or 'usb on|off' in scripts
    - Diagnostics screen in the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
2026-10-10 Key 1: list the punctuation choices in the bar
    While a key 1 character is pending, the bar shows all its choices with the
    current one highlighted like the selected word. The wheel steps through
    them and keeps the character open, push accepts it.
2026-10-10 Z5 Jump: jump and run game on wheel bend down
    A small platformer in the style of the Game Boy games, opened with the
    wheel bent down on the home screen:
    - 1-1 overground: pits, pipes, bricks, ? and M blocks, walkers to stomp,
    grow item, staircases, flag; variable jump height
    - 1-2 under water: swimming, fish and jellies, coral passages, exit pipe
    - Score, coins, lives, timer, best score in the settings, sound effects
    - Level maps generated by tools/game/level.py
    - app_set_frame_ms(): the main loop runs at 30 fps while the game is open
    [app.h, game.c, home.c, main.c, screens.h]
2026-10-10 PCM audio output via PWM EasyDMA with a software synthesiser
    - lib/synth: 4 voices (band-limited pulse, triangle, sine, noise),
    ADSR envelopes, melody sequencer; host tests in tests/synth
    - audio_out is now a PCM stream API: the output pulls blocks from a
    fill() callback and switches itself off after a few silent blocks
    - Board: PWM1/PWM2 as 8-bit DACs (62.5 kHz carrier, 15625 samples/s),
    two EasyDMA sequences refilled by an audio thread; the speaker offset
    follows the signal peak (no DC in silence), the earpiece idles at
    mid-level with ramps
    - Emulator: one mixer thread feeds both outputs into SDL audio, 8 bits
    - hw_tone()/hw_melody() unchanged for callers; tones now mix with a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
    [audio_pwm.c, hw.c]
2026-10-12 About screen: git commit and version, QR code of the project
    - Shows the short git hash (+ for uncommitted changes), git describe,
    the Zephyr version and the build date
    - cmake/git_version.cmake reads git on every build into
    app_generated/git_version.h (rewritten only when it changes)
    - Push shows a QR code of https://github.com/befinitiv/cmd-z5-pager,
    generated by tools/qr/gen_qr.py
    [about.c, i18n.c, menu.c]
2026-10-21 Board: REG1 in LDO mode
    On the first board the nRF52840 locks up a few milliseconds after REG1
    switches to DC/DC: SWD stops answering and only a power cycle (USB and
    battery) recovers it. In LDO mode it runs stably. The DCC -> 10 uH ->
    15 nH -> DEC4 inductors are to be checked before going back to DC/DC.
2026-10-21 Board: keypad rows, lid and power key on GPIO port SENSE
    GPIOTE has only 8 channels, so the keypad driver failed with -ENOMEM
    on the board. The keypad rows, lid and power key now use the port
    SENSE interrupt (sense-edge-mask), leaving GPIOTE channels for the
    wheel, the nPM1300, the LIS2DH12 and SX1262 DIO1.
2026-10-21 SX1262 mesh radio driver for the board
    Zephyr's lora API cannot set the Meshtastic sync word 0x2b, so the board
    gets its own driver (cmdz5,sx1262) for the mesh_radio API the emulator
    already implements. It switches on BUCK1, resets the chip and checks it
    by the sync word register's reset value, sets up the TCXO on DIO3, the
    DIO2 RF switch, DC-DC and boosted RX gain, applies errata 15.1, 15.2 and
    15.4, receives continuously and listens before it talks (random backoff
    of 0-7 slots of 4 symbols, then CAD). DIO1 wakes an interrupt thread.
    Tested on the board: chip found, configured for EU_868 LongFast
    (869.525 MHz, SF11, 250 kHz, sync 0x2b, 22 dBm), NodeInfo sent.
    Reception from a stock Meshtas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
    [sx1262_mesh.c]
2026-10-21 Emulator: shared radio channel with listen before talk and collisions
    A packet now goes out when its transmission starts and is delivered at
    the end of its time on air, so the channel is busy in between. A sender
    waits for a free channel plus a random backoff of 0-7 slots of 4
    symbols, like CAD on the board. Packets overlapping at a receiver are
    lost, and the radio cannot receive while it transmits.
2026-10-21 GPS service, position sharing and GPS screen
    src/gps.c switches the receiver through device PM (off, fixed position,
    every 5/15/30/60 min until 3 fixes with HDOP <= 5 or 120 s, always on),
    sets the clock from fixes and passes new positions to the mesh. The mesh
    broadcasts POSITION_APP after the first fix, every 15 min, on a sharing
    change and after moving 100 m (at most every 30 s), exact or approximate
    (precision_bits 13), and answers position requests. Node details show
    distance and bearing. New screens: GPS status, Settings -> Position.
    In the emulator, Zephyr's GNSS emulator is fed by emul/gps_sim.c
    (--gps, --gps-move, --gps-ttff). On the board the M10 receiver is not
    in the devicetree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
    [clock.c, clock.h, gps.c, gps.h, i18n.c, main.c, menu.c]
2026-10-21 Defaults: contrast 110, German menus; apply stored contrast at boot
    The display was too contrasty at 0x85 on the board. The stored contrast
    was only applied when the display woke from off, so at boot the panel
    always ran at the driver's devicetree default; main() now applies it
    right after loading the settings.
2026-10-21 Board: log and console over USB CDC ACM
    The board enumerates as "befi CMD-Z5" (Zephyr's sample ID 2fe3:0004)
    and puts the log and console on /dev/ttyACM0, so no J-Link is needed to
    read it. The 8 KB TX FIFO keeps the boot messages until the host opens
    the port; when it is full, newer output is dropped without blocking.
    RTT stays a second log backend.
2026-10-21 MCUboot with USB serial recovery; firmware update over USB
    The board build now uses sysbuild: MCUboot (64 KB, single application
    slot of 480 KB at 0x10000) plus the signed application. The language
    models, settings and LittleFS keep their partitions, and an update does
    not touch them.
    Ways into MCUboot's serial recovery (SMP over USB CDC ACM, "CMD-Z5
    bootloader"): the 1200-baud touch on the application's USB port or
    Settings -> Firmware update (src/update.c sets the boot mode in
    GPREGRET1 and restarts), the power key still held 2 s after switch-on,
    or no valid application. tools/usb/update.sh does the touch, uploads
    with smpmgr and restarts (about 25 s).
    modules/lm_image now merges the sig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
2026-10-21 GPS: u-blox M10 driver with switched supply
    The TBS M10N (u-blox M10, SPG 5.10) runs at its factory settings: NMEA
    at 38400 baud on UART0. drivers/gnss/gps_m10.c (cmdz5,gps-m10) feeds
    GGA and RMC to Zephyr's NMEA 0183 parser. Device PM switches the 5 V
    boost (P1.03) and the UART together, so the GPS service can turn the
    receiver on and off; while it is off the UART pins are in their sleep
    state and cannot back-power it. Zephyr's gnss-nmea-generic driver cannot
    be suspended, and its u-blox driver is for the M8.
    MCUboot keeps UART0 disabled, so the bootloader does not drive the TX
    line into the unpowered receiver.
    Tested on the board indoors: receiver on at boot, start-up messages and
    GGA/RM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
2026-10-21 Board: REG1 back in DC/DC mode
    With L3 replaced, the lock-up after switching REG1 to DC/DC is gone.
    Tested on the board: application alone and MCUboot plus application,
    each after a soft reset and after a power cycle (RESETREAS 0, DCDCEN 1),
    no errors. LDO stays the documented fallback.
2026-10-21 Audio PWM: play the last block of a sound
    When fill() returned false, refill() zeroed the block, although fill()
    had filled it with the end of the sound. Any sound shorter than one
    block (16.4 ms, including its release) was silent on the board: key
    clicks and wheel ticks. The emulator plays that block, so it did not
    show there. The earpiece offset now ramps down from the first silent
    block on, and the audio_out header says that fill() always fills.
    [audio_pwm.c]
2026-10-21 Power key, off state on USB, mesh time, time zone, telemetry
    Power key: a short press goes to the home screen (or only wakes the
    display), with a key click; a long press and release switches off with a
    C major arpeggio from top to bottom (C6 G5 E5 C5). With USB power the
    nPM1300 cannot stay in ship mode, so the board restarts into an off
    state (marked in GPREGRET2): display, mesh and GPS off, battery charging;
    holding the power key switches on, unplugging USB enters ship mode.
    Time: the clock ranks its sources (none < mesh < GPS < PC). The time
    field of received Position and Telemetry packets sets it while there is
    no better time, as stock firmware does: after 2026-01-01, not via MQTT,
    at m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
    [clock.c, clock.h, gps.c, hw.c, hw.h, i18n.c]
2026-10-22 Battery: interim display while charging
    The fuel gauge uses Nordic's example battery model, which reaches 99 %
    while the charger is still in its constant-current phase (seen on the
    board at 156 mA and 3.99 V), and then has no time to full. Until there
    is a model of the real cell:
    - the shown state of charge is at most 95 % during the constant-current
    (and trickle) phase,
    - runtime and time to full are chosen by the charger state instead of
    the sign of the measured current,
    - the diagnostics screen shows "Full in" while charging, "-" when the
    gauge has no estimate.
2026-10-22 Own fuel gauge for the phone's cell, charging at 400 mA
    The cell is a 1200 mAh / 3.85 V LiHV cell from an old Android phone,
    charged to 4.2 V only. nRF Fuel Gauge needs a model profiled with the
    nPM1300 EK, and with its example model it showed 99 % while the charger
    was still in its constant-current phase. src/gauge.c replaces it, built
    on assumptions: 1000 mAh usable, about 1 ohm internal resistance
    (measured with the GPS switched on), a typical LiHV open-circuit voltage
    curve scaled to full at 4.2 V. It counts the measured current, sets
    100 % when the charger reports complete, pulls the count towards the
    voltage estimate when the battery has been nearly at rest for 5 min
    (slowly, beyond 5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
    [battery.c, battery_npm13xx.c, gauge.c, gauge.h, update.c]
2026-10-23 Mesh: switch for relaying, relayed packets in diagnostics
    Settings -> Mesh -> Relay packets turns the rebroadcasting of other
    nodes' packets off (stored under mesh/relay, default on), like
    Meshtastic's CLIENT_MUTE role: the device still receives and sends its
    own packets. Diagnostics shows the number of rebroadcasts sent since the
    start (the queued ones that were cancelled because another node relayed
    first are not counted). mesh_get_stats() also gives the received and
    sent frames for later use.
    Tested in the emulator with two instances: with relaying on, B relayed
    A's packet; with relaying off the count stays at 0.
2026-10-29 GPS screen: satellites in view and their signal strength
    Parses GSV (CONFIG_GNSS_SATELLITES): satellites in view of all systems,
    how many are heard, and the four strongest C/N0 values, to tell a deaf
    antenna from weak reception while searching.
2026-10-29 Messages: error tone on failure, failed text offered for retry
    A failed message (no ACK, nobody relayed it, or not sent at all) plays
    two low falling tones. Opening the editor in that conversation then
    starts with the failed text, once per message and only when the editor
    is empty.
    [compose.c, main.c]
2026-10-29 Second game: Hexenflug, and a Games menu
    A witch steered by the wheel evades bats, crows, church towers and storm
    clouds scrolling in from the right and collects stars; three hearts, a
    slowly rising pace, an own looping tune in the background and a stored
    best score. Menu -> Games lists both games.
2026-10-29 Battery cover (build123d) and photos/scan of the original pack
    mech/battery_cover: FDM-printable 2 mm cover with the two tabs, STL/STEP
    and a thin fit-test print; the latch is not modelled yet. hw/: scan of
    the original battery and photos of battery and compartment.
    [battery_cover.step, battery_cover.stl, battery_cover_fit_test.stl]
2026-10-30 Private channels with number or passphrase keys and QR codes
    Settings > Mesh > Channels: up to three private channels next to the
    primary one, each with its own conversation. The key is either a
    Meshtastic 1-byte number key (1..255, separates groups, not secret) or
    an AES-128 key from SHA-256 of a passphrase (case and extra spaces
    ignored). The channel's QR code is a Meshtastic link with ?add=true
    holding only that channel, so the app adds it without touching the
    primary channel or the LoRa settings.
    Messages are addressed by conversation id (channels count down from
    CONV_CHANNEL); deleting a channel deletes its messages (new log record).
    lib/qrcodegen: Nayuki's QR code generator (MIT), fro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
2026-10-30 Ignore KiCad backups and export leftovers, Python caches, trash/
2026-11-02 Bootloader: screen in USB recovery, leave it without a host
    Holding the power key about 1 s to wake from ship mode could land in
    MCUboot's serial recovery, which showed nothing and waited forever: the
    device looked dead on battery. The recovery key delay is now 10 s
    (MCUboot only waits while the key is held), and MCUboot action hooks
    (boot/) show a screen in recovery (display supply via the nPM1300's
    load switch 1, bus driven on the GPIO registers; the image is made with
    the device's fonts by tools/bootscreen/) and restart into the app after
    1 s without USB power, or 15 s with USB power but no host (a charger).
    The bootloader has to be flashed over SWD.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
2026-11-02 Radio noise test; nRF52840 on its LDO by default
    Hardware test > Radio noise shows the SX1262's noise floor (median of
    instantaneous RSSI samples while receiving, readings that overlap a
    packet are dropped), averaged per condition, and the last received
    frame's RSSI/SNR. Keys switch the suspects: GPS, backlight, display,
    the nRF52840's DC/DC, forced PWM on BUCK1 or BUCK2, the SX1262's own
    regulator, the radio's reset line and the RF switch's receive path.
    Measured on the first board: the nRF52840's DC/DC raised the floor by
    about 4 dB, so REG1 now runs on its LDO. Forced PWM makes it worse
    (BUCK1 +4 dB, BUCK2 +13 dB) and stays off; the SX1262 regulator, the
    reset line and a capacitor on RF_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
    [hw.c, hw.h, hwtest.c, i18n.c]
2026-11-02 Board exports, reference photos, display logic captures
    KiCad: STEP/STL models, production files (BOM, positions, netlist,
    gerbers), a PDF print, footprint table, fabrication toolkit options and
    photos/scans of the original board. Display: DSLogic captures of the
    original phone's display bus and the frames decoded from them.
    Claude-Session: https://claude.ai/code/session_011BWCWuYDfKZbBKuM1zCB3J
    [bom.csv, cmd-z5.step, cmd-z5.stl, designators.csv, positions.csv]
2026-11-03 Battery: 603450 LiPo (1100 mAh, 4.2 V)
    Fuel gauge, emulated battery and gauge test for the new cell: 1100 mAh
    usable, about 200 mOhm, a typical LiPo open-circuit voltage curve instead
    of the scaled LiHV one. The charger settings (4.2 V, 400 mA) already fit.
    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
2026-11-03 Switch off when the battery is empty
    Below 3.3 V for 10 s without USB (0 % on the cell's curve) the device
    shows "Battery empty", saves the gauge state and enters ship mode, instead
    of running on until the cell's protection cuts off at 2.75 V.
    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
2026-11-03 Predictive text: ignore keys no word fits, keep the space before ":)"
    - A key after which no word in the lexicon fits is ignored and sounds a
    short low tone; unknown words are typed in multitap (#). Replaces the
    multitap rest of the word, which did not work out in use.
    - Only a sentence end (. ! ?) takes the automatic space after a word;
    other punctuation keeps it ("hallo :)"). Stepping through key 1 or
    deleting the pending character brings the space back.
    - Long C while a word is being typed deletes only that word.
    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
    [compose.c]
2026-11-03 Mesh: PKI direct messages, bounded node storage; games menu, delete chats
    - A DM to a node whose public key is unknown waits up to 30 s for it
    (NodeInfo request): current Meshtastic firmware refuses DMs without
    PKI with NO_CHANNEL. A NAK because the node lacks our key sends our
    NodeInfo and the DM again.
    - Nodes: at most 48 stored; a full table replaces nodes without user
    info first, then the one heard longest ago (wall clock, stored), and
    deletes it from the settings. Nodes with a DM conversation stay.
    Before, 85 stored nodes overflowed the 48-node table at every boot.
    - Chat: received messages alternate the time with RSSI/SNR (direct) or
    the hop count; messages received befor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
    [chat.c, home.c, i18n.c, inbox.c, main.c, menu.c]
2026-11-06 MeshCore as a second protocol; conversation menu
    MeshCore (lib/meshcore, src/mesh/meshcore.c), switchable with Meshtastic
    in Settings > Mesh > Protocol (restart). Own implementation of MeshCore 1.18:
    packets, signed adverts (Ed25519, SHA-512), shared secrets, encrypt-then-MAC,
    DMs with ACK, retries and learned routes, Public/hashtag/private channels,
    region scopes (transport codes). Each protocol keeps its own identity,
    contacts, channels and messages. Host tests (tests/meshcore) and a
    two-instance emulator test (tests/emul/run_meshcore.sh); tested over the air
    against a MeshCore 1.18 companion.
    Messages: bending the wheel down opens a menu for the conversation:
    silence it or delete its mes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
